ionutms/KiCAD_Symbol_Generator/3D_models/C_1210.step

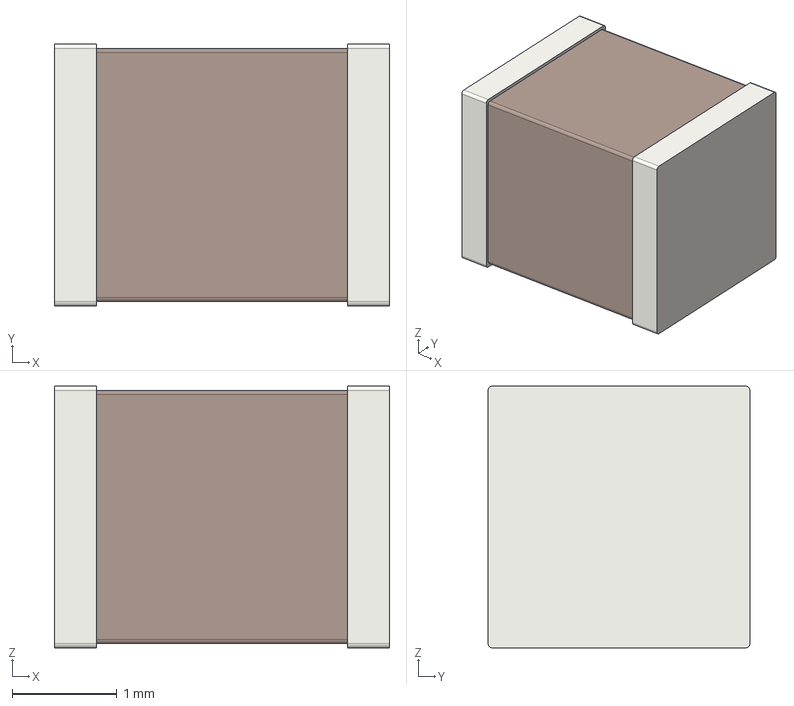
[picture p1: CAD file, 2024-12-10]
3D_models/C_1210.step
3.20 x 2.50 x 2.50 mm
