ionutms/KiCAD_Symbol_Generator/3D_models/SOD_123F.step

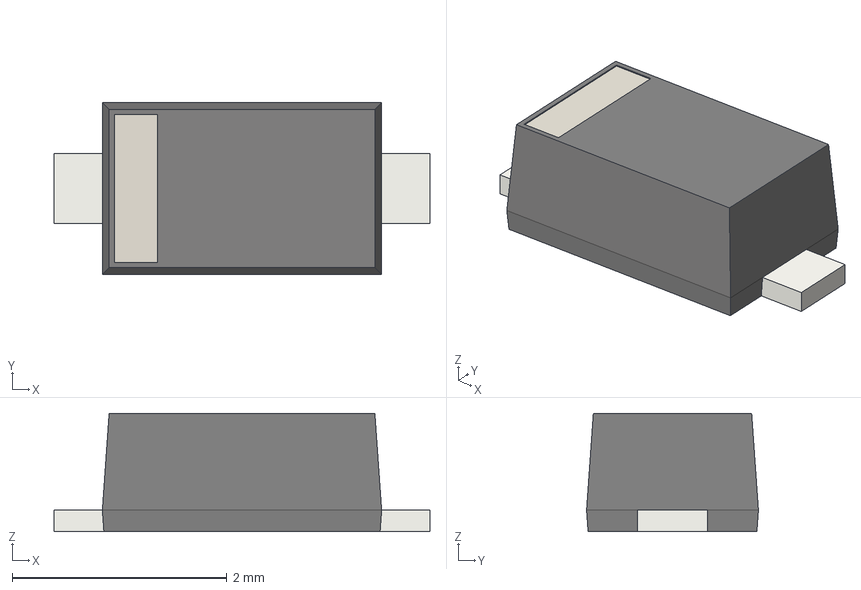
[picture p2: CAD file, 2024-12-09]
3D_models/SOD_123F.step
3.50 x 1.60 x 1.10 mm
