ionutms/KiCAD_Symbol_Generator/3D_models/PowerPAK SO-8.step

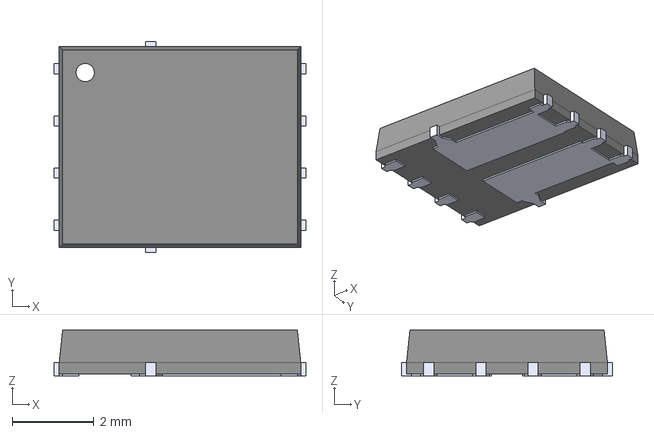
[picture p3: CAD file, 2024-12-05]
3D_models/PowerPAK SO-8.step
6.15 x 5.16 x 1.12 mm
