ionutms/KiCAD_Symbol_Generator/3D_models/LFPAK56D-8.step

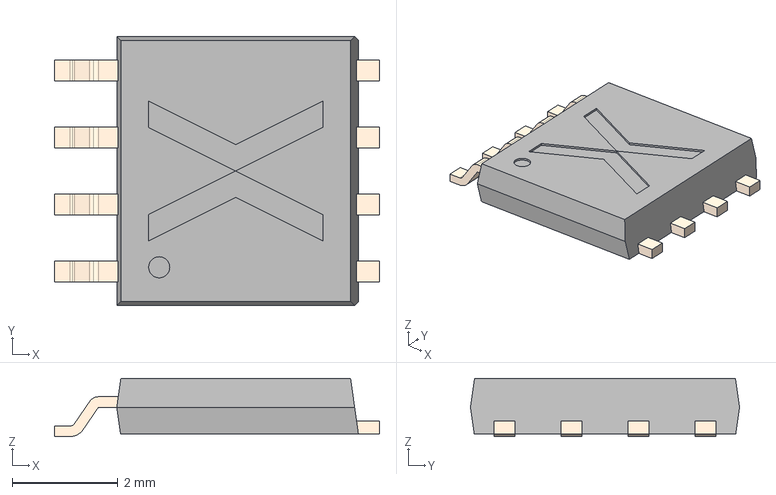
[picture p4: CAD file, 2024-12-03]
3D_models/LFPAK56D-8.step
6.16 x 5.10 x 1.10 mm
