ionutms/KiCAD_Symbol_Generator/3D_models/PowerPAK 1212-8.step

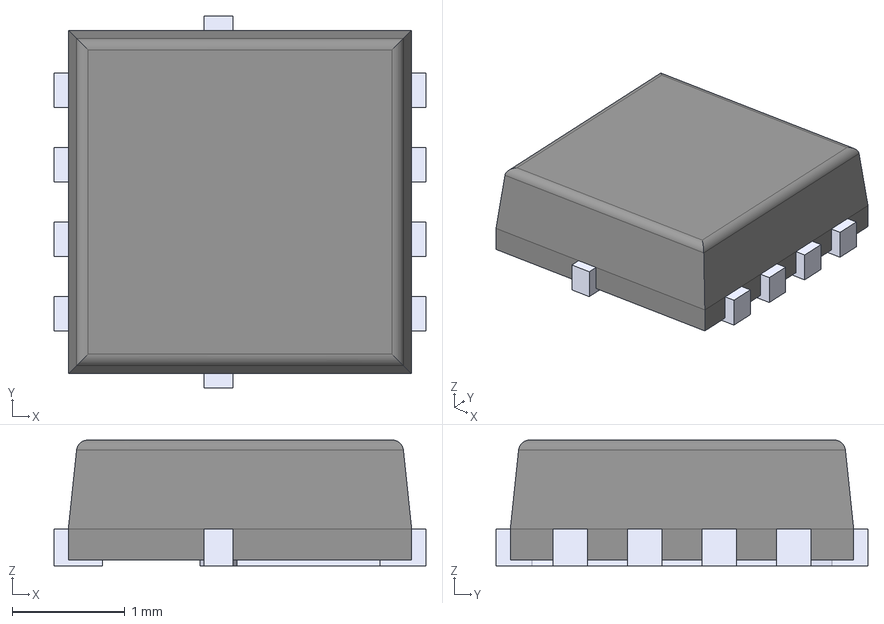
[picture p5: CAD file, 2024-12-03]
3D_models/PowerPAK 1212-8.step
3.30 x 3.30 x 1.12 mm
