ionutms/KiCAD_Symbol_Generator/3D_models/LFPAK33-8.step

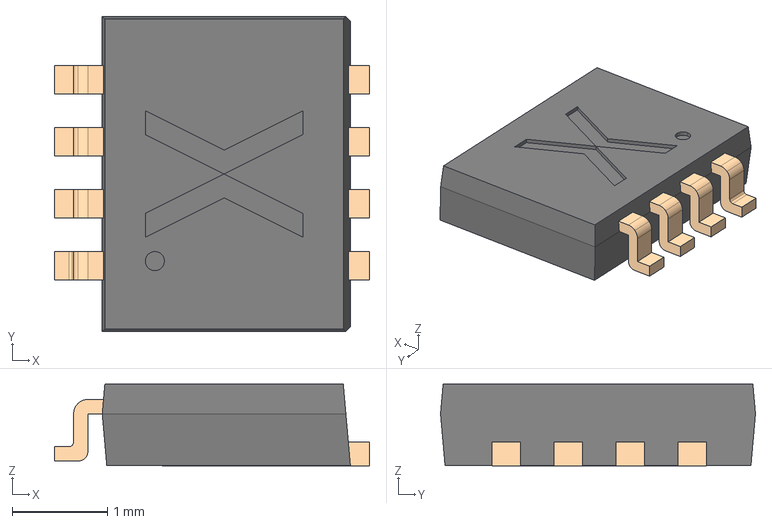
[picture p6: CAD file, 2024-12-03]
3D_models/LFPAK33-8.step
3.30 x 3.30 x 0.855 mm
