ionutms/KiCAD_Symbol_Generator/3D_models/SOD_123.step

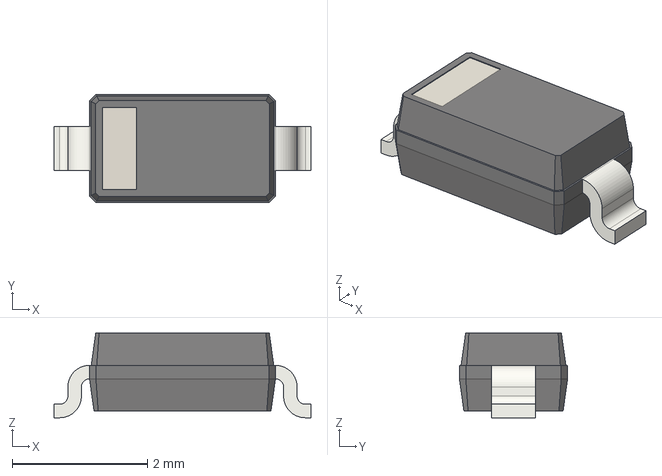
[picture p7: CAD file, 2024-11-30]
3D_models/SOD_123.step
3.80 x 1.60 x 1.25 mm
