ionutms/KiCAD_Symbol_Generator/3D_models/PowerDI_123.step

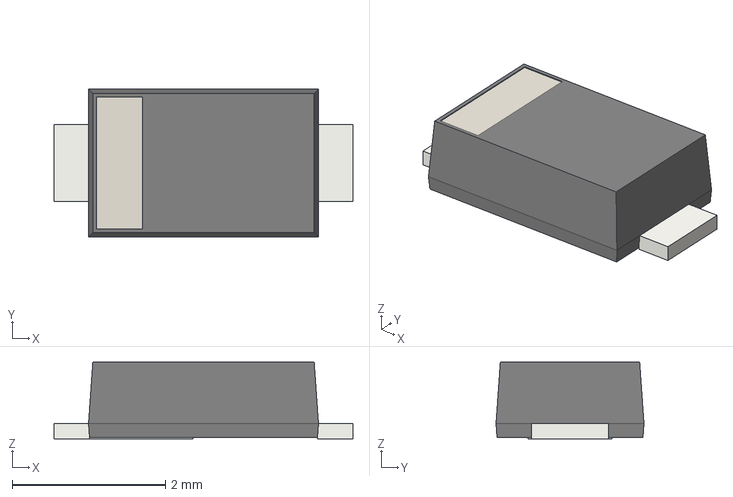
[picture p8: CAD file, 2024-11-26]
3D_models/PowerDI_123.step
3.90 x 1.93 x 1.00 mm
