ionutms/KiCAD_Symbol_Generator/3D_models/ZA9644.step

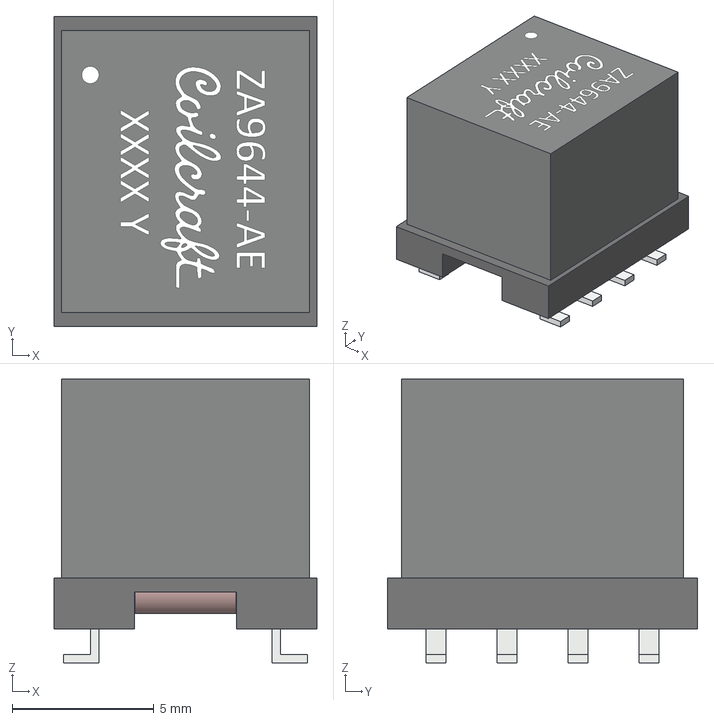
[picture p9: CAD file, 2024-11-20]
3D_models/ZA9644.step
9.25 x 10.9 x 10.0 mm
