ionutms/KiCAD_Symbol_Generator/3D_models/ZA9384.step

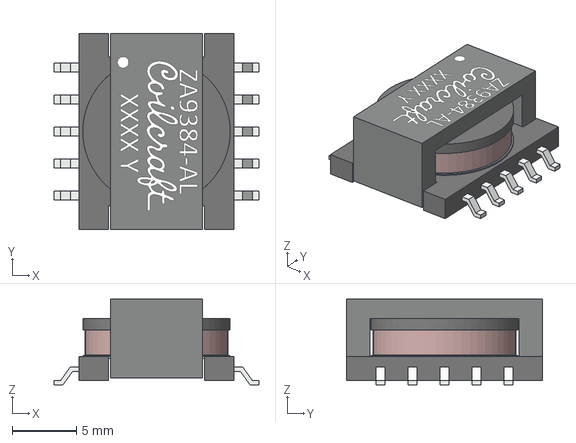
[picture p10: CAD file, 2024-11-20]
3D_models/ZA9384.step
16.0 x 15.3 x 6.70 mm
