ionutms/KiCAD_Symbol_Generator/3D_models/MSD1260.step

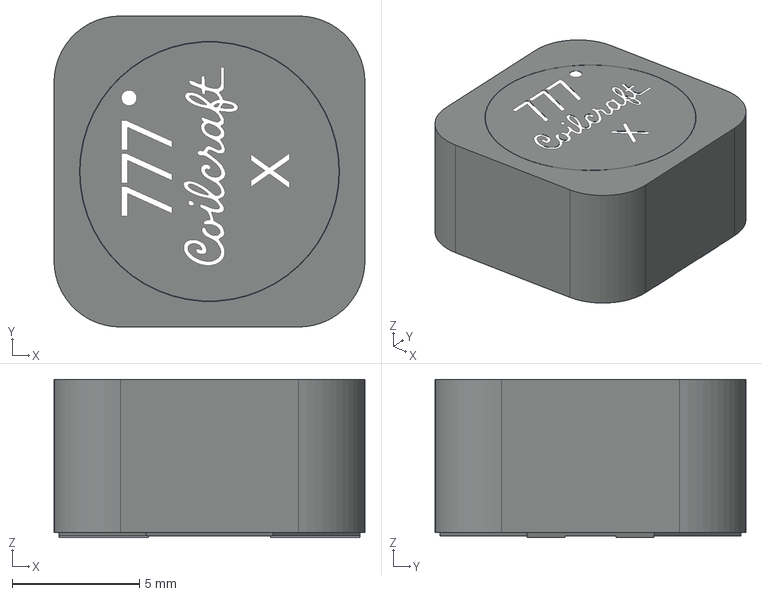
[picture p11: CAD file, 2024-11-20]
3D_models/MSD1260.step
12.2 x 12.2 x 6.20 mm
