ionutms/KiCAD_Symbol_Generator/3D_models/MSD1048.step

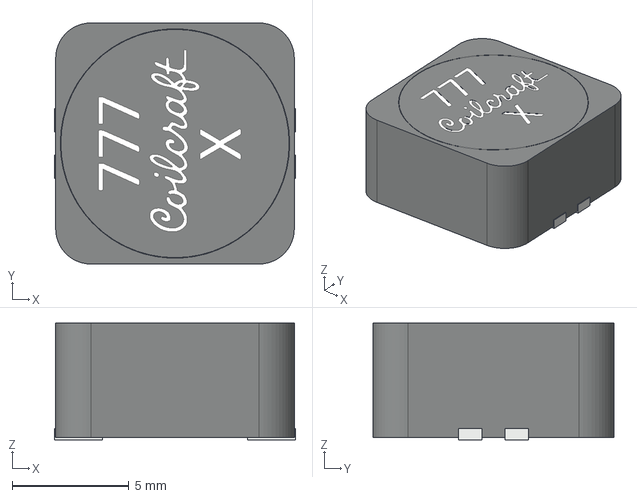
[picture p12: CAD file, 2024-11-20]
3D_models/MSD1048.step
10.3 x 10.3 x 5.00 mm
