ionutms/KiCAD_Symbol_Generator/3D_models/MSD7342.step

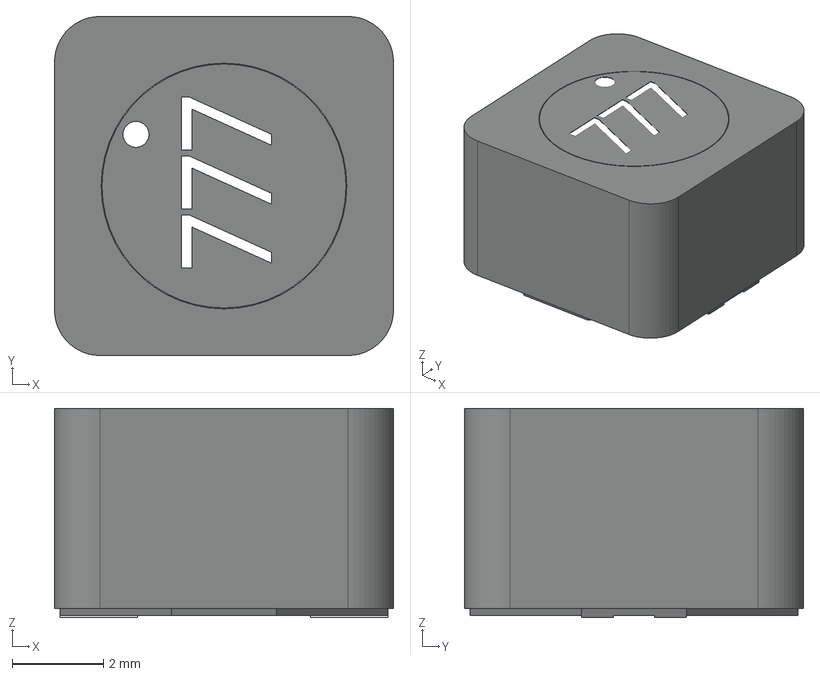
[picture p13: CAD file, 2024-11-20]
3D_models/MSD7342.step
7.45 x 7.45 x 4.60 mm
