ionutms/KiCAD_Symbol_Generator/3D_models/CUI_DEVICES_TBP04R12-500-04BE.step

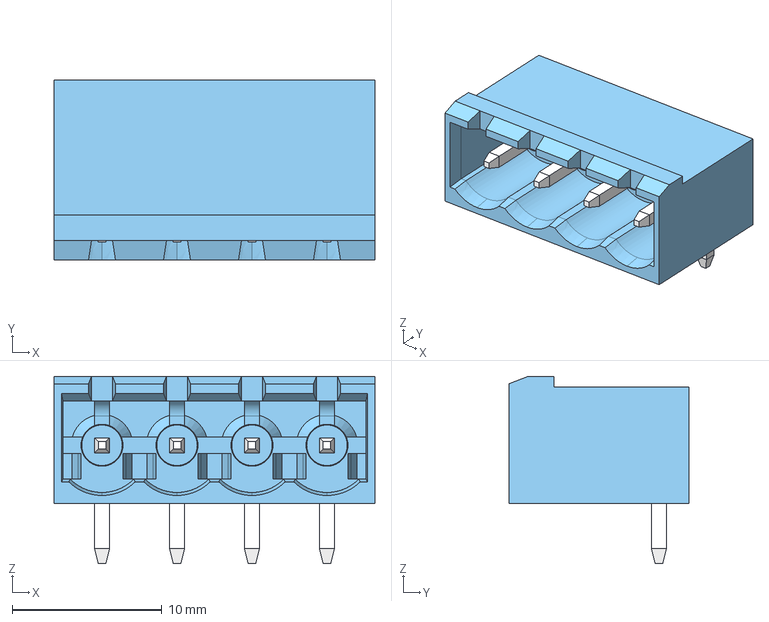
[picture p14: CAD file, 2024-11-18]
3D_models/CUI_DEVICES_TBP04R12-500-04BE.step
21.4 x 12.0 x 12.5 mm
