ionutms/KiCAD_Symbol_Generator/3D_models/CUI_DEVICES_TBP04R12-500-05BE.step

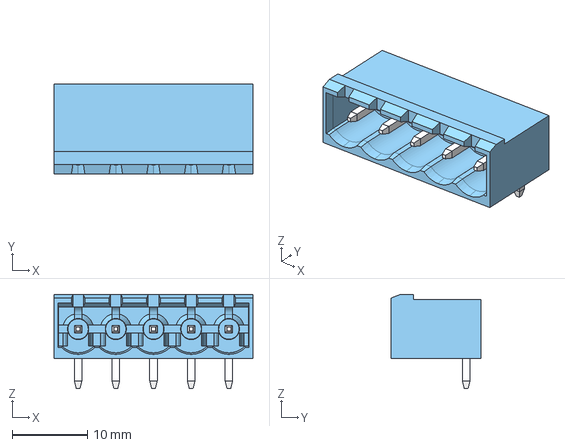
[picture p16: CAD file, 2024-11-18]
3D_models/CUI_DEVICES_TBP04R12-500-05BE.step
26.4 x 12.0 x 12.5 mm
