ionutms/KiCAD_Symbol_Generator/3D_models/CUI_DEVICES_TBP04R12-500-08BE.step

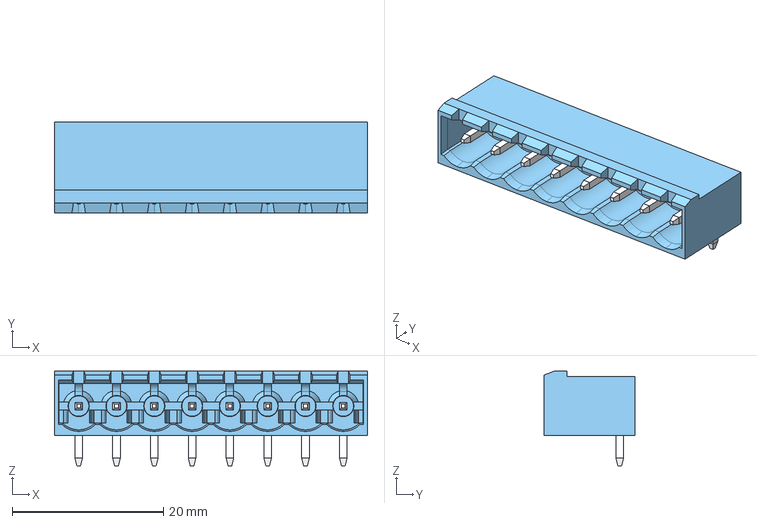
[picture p17: CAD file, 2024-11-18]
3D_models/CUI_DEVICES_TBP04R12-500-08BE.step
41.4 x 12.0 x 12.5 mm
