ionutms/KiCAD_Symbol_Generator/3D_models/CUI_DEVICES_TBP04R12-500-03BE.step

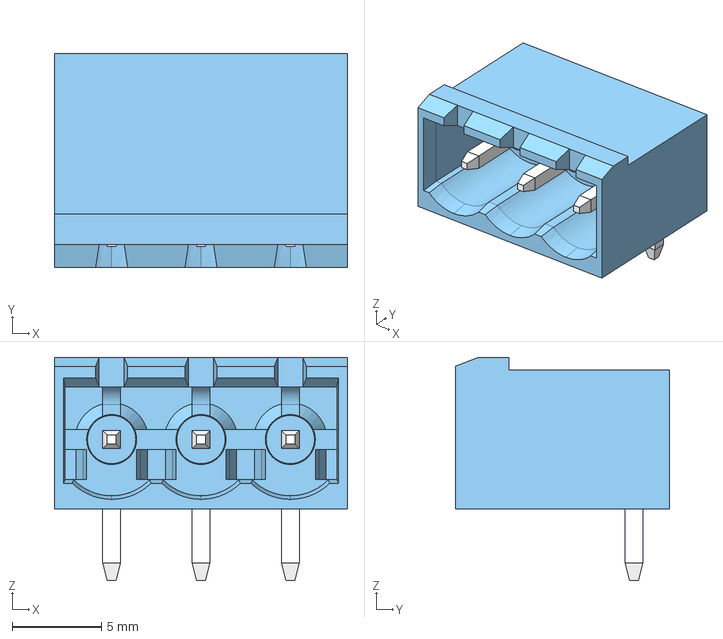
[picture p19: CAD file, 2024-11-18]
3D_models/CUI_DEVICES_TBP04R12-500-03BE.step
16.4 x 12.0 x 12.5 mm
