ionutms/KiCAD_Symbol_Generator/3D_models/CUI_DEVICES_TBP04R12-500-09BE.step

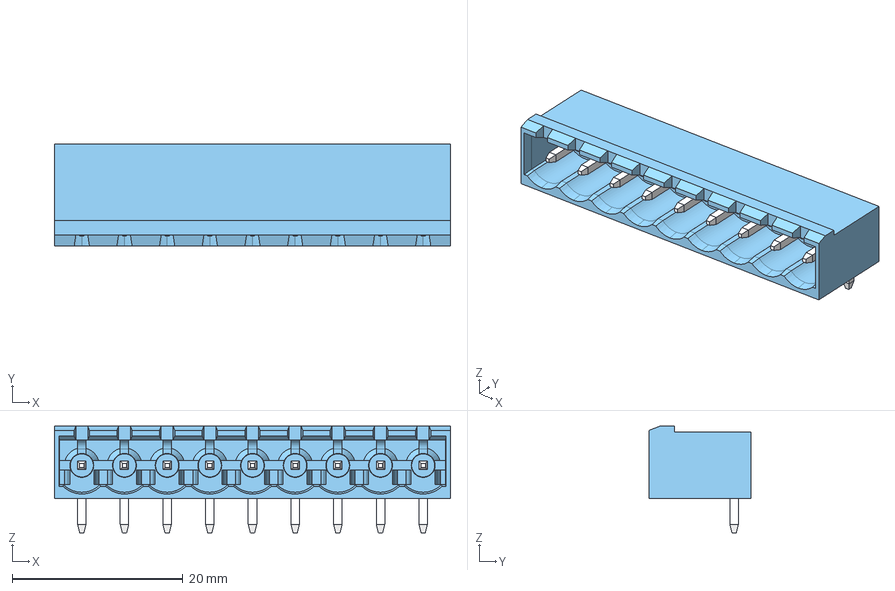
[picture p23: CAD file, 2024-11-18]
3D_models/CUI_DEVICES_TBP04R12-500-09BE.step
46.4 x 12.0 x 12.5 mm
