ionutms/KiCAD_Symbol_Generator/3D_models/CUI_DEVICES_TBP04R3-500-03BE.step

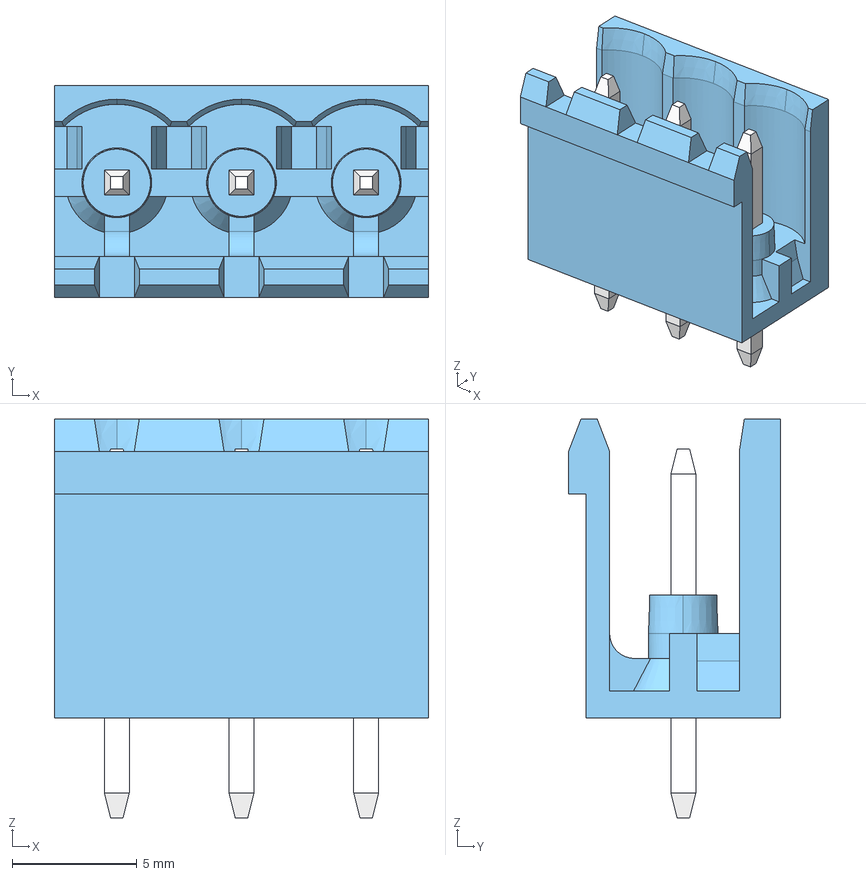
[picture p25: CAD file, 2024-11-18]
3D_models/CUI_DEVICES_TBP04R3-500-03BE.step
15.0 x 8.50 x 16.0 mm
