ionutms/KiCAD_Symbol_Generator/3D_models/CUI_DEVICES_TBP04R2-500-08BE.step

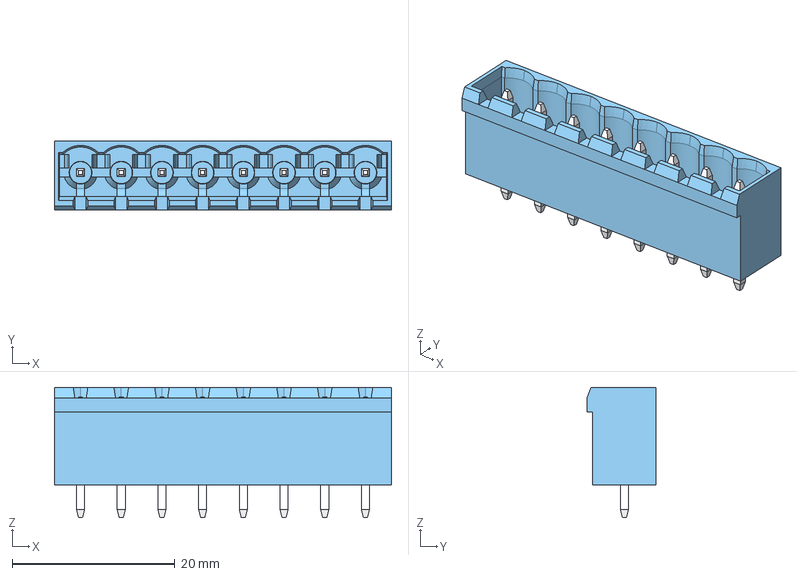
[picture p28: CAD file, 2024-11-18]
3D_models/CUI_DEVICES_TBP04R2-500-08BE.step
41.4 x 8.50 x 16.0 mm
