ionutms/KiCAD_Symbol_Generator/3D_models/CUI_DEVICES_TBP04R2-500-06BE.step

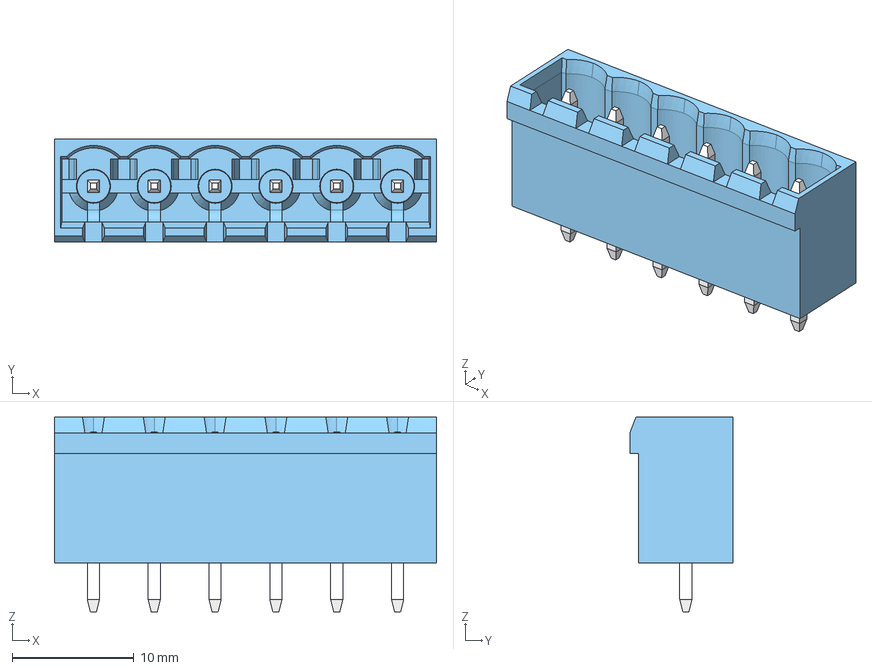
[picture p31: CAD file, 2024-11-18]
3D_models/CUI_DEVICES_TBP04R2-500-06BE.step
31.4 x 8.50 x 16.0 mm
