ionutms/KiCAD_Symbol_Generator/3D_models/CUI_DEVICES_TBP04R1-500-08BE.step

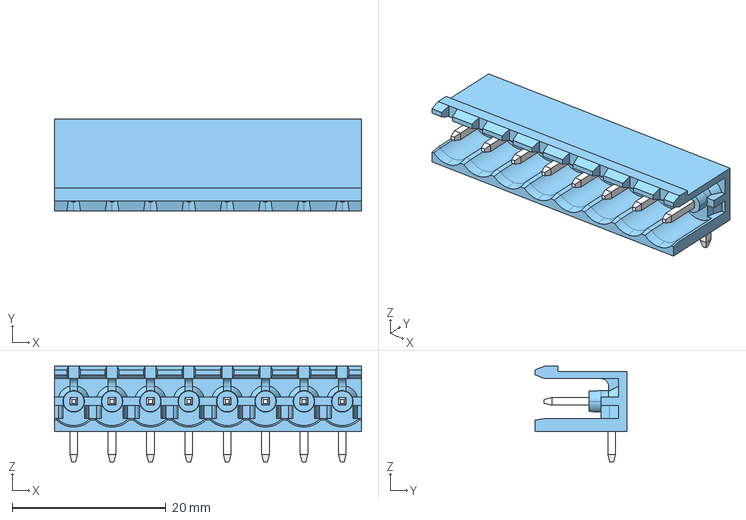
[picture p40: CAD file, 2024-11-18]
3D_models/CUI_DEVICES_TBP04R1-500-08BE.step
40.0 x 12.0 x 12.5 mm
