ionutms/KiCAD_Symbol_Generator/3D_models/CUI_DEVICES_TBP04R1-500-11BE.step

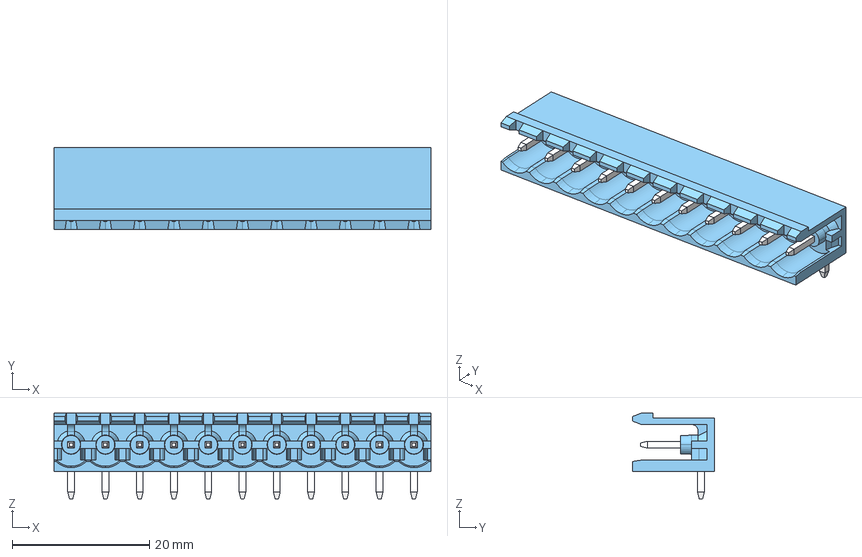
[picture p47: CAD file, 2024-11-18]
3D_models/CUI_DEVICES_TBP04R1-500-11BE.step
55.0 x 12.0 x 12.5 mm
