ionutms/KiCAD_Symbol_Generator/3D_models/CUI_DEVICES_TBP02R2-381-06BE.step

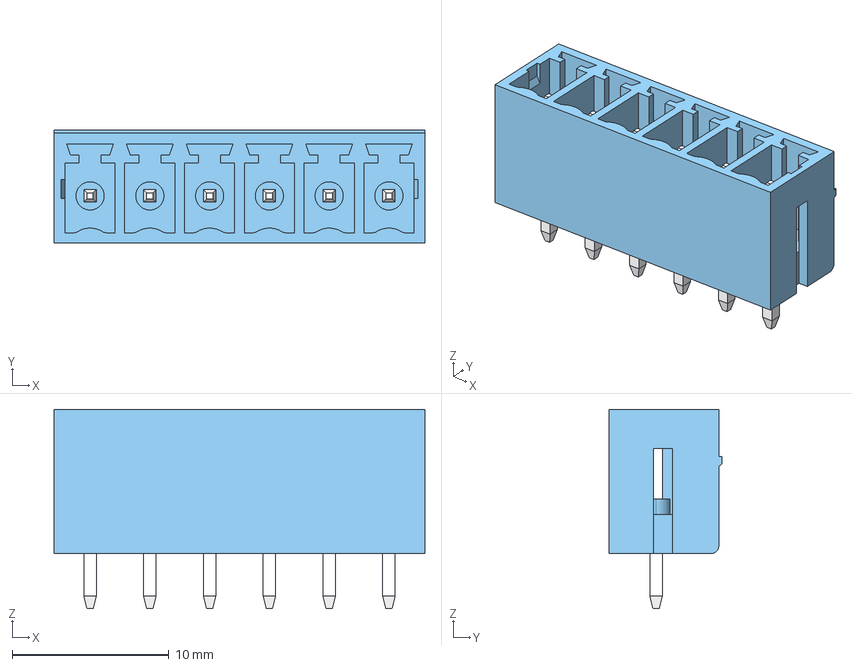
[picture p50: CAD file, 2024-11-18]
3D_models/CUI_DEVICES_TBP02R2-381-06BE.step
23.6 x 7.20 x 12.7 mm
