ionutms/KiCAD_Symbol_Generator/3D_models/CUI_DEVICES_TBP02R2-381-03BE.step

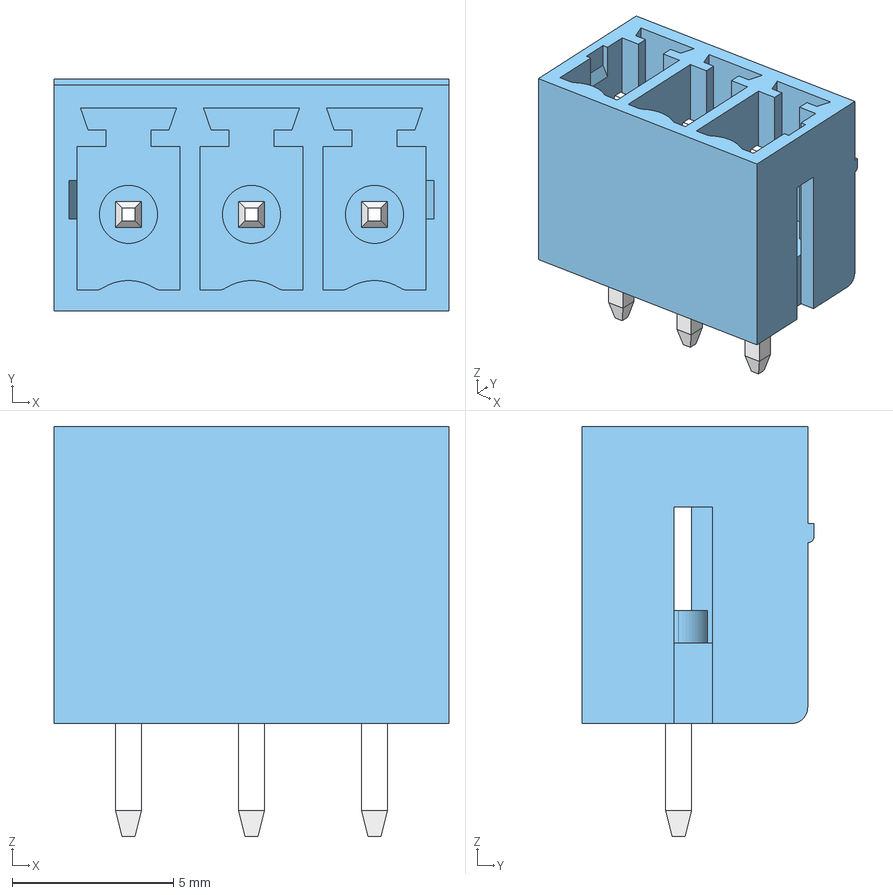
[picture p52: CAD file, 2024-11-18]
3D_models/CUI_DEVICES_TBP02R2-381-03BE.step
12.2 x 7.20 x 12.7 mm
