ionutms/KiCAD_Symbol_Generator/3D_models/CUI_DEVICES_TBP02R2-381-12BE.step

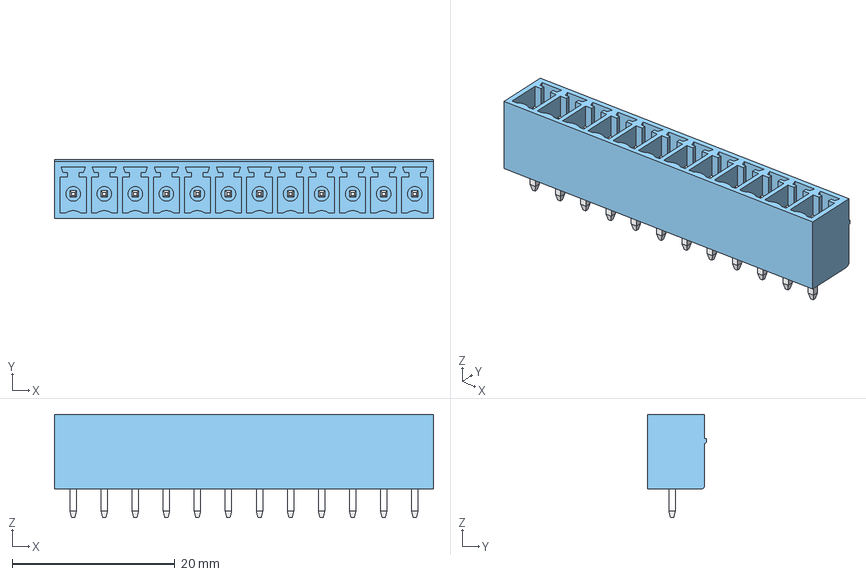
[picture p53: CAD file, 2024-11-18]
3D_models/CUI_DEVICES_TBP02R2-381-12BE.step
46.5 x 7.20 x 12.7 mm
