ionutms/KiCAD_Symbol_Generator/3D_models/CUI_DEVICES_TBP02R2-381-05BE.step

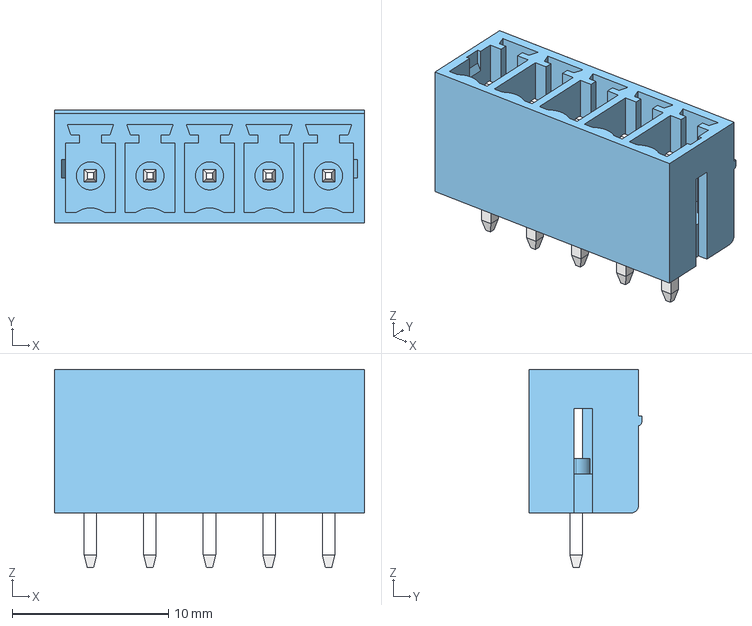
[picture p57: CAD file, 2024-11-18]
3D_models/CUI_DEVICES_TBP02R2-381-05BE.step
19.8 x 7.20 x 12.7 mm
