ionutms/KiCAD_Symbol_Generator/3D_models/CUI_DEVICES_TBP02R1-381-03BE.step

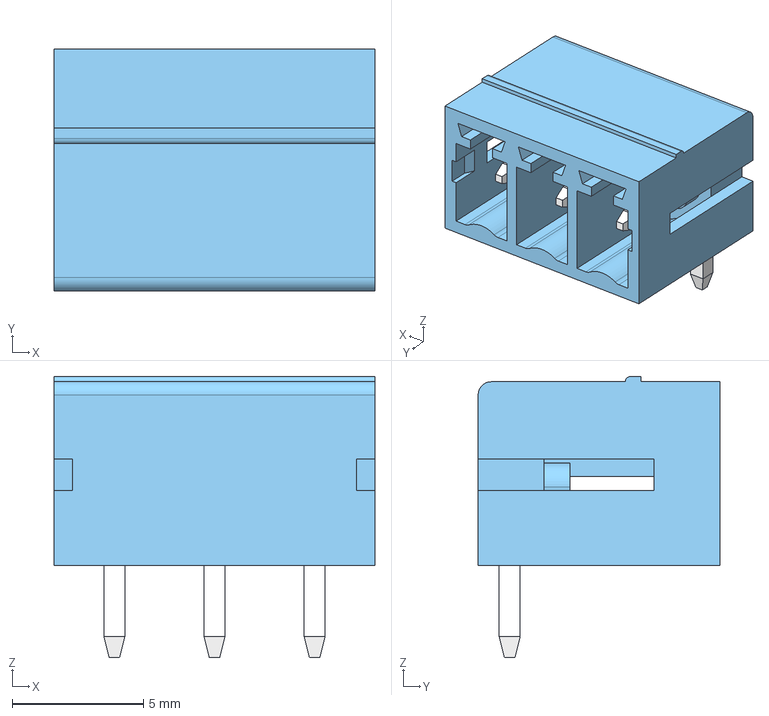
[picture p62: CAD file, 2024-11-18]
3D_models/CUI_DEVICES_TBP02R1-381-03BE.step
12.2 x 9.20 x 10.7 mm
