ionutms/KiCAD_Symbol_Generator/3D_models/XFL7015.step

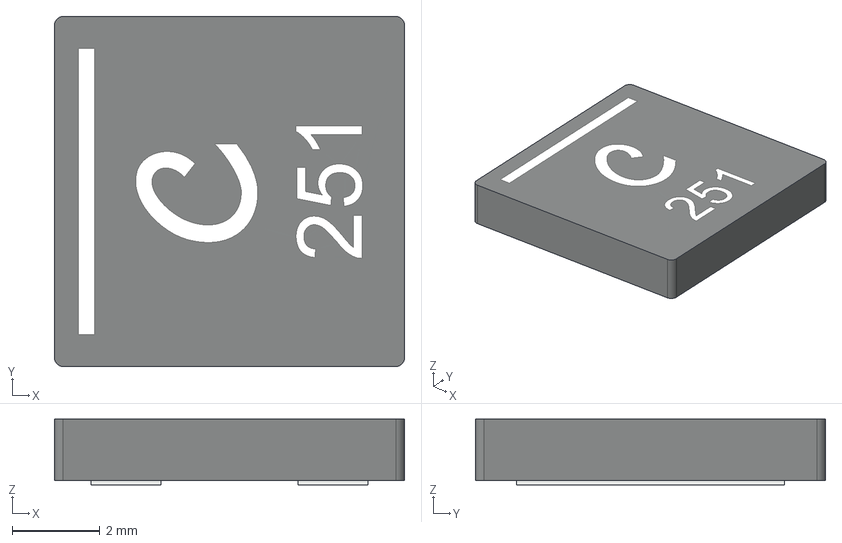
[picture p70: CAD file, 2024-11-16]
3D_models/XFL7015.step
8.00 x 8.00 x 1.50 mm
