ionutms/KiCAD_Symbol_Generator/3D_models/XFL6012.step

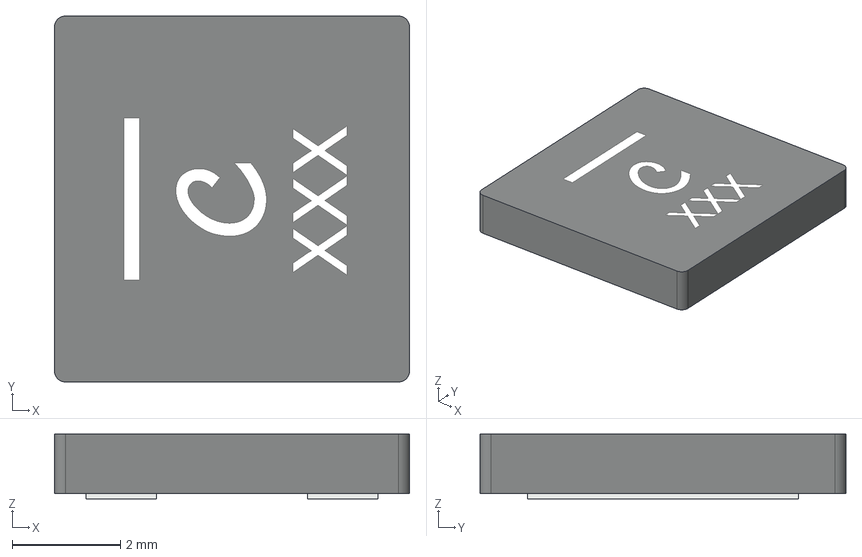
[picture p71: CAD file, 2024-11-16]
3D_models/XFL6012.step
6.56 x 6.76 x 1.20 mm
