ionutms/KiCAD_Symbol_Generator/3D_models/XFL6060.step

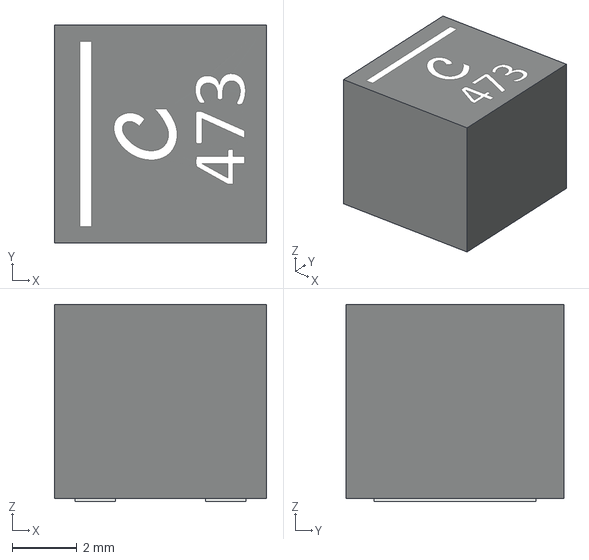
[picture p72: CAD file, 2024-11-16]
3D_models/XFL6060.step
6.56 x 6.76 x 6.10 mm
