ionutms/KiCAD_Symbol_Generator/3D_models/XFL5015.step

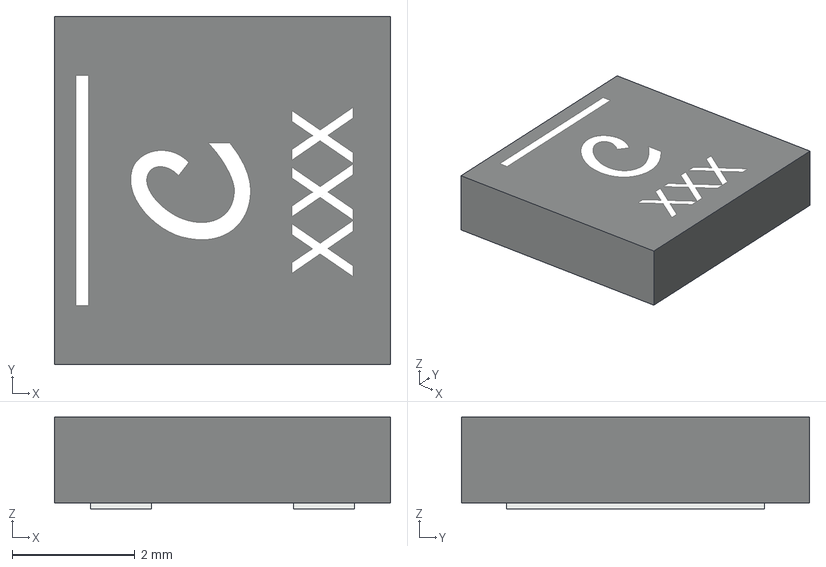
[picture p73: CAD file, 2024-11-16]
3D_models/XFL5015.step
5.48 x 5.68 x 1.50 mm
