ionutms/KiCAD_Symbol_Generator/3D_models/XFL5030.step

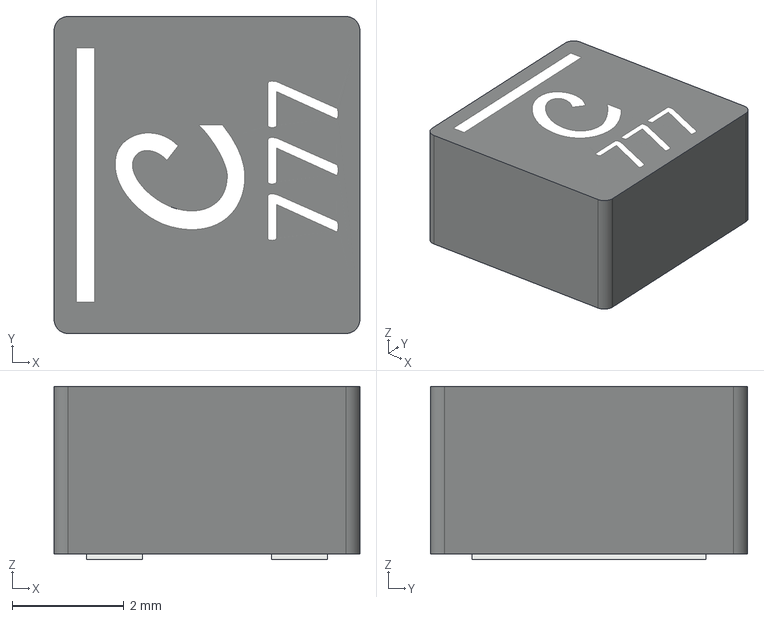
[picture p74: CAD file, 2024-11-16]
3D_models/XFL5030.step
5.48 x 5.68 x 3.10 mm
