ionutms/KiCAD_Symbol_Generator/3D_models/XFL4030.step

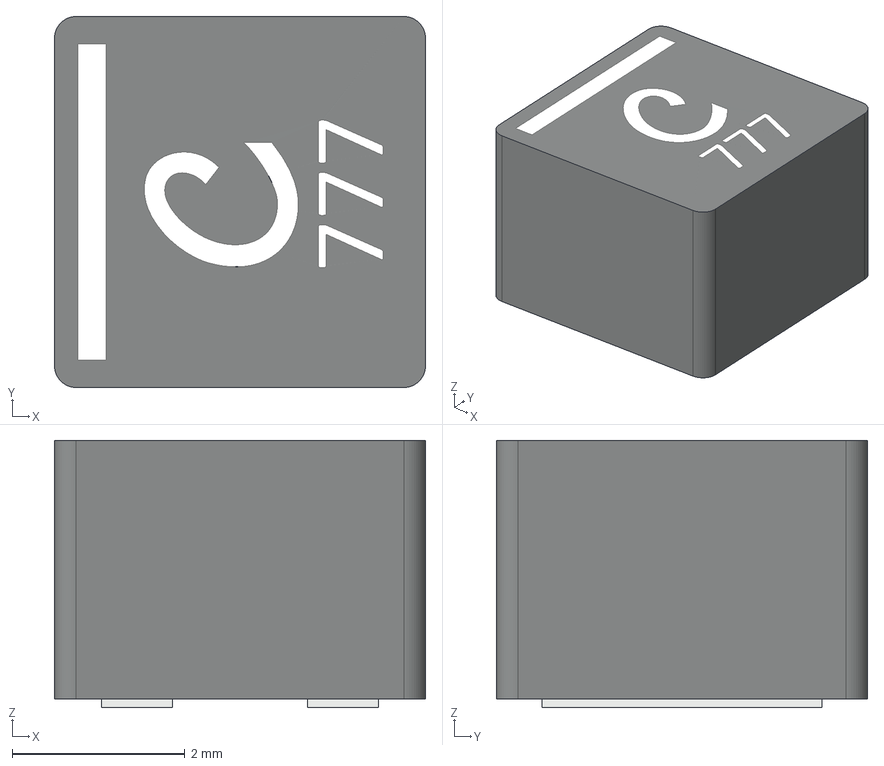
[picture p75: CAD file, 2024-11-16]
3D_models/XFL4030.step
4.30 x 4.30 x 3.10 mm
