ionutms/KiCAD_Symbol_Generator/3D_models/XFL4012.step

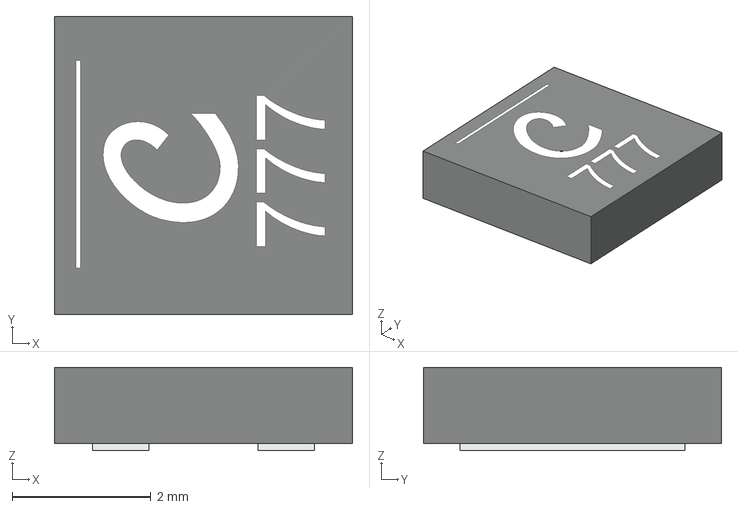
[picture p76: CAD file, 2024-11-16]
3D_models/XFL4012.step
4.30 x 4.30 x 1.20 mm
