ionutms/KiCAD_Symbol_Generator/3D_models/XFL4015.step

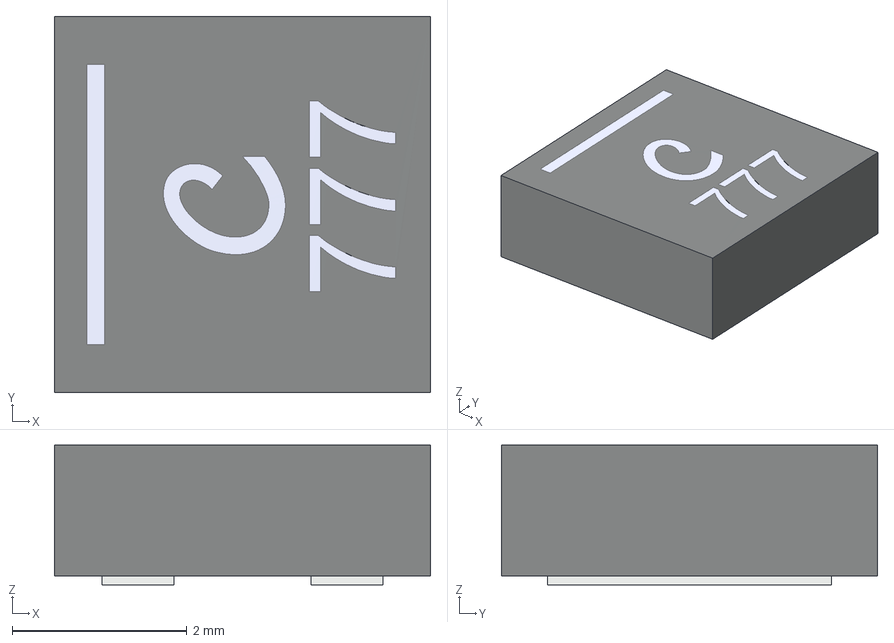
[picture p77: CAD file, 2024-11-16]
3D_models/XFL4015.step
4.30 x 4.30 x 1.60 mm
