ionutms/KiCAD_Symbol_Generator/3D_models/XFL4020.step

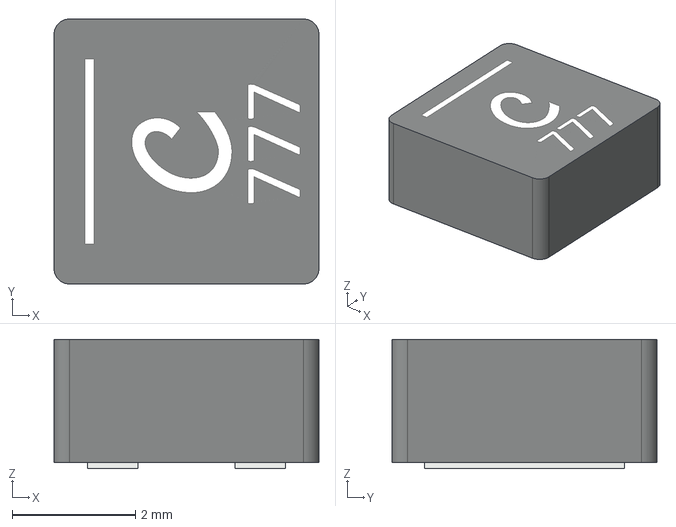
[picture p78: CAD file, 2024-11-16]
3D_models/XFL4020.step
4.30 x 4.30 x 2.10 mm
