ionutms/KiCAD_Symbol_Generator/3D_models/XFL3010.step

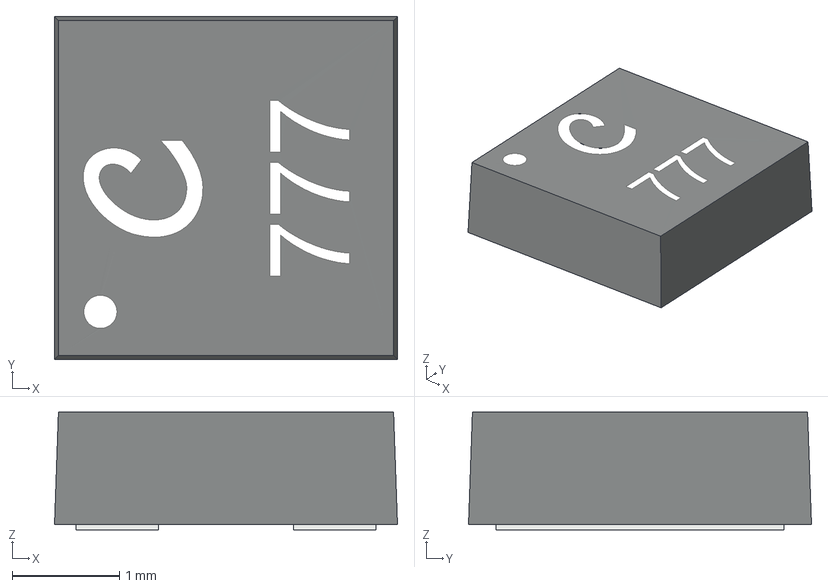
[picture p79: CAD file, 2024-11-16]
3D_models/XFL3010.step
3.20 x 3.20 x 1.10 mm
