ionutms/KiCAD_Symbol_Generator/3D_models/XFL3012.step

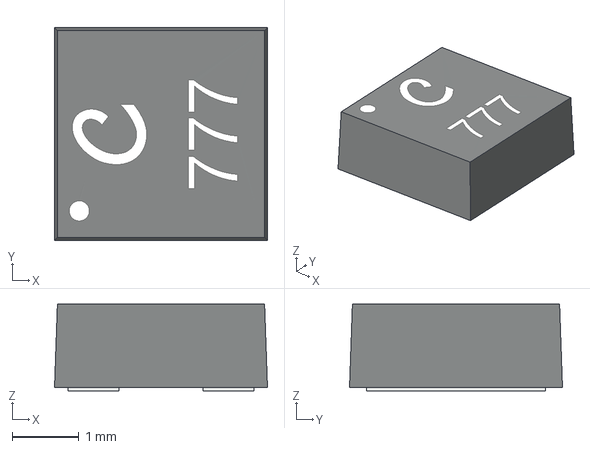
[picture p80: CAD file, 2024-11-16]
3D_models/XFL3012.step
3.20 x 3.20 x 1.30 mm
