ionutms/KiCAD_Symbol_Generator/3D_models/XFL2006.step

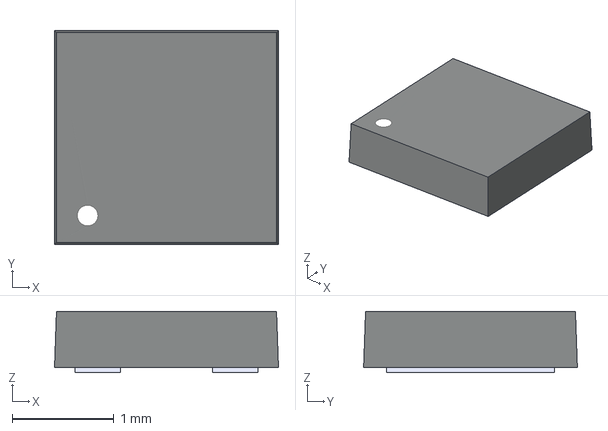
[picture p81: CAD file, 2024-11-16]
3D_models/XFL2006.step
2.20 x 2.10 x 0.6 mm
