ionutms/KiCAD_Symbol_Generator/3D_models/XFL2010.step

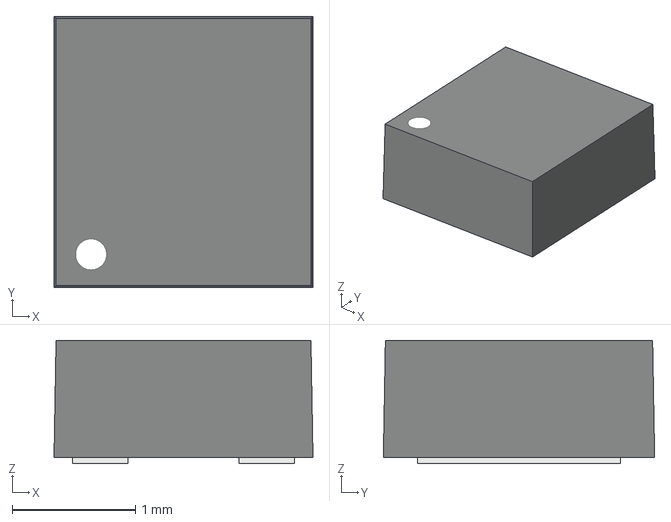
[picture p82: CAD file, 2024-11-16]
3D_models/XFL2010.step
2.10 x 2.20 x 1.00 mm
