ionutms/KiCAD_Symbol_Generator/3D_models/XFL2005.step

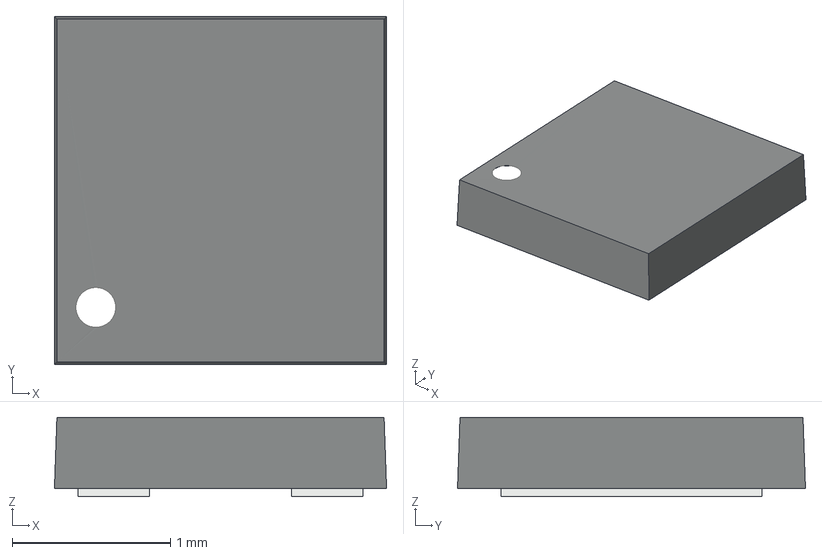
[picture p83: CAD file, 2024-11-16]
3D_models/XFL2005.step
2.10 x 2.20 x 0.5 mm
