ionutms/KiCAD_Symbol_Generator/3D_models/XAL8050.step

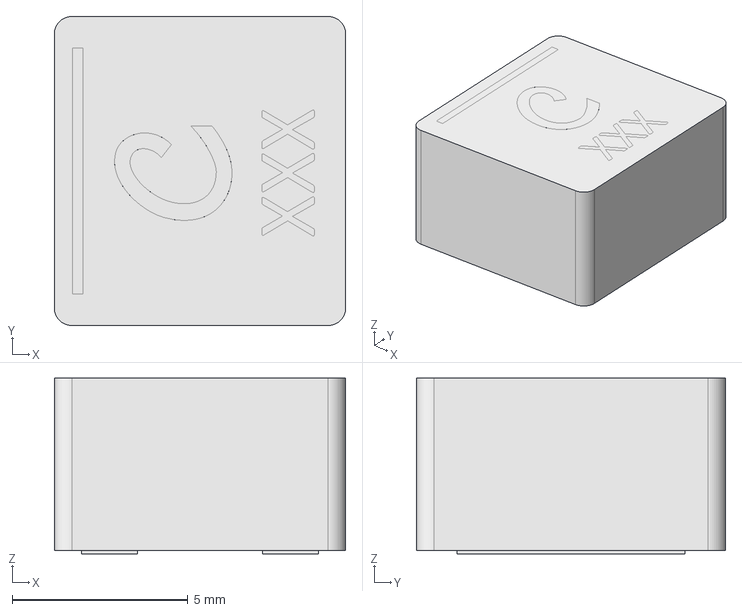
[picture p84: CAD file, 2024-11-16]
3D_models/XAL8050.step
8.30 x 8.80 x 5.00 mm
