ionutms/KiCAD_Symbol_Generator/3D_models/XAL8080.step

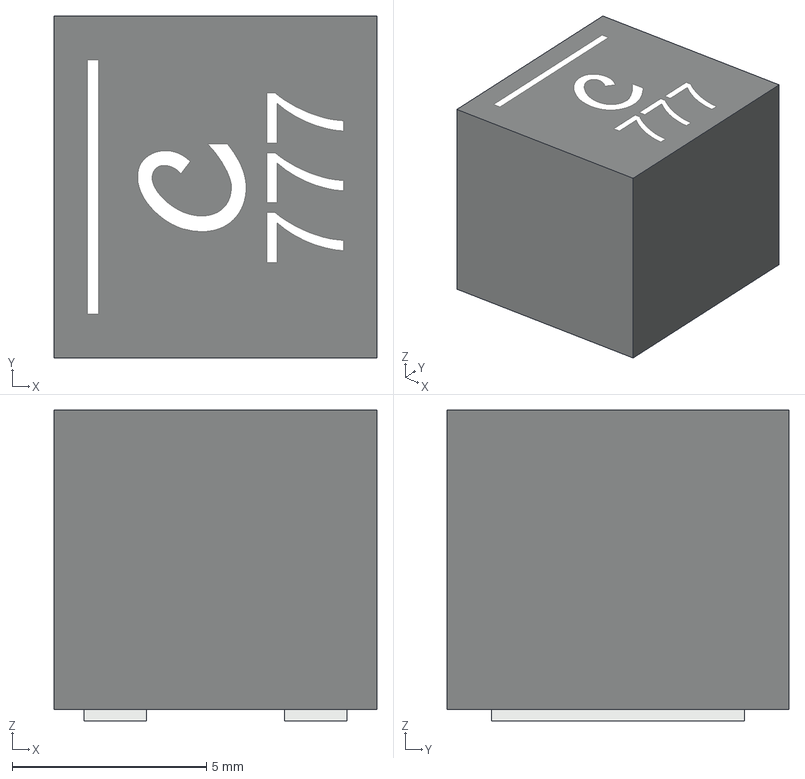
[picture p85: CAD file, 2024-11-16]
3D_models/XAL8080.step
8.30 x 8.80 x 8.00 mm
