ionutms/KiCAD_Symbol_Generator/3D_models/XAL7050.step

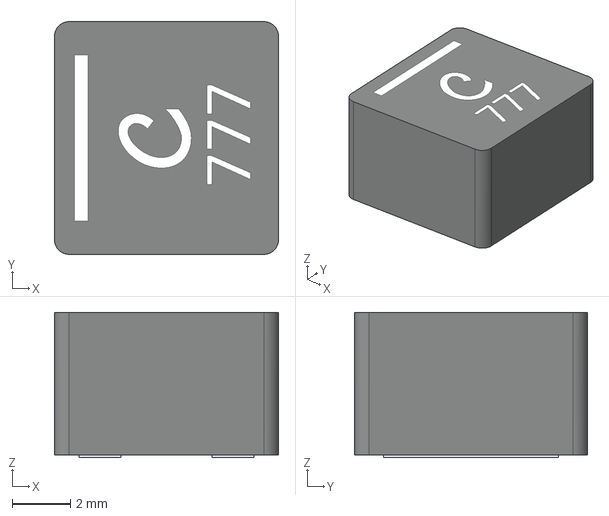
[picture p86: CAD file, 2024-11-16]
3D_models/XAL7050.step
7.70 x 8.00 x 5.00 mm
