ionutms/KiCAD_Symbol_Generator/3D_models/XAL7020.step

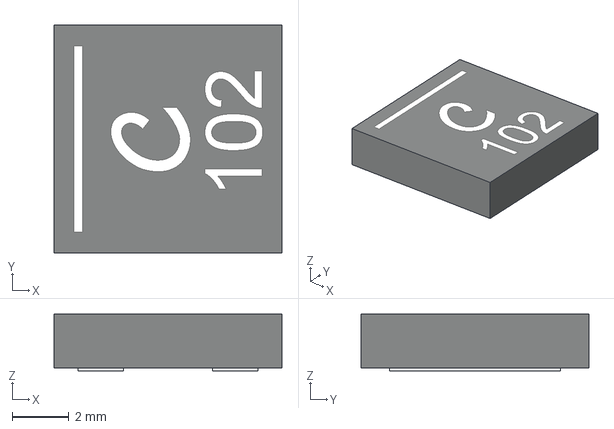
[picture p87: CAD file, 2024-11-16]
3D_models/XAL7020.step
8.00 x 8.00 x 2.00 mm
