ionutms/KiCAD_Symbol_Generator/3D_models/XAL7070.step

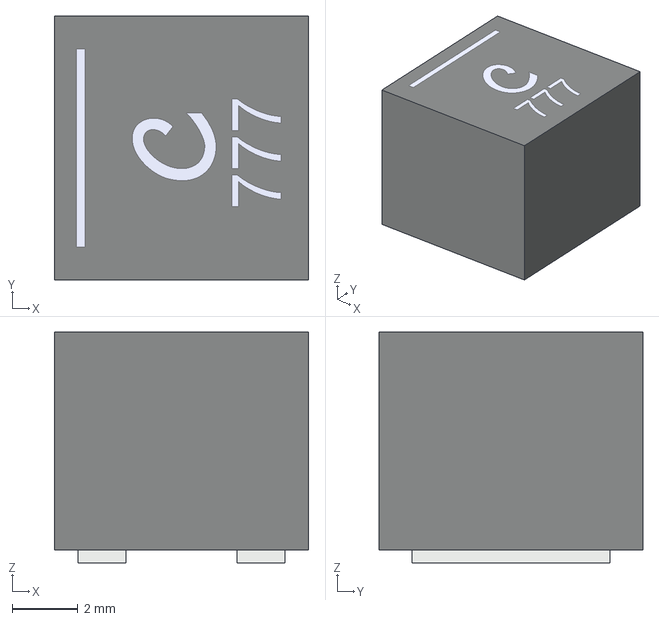
[picture p88: CAD file, 2024-11-16]
3D_models/XAL7070.step
7.70 x 8.00 x 7.00 mm
