ionutms/KiCAD_Symbol_Generator/3D_models/XAL7030.step

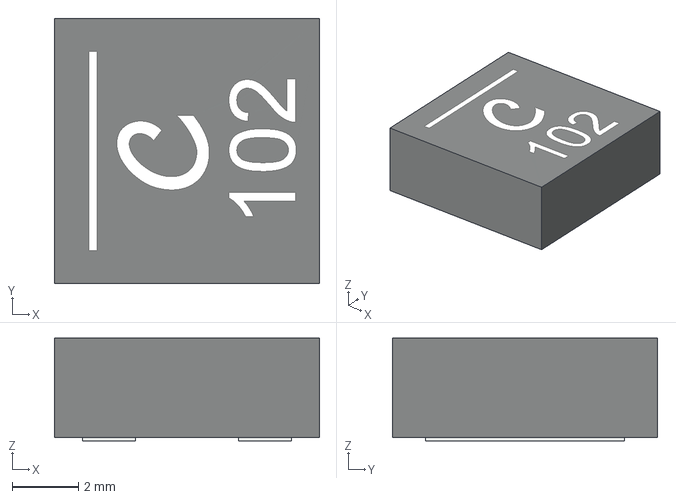
[picture p89: CAD file, 2024-11-16]
3D_models/XAL7030.step
8.00 x 8.00 x 3.10 mm
