ionutms/KiCAD_Symbol_Generator/3D_models/XAL6030.step

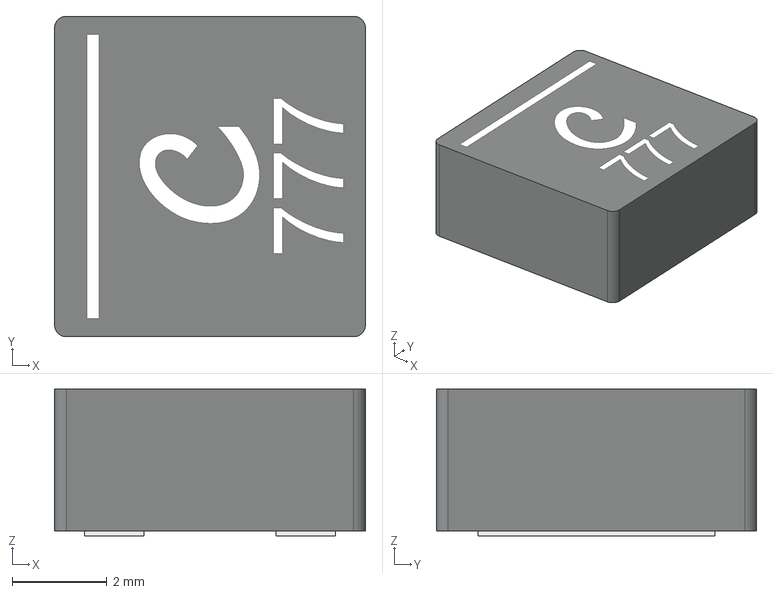
[picture p90: CAD file, 2024-11-16]
3D_models/XAL6030.step
6.56 x 6.76 x 3.10 mm
