ionutms/KiCAD_Symbol_Generator/3D_models/XAL6020.step

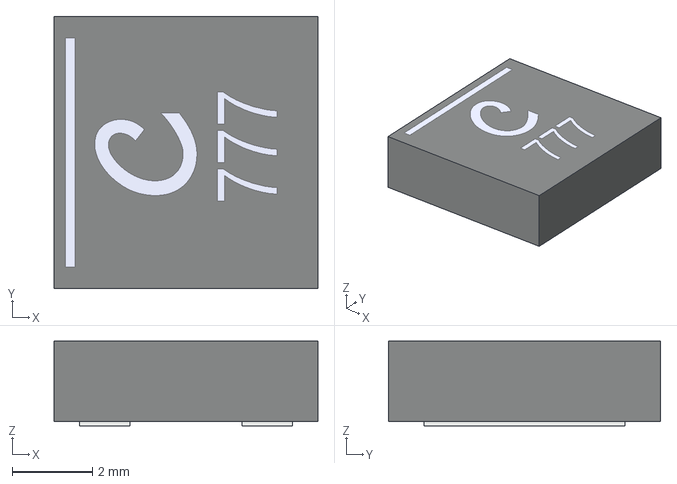
[picture p91: CAD file, 2024-11-16]
3D_models/XAL6020.step
6.56 x 6.76 x 2.10 mm
