ionutms/KiCAD_Symbol_Generator/3D_models/XAL5020.step

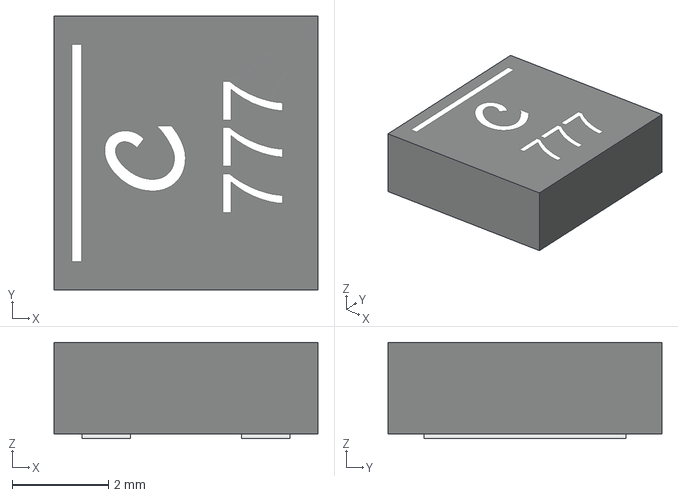
[picture p92: CAD file, 2024-11-16]
3D_models/XAL5020.step
5.48 x 5.68 x 2.00 mm
