ionutms/KiCAD_Symbol_Generator/3D_models/XAL5050.step

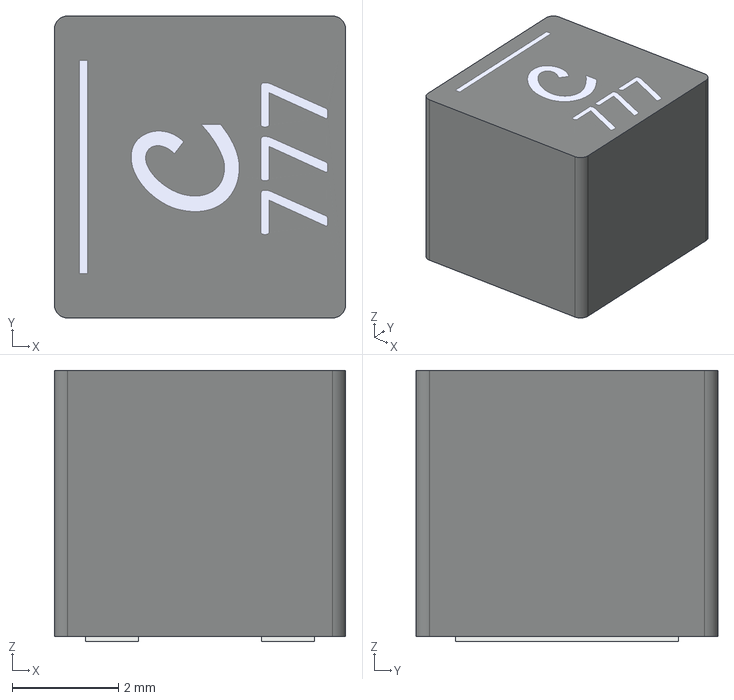
[picture p93: CAD file, 2024-11-16]
3D_models/XAL5050.step
5.48 x 5.68 x 5.10 mm
