ionutms/KiCAD_Symbol_Generator/3D_models/XAL4040.step

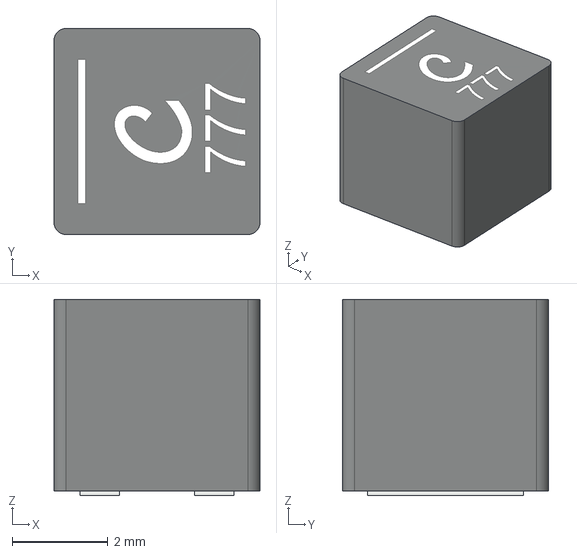
[picture p94: CAD file, 2024-11-16]
3D_models/XAL4040.step
4.30 x 4.30 x 4.10 mm
