ionutms/KiCAD_Symbol_Generator/3D_models/XAL1580.step

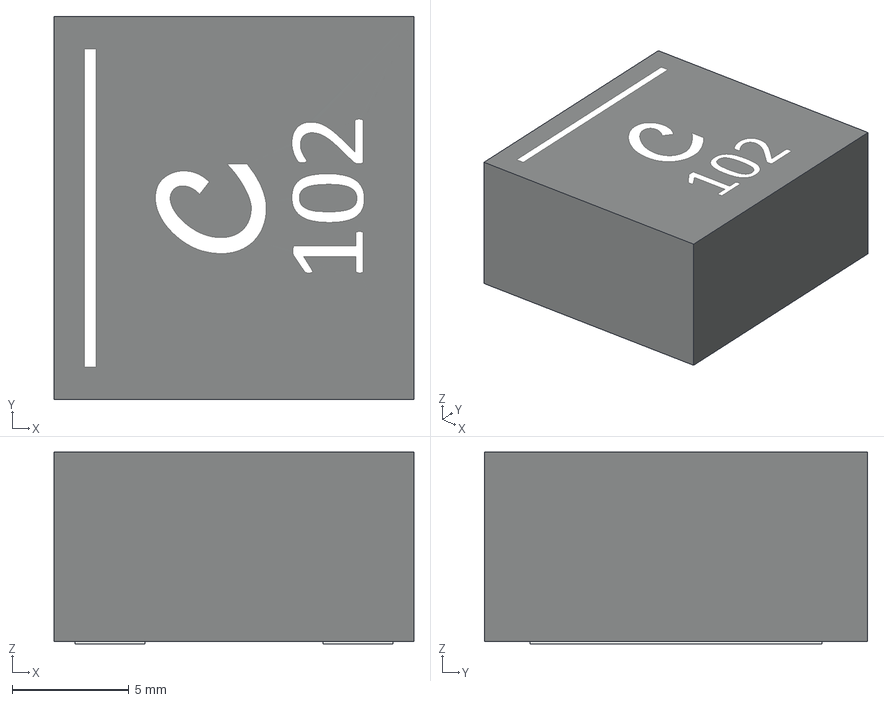
[picture p95: CAD file, 2024-11-16]
3D_models/XAL1580.step
15.4 x 16.4 x 8.20 mm
