ionutms/KiCAD_Symbol_Generator/3D_models/XAL1513.step

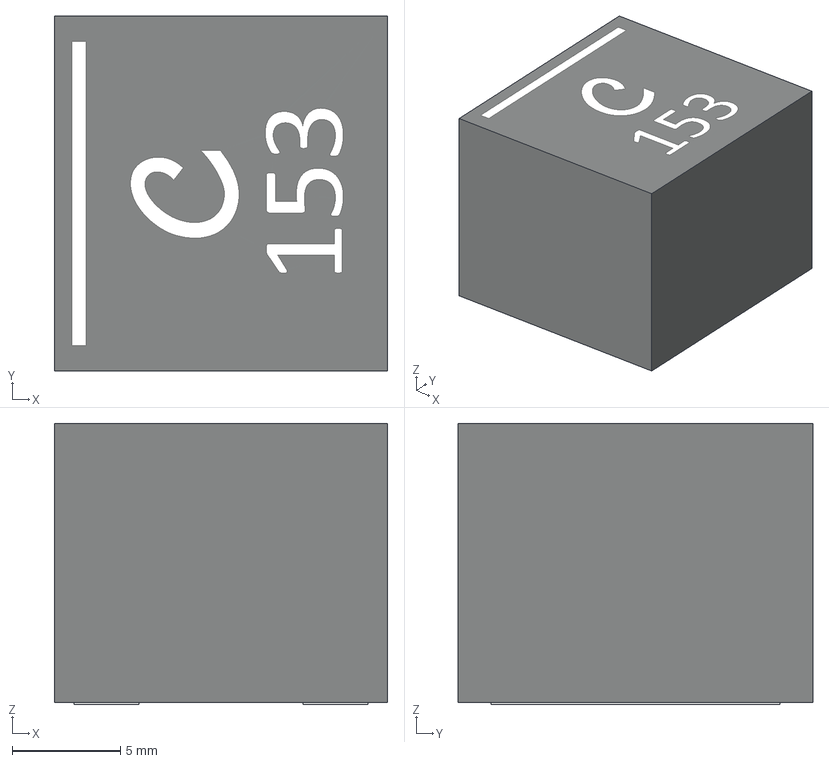
[picture p96: CAD file, 2024-11-16]
3D_models/XAL1513.step
15.4 x 16.4 x 13.0 mm
