ionutms/KiCAD_Symbol_Generator/3D_models/XAL1510.step

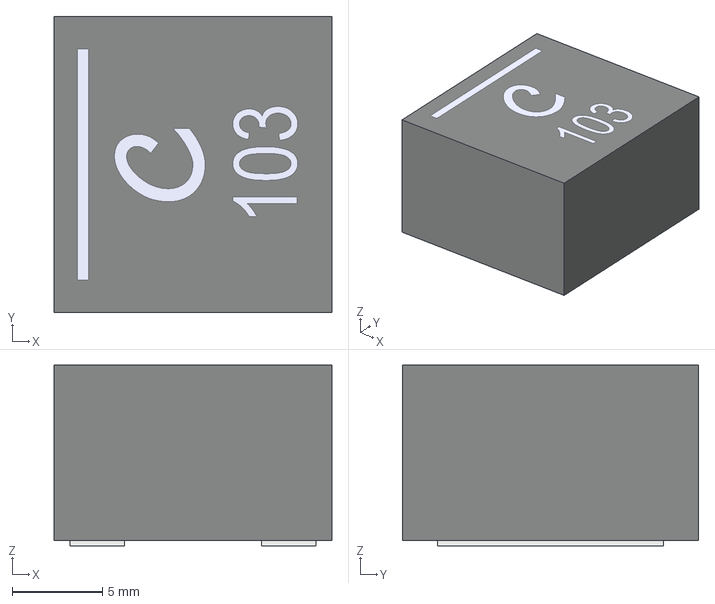
[picture p97: CAD file, 2024-11-16]
3D_models/XAL1510.step
15.4 x 16.4 x 10.0 mm
