ionutms/KiCAD_Symbol_Generator/3D_models/XAL1350.step

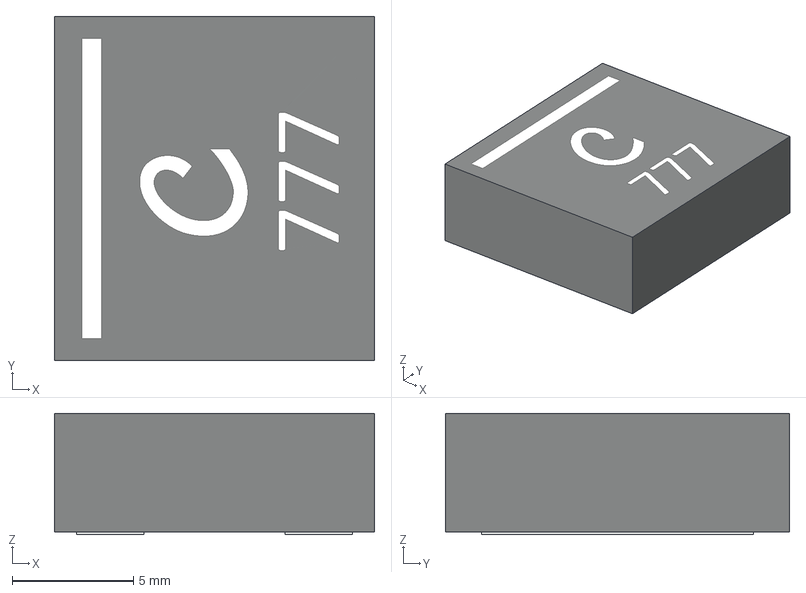
[picture p98: CAD file, 2024-11-16]
3D_models/XAL1350.step
13.2 x 14.2 x 5.00 mm
