ionutms/KiCAD_Symbol_Generator/3D_models/XAL1060.step

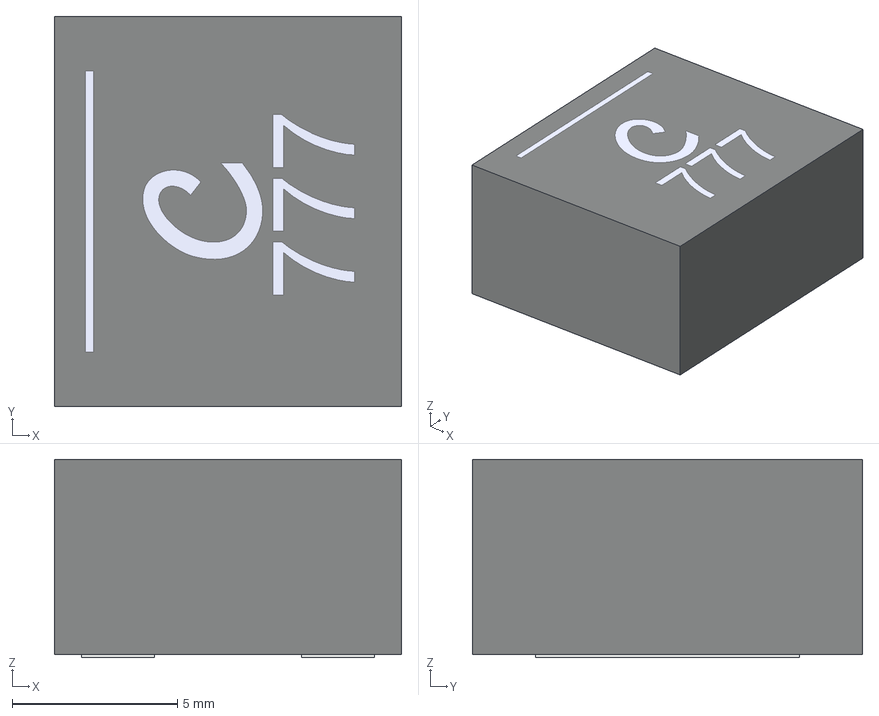
[picture p99: CAD file, 2024-11-16]
3D_models/XAL1060.step
10.5 x 11.8 x 6.00 mm
