ionutms/KiCAD_Symbol_Generator/3D_models/XAL1080.step

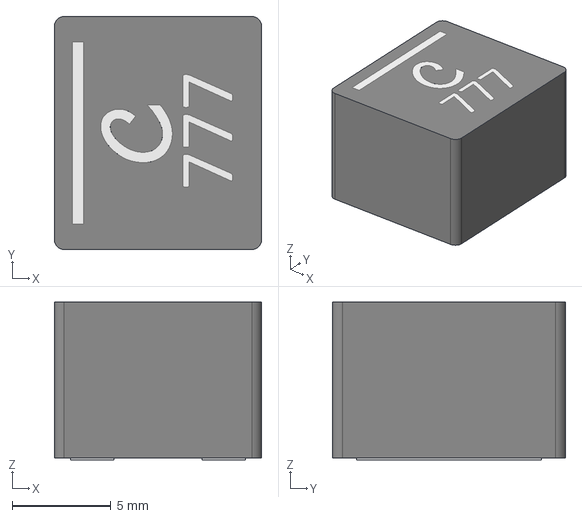
[picture p100: CAD file, 2024-11-16]
3D_models/XAL1080.step
10.5 x 11.8 x 8.00 mm
