ionutms/KiCAD_Symbol_Generator/3D_models/XAL1030.step

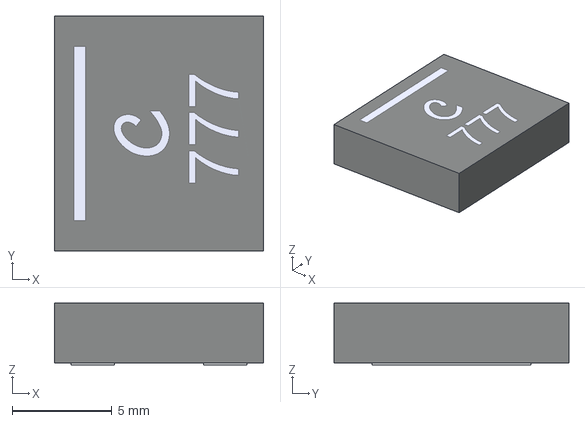
[picture p101: CAD file, 2024-11-16]
3D_models/XAL1030.step
10.5 x 11.8 x 3.10 mm
