ionutms/KiCAD_Symbol_Generator/3D_models/XAL1010.step

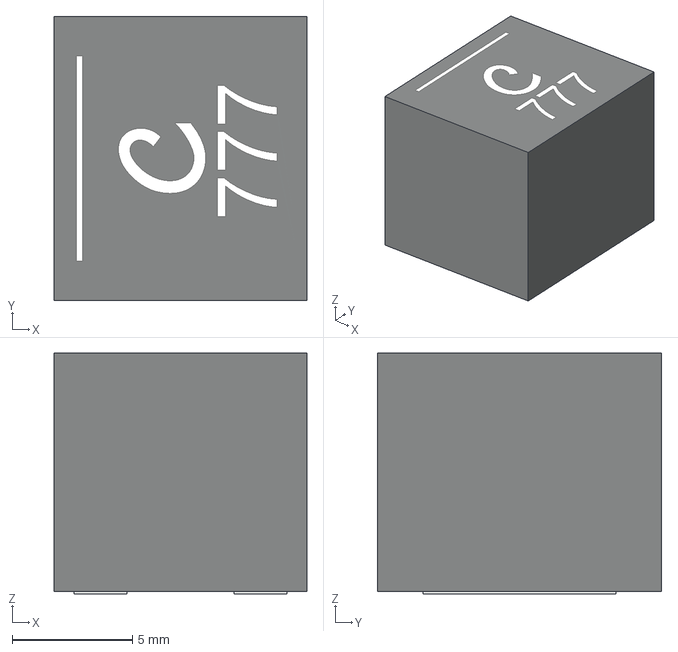
[picture p102: CAD file, 2024-11-16]
3D_models/XAL1010.step
10.5 x 11.8 x 10.0 mm
