ionutms/KiCAD_Symbol_Generator/3D_models/C_0805.step

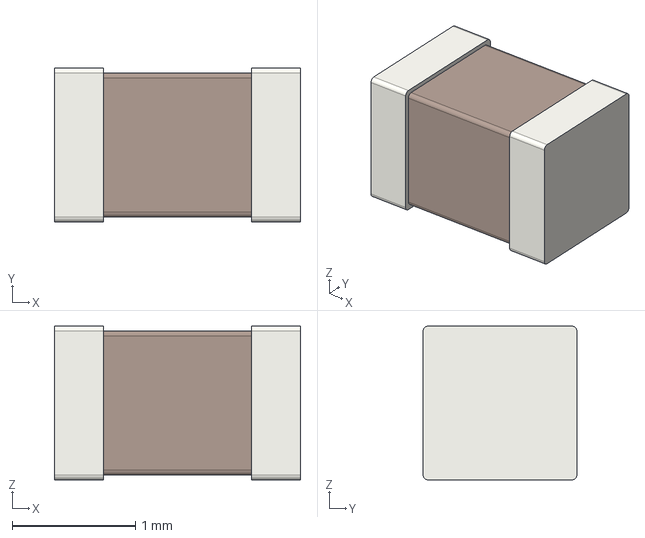
[picture p103: CAD file, 2024-11-14]
3D_models/C_0805.step
2.00 x 1.25 x 1.25 mm
