ionutms/KiCAD_Symbol_Generator/3D_models/C_0603.step

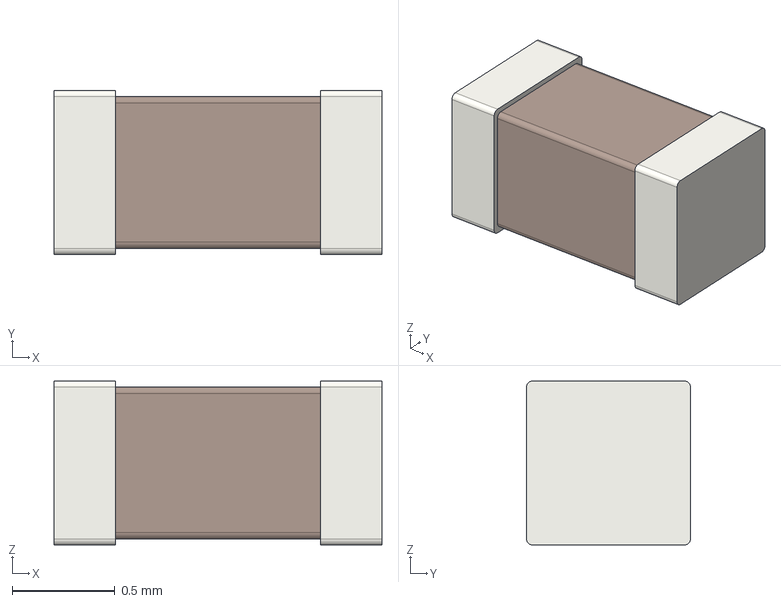
[picture p104: CAD file, 2024-11-14]
3D_models/C_0603.step
1.60 x 0.8 x 0.8 mm
