ionutms/KiCAD_Symbol_Generator/3D_models/C_0402.step

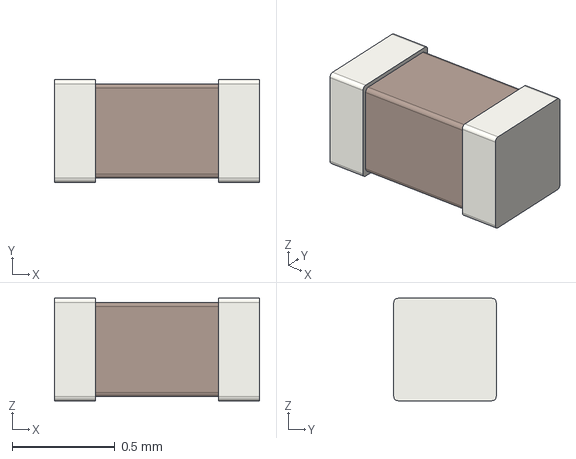
[picture p106: CAD file, 2024-11-14]
3D_models/C_0402.step
1.00 x 0.5 x 0.5 mm
