ionutms/KiCAD_Symbol_Generator/3D_models/R_0805.step

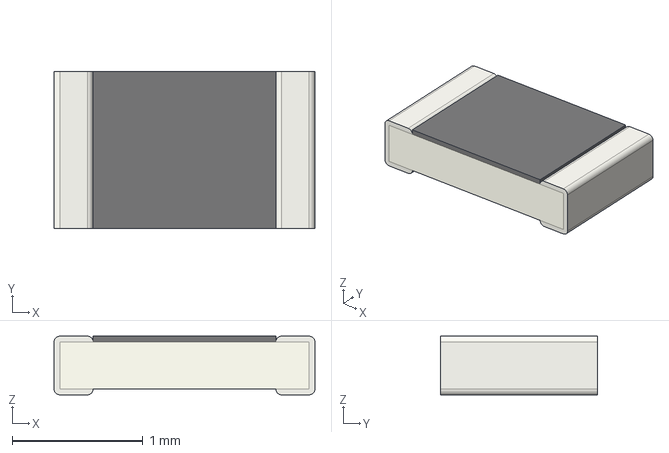
[picture p107: CAD file, 2024-11-14]
3D_models/R_0805.step
2.00 x 1.20 x 0.45 mm
