ionutms/KiCAD_Symbol_Generator/3D_models/R_1206.step

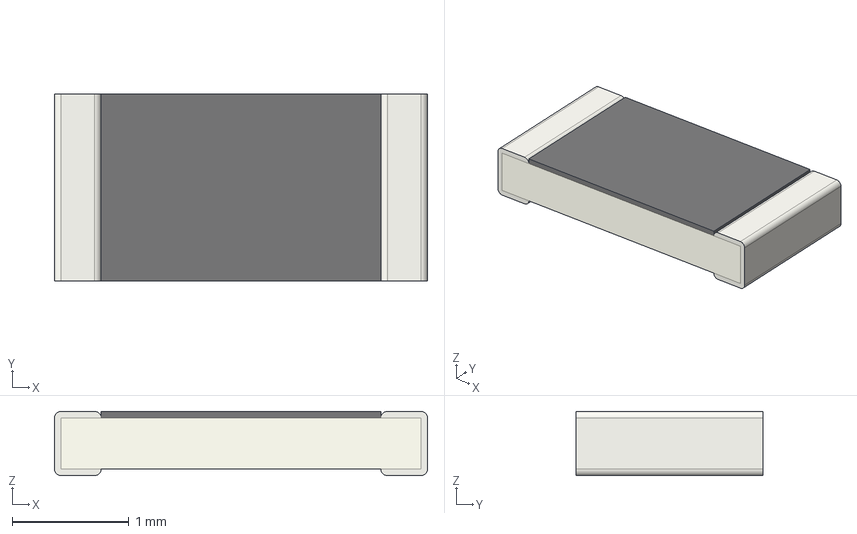
[picture p109: CAD file, 2024-11-14]
3D_models/R_1206.step
3.20 x 1.60 x 0.55 mm
