ionutms/KiCAD_Symbol_Generator/3D_models/CUI_DEVICES_TBP04R12-500-02BE.step

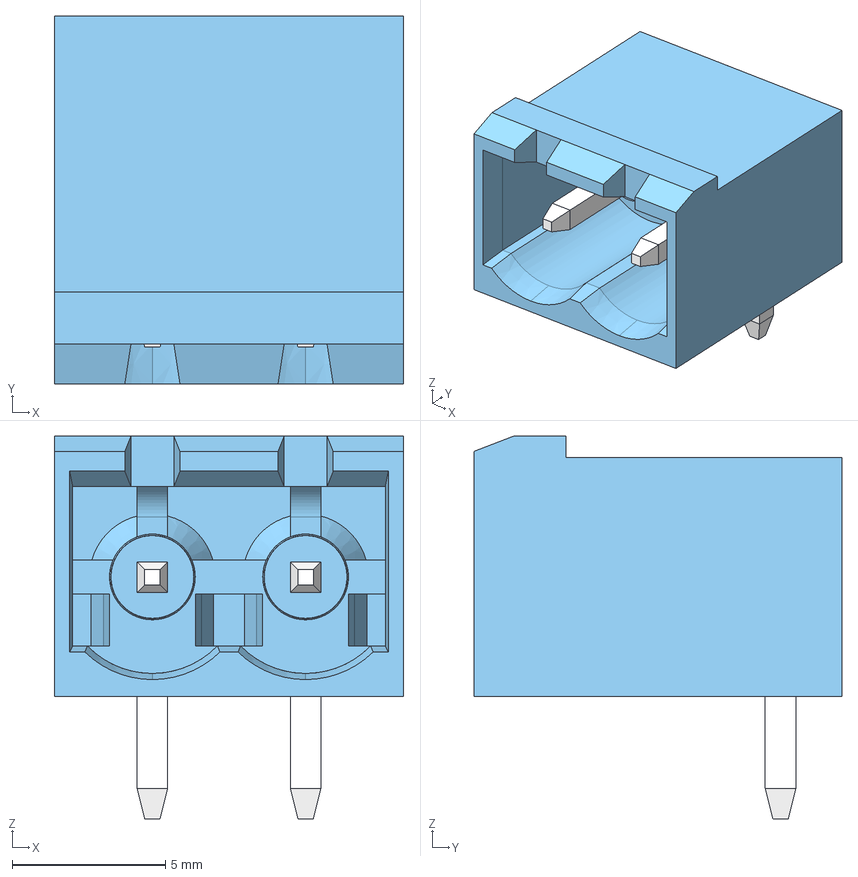
[picture p111: CAD file, 2024-11-11]
3D_models/CUI_DEVICES_TBP04R12-500-02BE.step
11.4 x 12.0 x 12.5 mm
