ionutms/KiCAD_Symbol_Generator/3D_models/CUI_DEVICES_TBP02R2-381-02BE.step

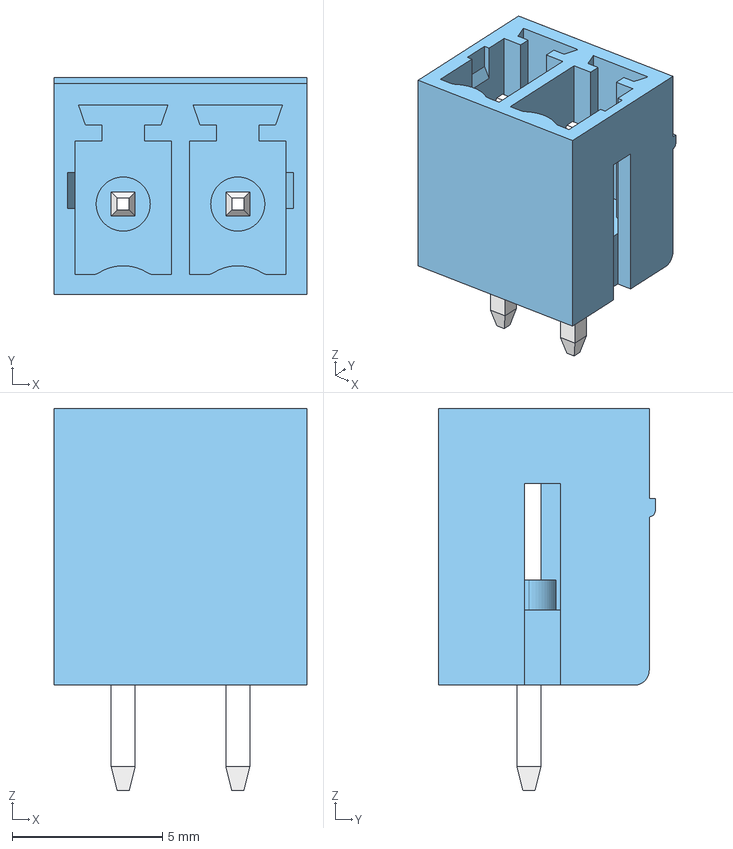
[picture p112: CAD file, 2024-11-11]
3D_models/CUI_DEVICES_TBP02R2-381-02BE.step
8.41 x 7.20 x 12.7 mm
