ionutms/KiCAD_Symbol_Generator/3D_models/CUI_DEVICES_TBP02R1-381-02BE.step

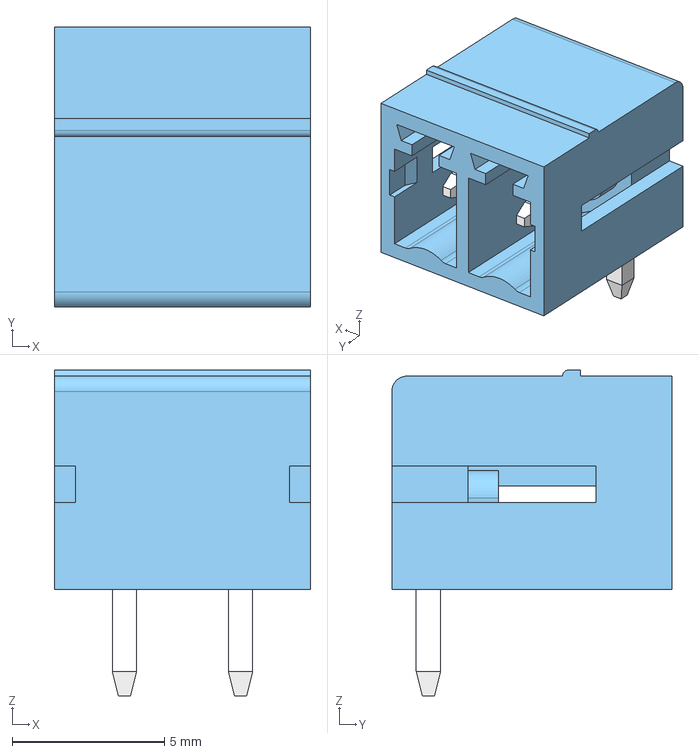
[picture p113: CAD file, 2024-11-10]
3D_models/CUI_DEVICES_TBP02R1-381-02BE.step
8.41 x 9.20 x 10.7 mm
