ionutms/KiCAD_Symbol_Generator/3D_models/CUI_DEVICES_TBP04R1-500-02BE.step

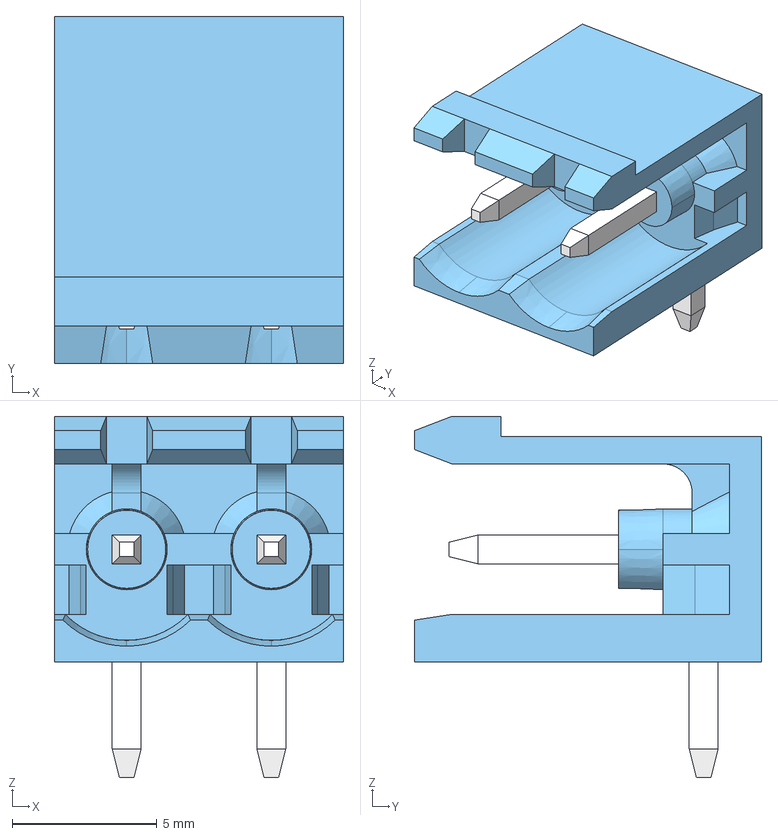
[picture p114: CAD file, 2024-11-10]
3D_models/CUI_DEVICES_TBP04R1-500-02BE.step
10.0 x 12.0 x 12.5 mm
