ionutms/KiCAD_Symbol_Generator/3D_models/CUI_DEVICES_TBP04R2-500-02BE.step

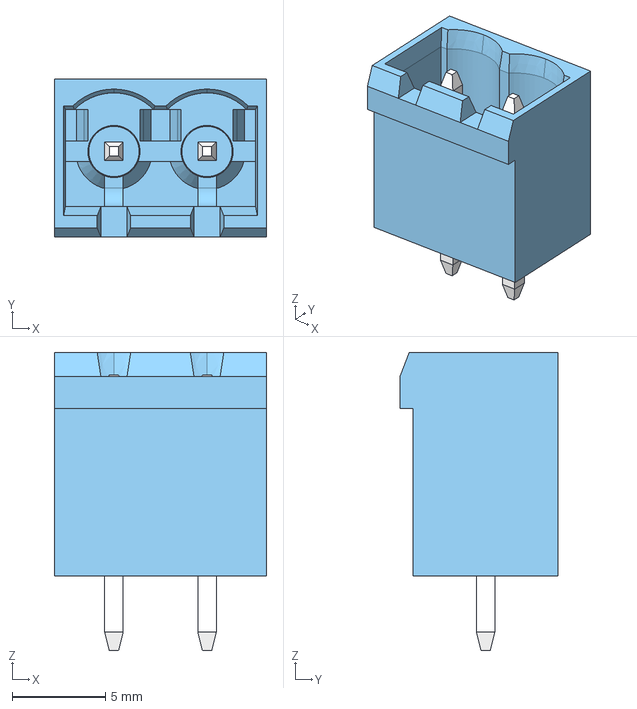
[picture p115: CAD file, 2024-11-10]
3D_models/CUI_DEVICES_TBP04R2-500-02BE.step
11.4 x 8.50 x 16.0 mm
