ionutms/KiCAD_Symbol_Generator/3D_models/CUI_DEVICES_TBP04R3-500-02BE.step

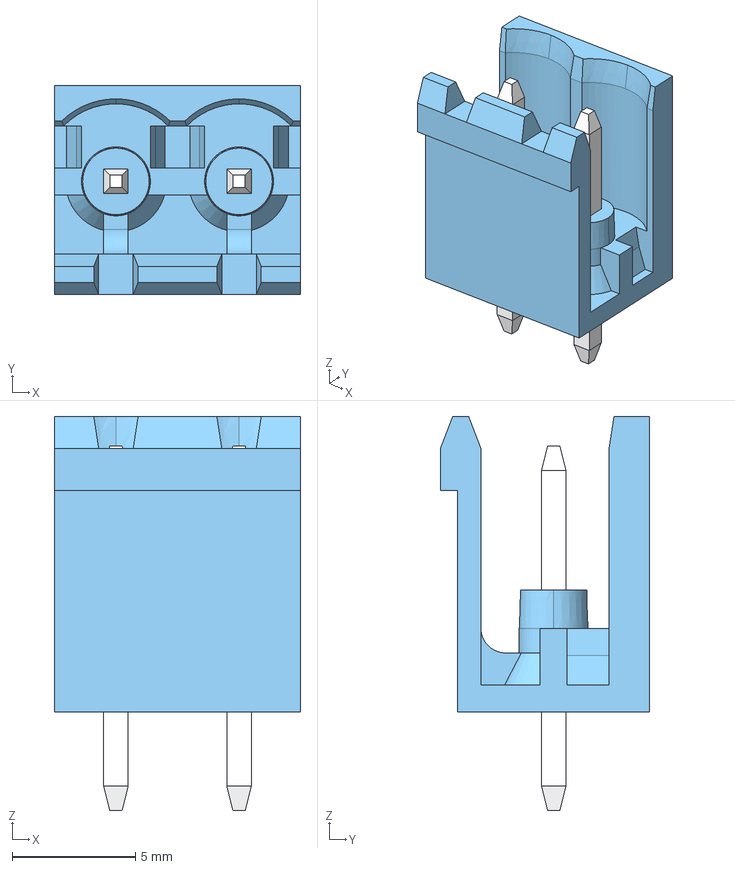
[picture p116: CAD file, 2024-11-10]
3D_models/CUI_DEVICES_TBP04R3-500-02BE.step
10.0 x 8.50 x 16.0 mm
