ionutms/KiCAD_Symbol_Generator/3D_models/CUI_DEVICES_TB006-508-21BE.step

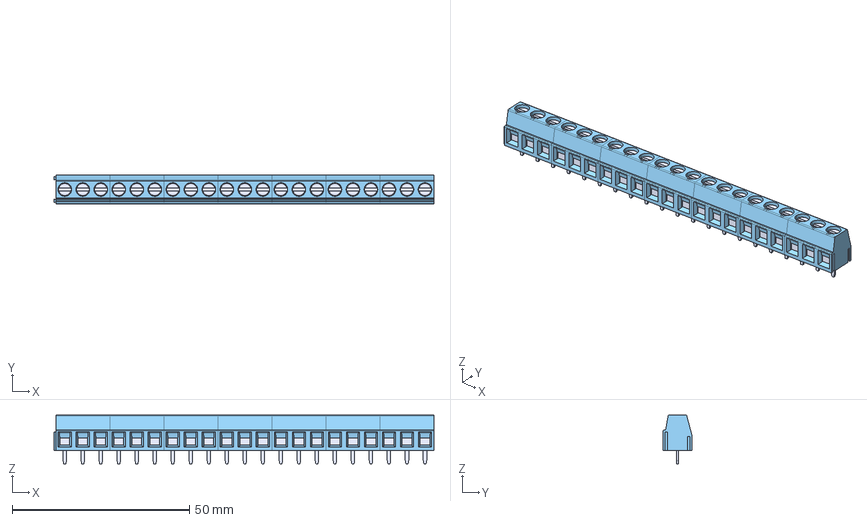
[picture p117: CAD file, 2024-11-08]
3D_models/CUI_DEVICES_TB006-508-21BE.step
107.2 x 8.20 x 13.8 mm
