ionutms/KiCAD_Symbol_Generator/3D_models/CUI_DEVICES_TB006-508-20BE.step

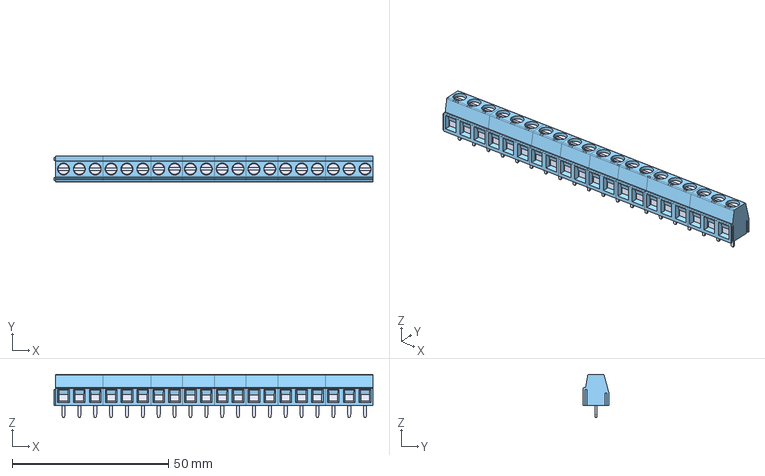
[picture p118: CAD file, 2024-11-08]
3D_models/CUI_DEVICES_TB006-508-20BE.step
102.1 x 8.20 x 13.8 mm
