ionutms/KiCAD_Symbol_Generator/3D_models/CUI_DEVICES_TB006-508-19BE.step

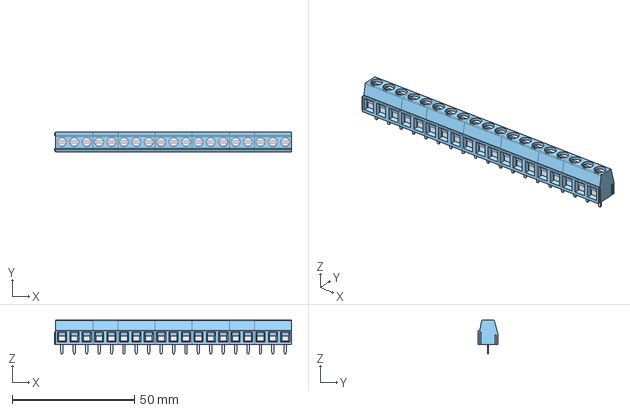
[picture p120: CAD file, 2024-11-08]
3D_models/CUI_DEVICES_TB006-508-19BE.step
97.0 x 8.20 x 13.8 mm
