ionutms/KiCAD_Symbol_Generator/3D_models/CUI_DEVICES_TB006-508-23BE.step

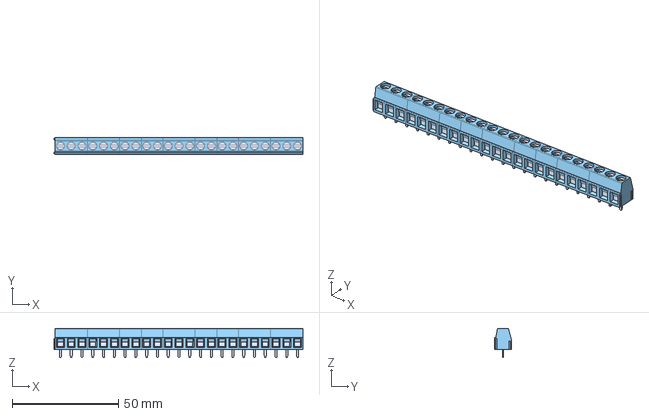
[picture p121: CAD file, 2024-11-08]
3D_models/CUI_DEVICES_TB006-508-23BE.step
117.3 x 8.20 x 13.8 mm
