ionutms/KiCAD_Symbol_Generator/3D_models/CUI_DEVICES_TB006-508-18BE.step

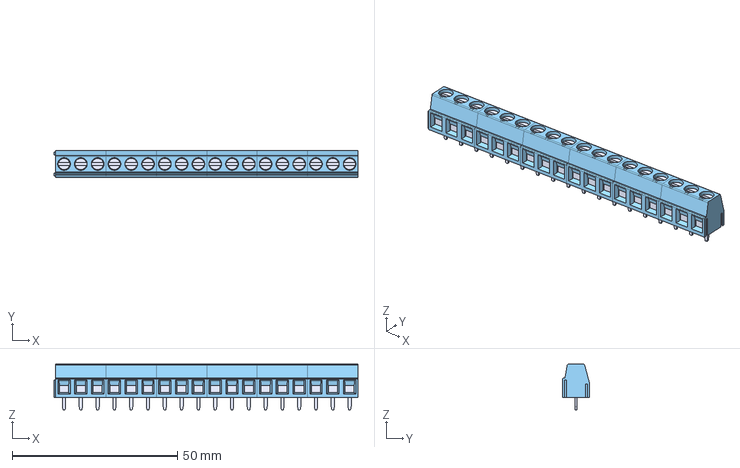
[picture p123: CAD file, 2024-11-08]
3D_models/CUI_DEVICES_TB006-508-18BE.step
91.9 x 8.20 x 13.8 mm
