ionutms/KiCAD_Symbol_Generator/3D_models/CUI_DEVICES_TB006-508-15BE.step

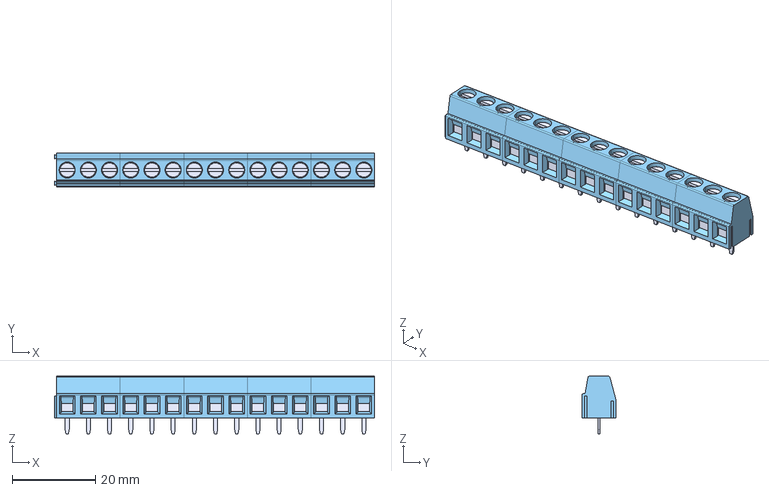
[picture p124: CAD file, 2024-11-08]
3D_models/CUI_DEVICES_TB006-508-15BE.step
76.7 x 8.20 x 13.8 mm
