ionutms/KiCAD_Symbol_Generator/3D_models/CUI_DEVICES_TB006-508-14BE.step

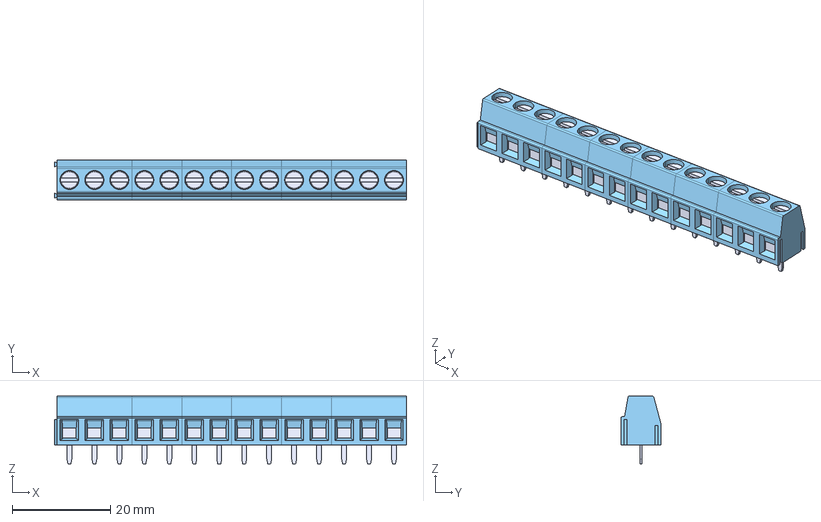
[picture p125: CAD file, 2024-11-08]
3D_models/CUI_DEVICES_TB006-508-14BE.step
71.6 x 8.20 x 13.8 mm
