ionutms/KiCAD_Symbol_Generator/3D_models/CUI_DEVICES_TB006-508-13BE.step

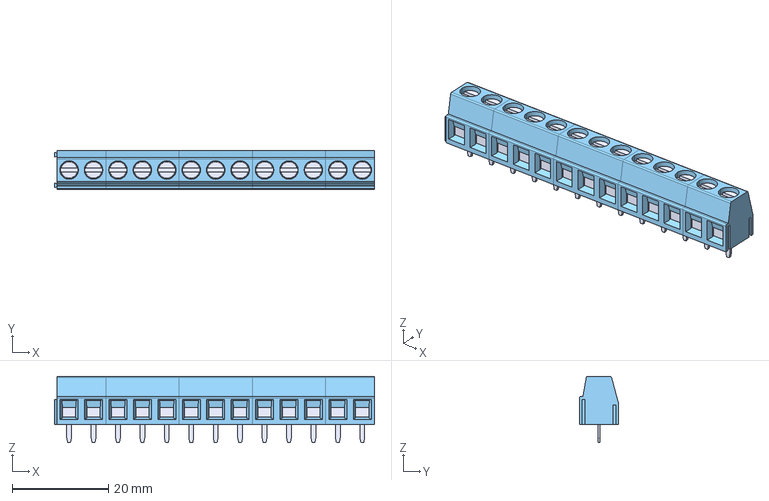
[picture p126: CAD file, 2024-11-08]
3D_models/CUI_DEVICES_TB006-508-13BE.step
66.5 x 8.20 x 13.8 mm
