ionutms/KiCAD_Symbol_Generator/3D_models/CUI_DEVICES_TB006-508-16BE.step

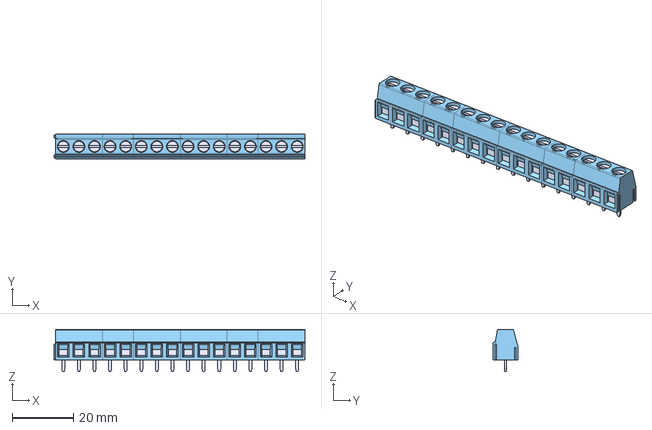
[picture p128: CAD file, 2024-11-08]
3D_models/CUI_DEVICES_TB006-508-16BE.step
81.8 x 8.20 x 13.8 mm
