ionutms/KiCAD_Symbol_Generator/3D_models/CUI_DEVICES_TB006-508-11BE.step

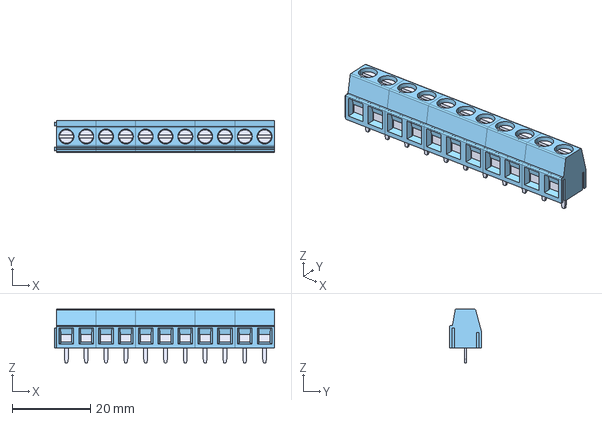
[picture p129: CAD file, 2024-11-08]
3D_models/CUI_DEVICES_TB006-508-11BE.step
56.4 x 8.20 x 13.8 mm
