ionutms/KiCAD_Symbol_Generator/3D_models/CUI_DEVICES_TB006-508-08BE.step

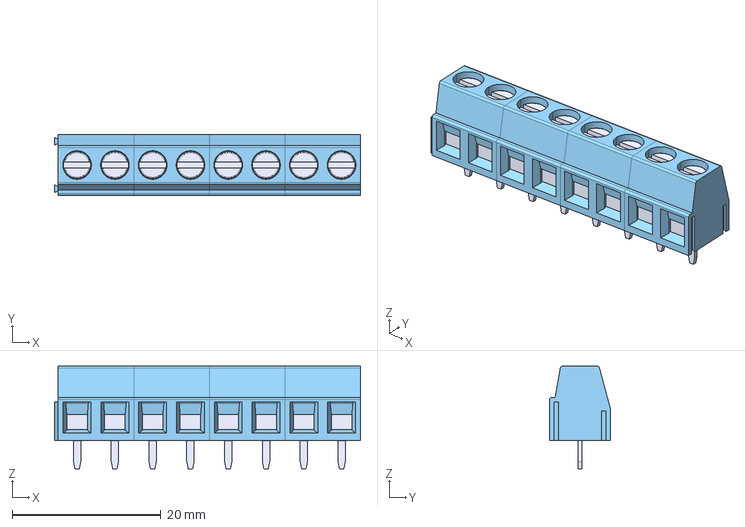
[picture p130: CAD file, 2024-11-08]
3D_models/CUI_DEVICES_TB006-508-08BE.step
41.1 x 8.20 x 13.8 mm
