ionutms/KiCAD_Symbol_Generator/3D_models/CUI_DEVICES_TB006-508-12BE.step

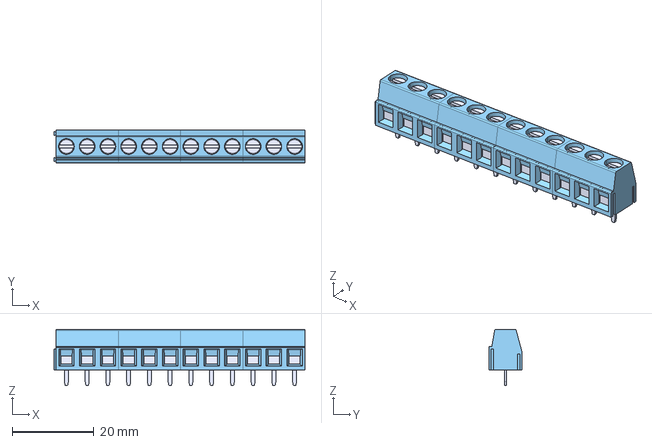
[picture p131: CAD file, 2024-11-08]
3D_models/CUI_DEVICES_TB006-508-12BE.step
61.5 x 8.20 x 13.8 mm
