ionutms/KiCAD_Symbol_Generator/3D_models/CUI_DEVICES_TB006-508-09BE.step

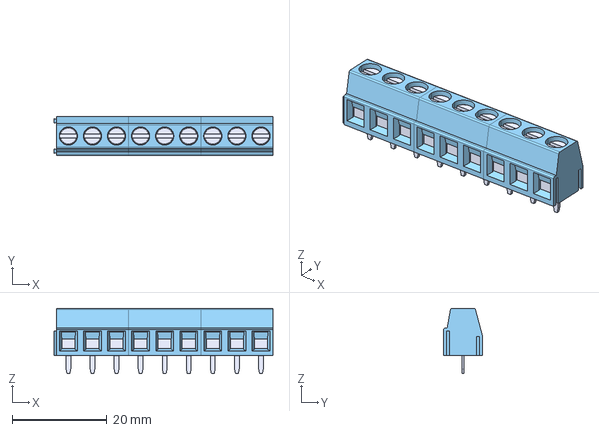
[picture p132: CAD file, 2024-11-08]
3D_models/CUI_DEVICES_TB006-508-09BE.step
46.2 x 8.20 x 13.8 mm
