ionutms/KiCAD_Symbol_Generator/3D_models/CUI_DEVICES_TB006-508-06BE.step

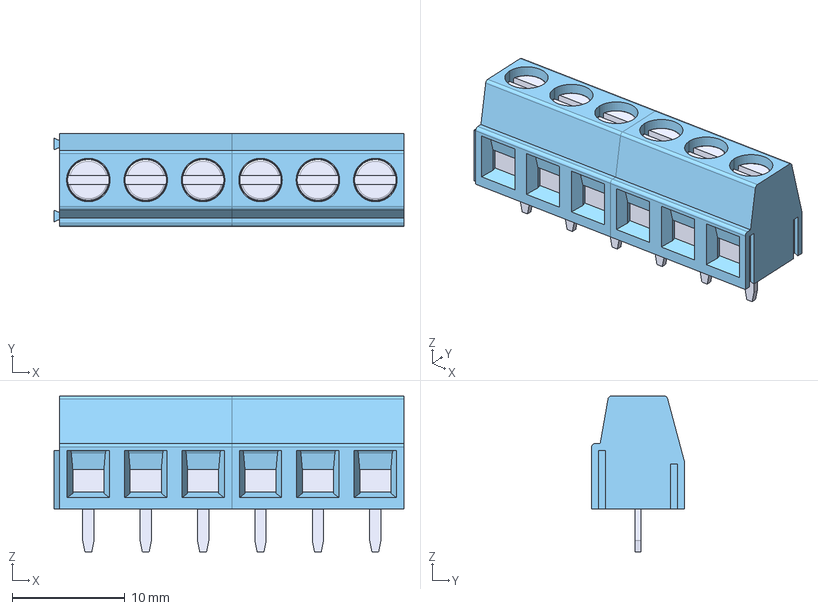
[picture p134: CAD file, 2024-11-07]
3D_models/CUI_DEVICES_TB006-508-06BE.step
31.0 x 8.20 x 13.8 mm
