ionutms/KiCAD_Symbol_Generator/3D_models/CUI_DEVICES_TB006-508-07BE.step

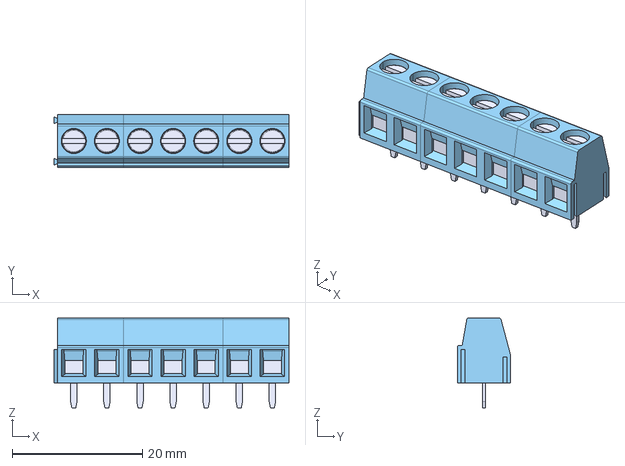
[picture p135: CAD file, 2024-11-07]
3D_models/CUI_DEVICES_TB006-508-07BE.step
36.1 x 8.20 x 13.8 mm
