ionutms/KiCAD_Symbol_Generator/3D_models/CUI_DEVICES_TB006-508-05BE.step

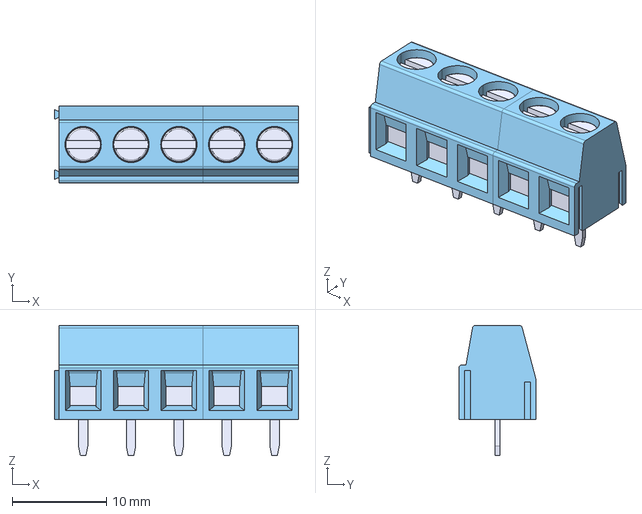
[picture p136: CAD file, 2024-11-07]
3D_models/CUI_DEVICES_TB006-508-05BE.step
25.9 x 8.20 x 13.8 mm
