ionutms/KiCAD_Symbol_Generator/3D_models/CUI_DEVICES_TB006-508-04BE.step

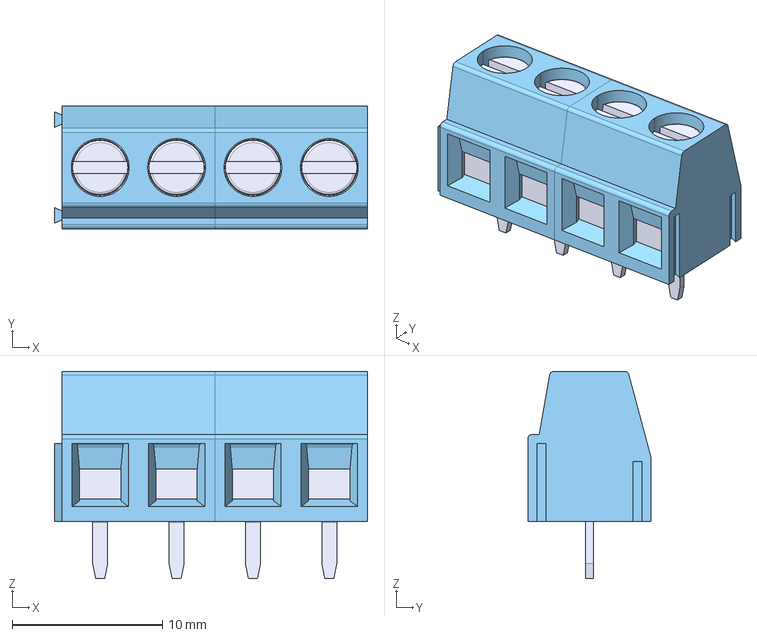
[picture p137: CAD file, 2024-11-07]
3D_models/CUI_DEVICES_TB006-508-04BE.step
20.8 x 8.20 x 13.8 mm
