ionutms/KiCAD_Symbol_Generator/3D_models/CUI_DEVICES_TB006-508-02BE.step

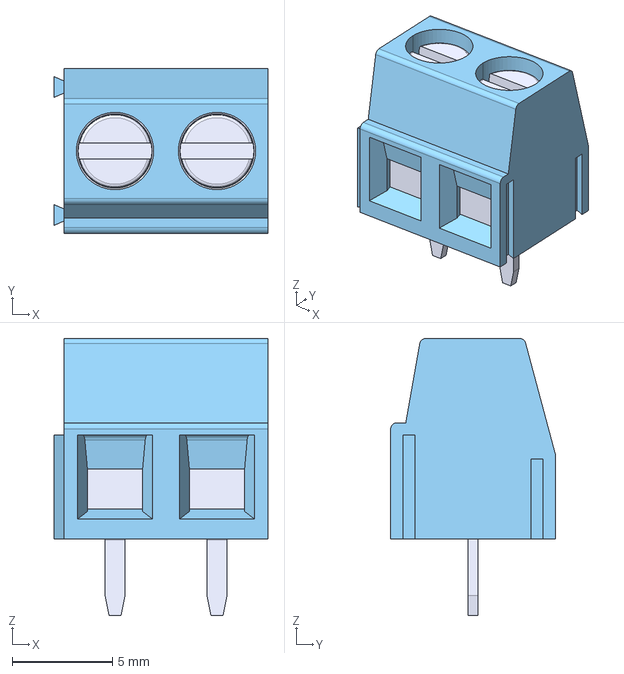
[picture p138: CAD file, 2024-11-07]
3D_models/CUI_DEVICES_TB006-508-02BE.step
10.7 x 8.20 x 13.8 mm
