ionutms/KiCAD_Symbol_Generator/3D_models/CUI_DEVICES_TB004-508-11BE.step

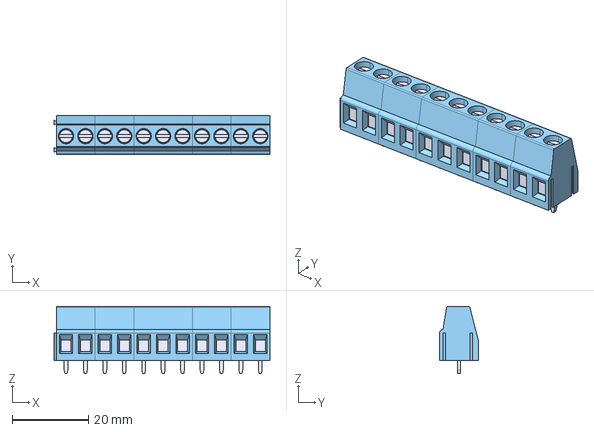
[picture p140: CAD file, 2024-11-06]
3D_models/CUI_DEVICES_TB004-508-11BE.step
56.5 x 10.2 x 17.6 mm
