ionutms/KiCAD_Symbol_Generator/3D_models/CUI_DEVICES_TB004-508-17BE.step

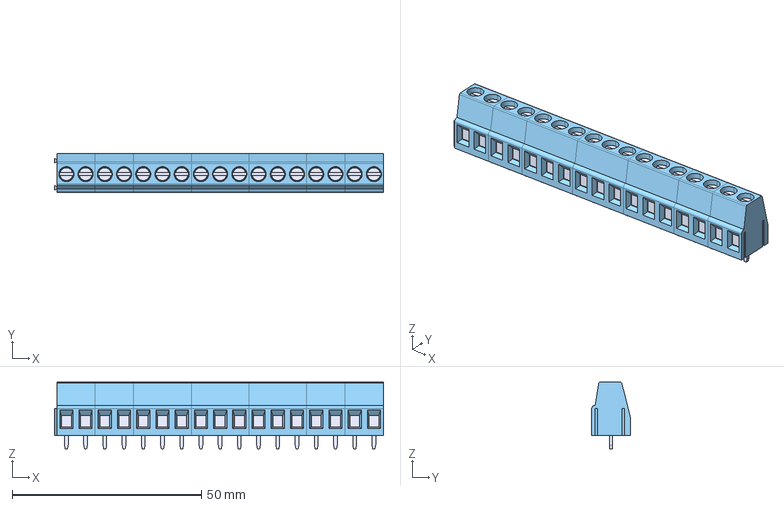
[picture p141: CAD file, 2024-11-06]
3D_models/CUI_DEVICES_TB004-508-17BE.step
87.0 x 10.2 x 17.6 mm
