ionutms/KiCAD_Symbol_Generator/3D_models/CUI_DEVICES_TB004-508-23BE.step

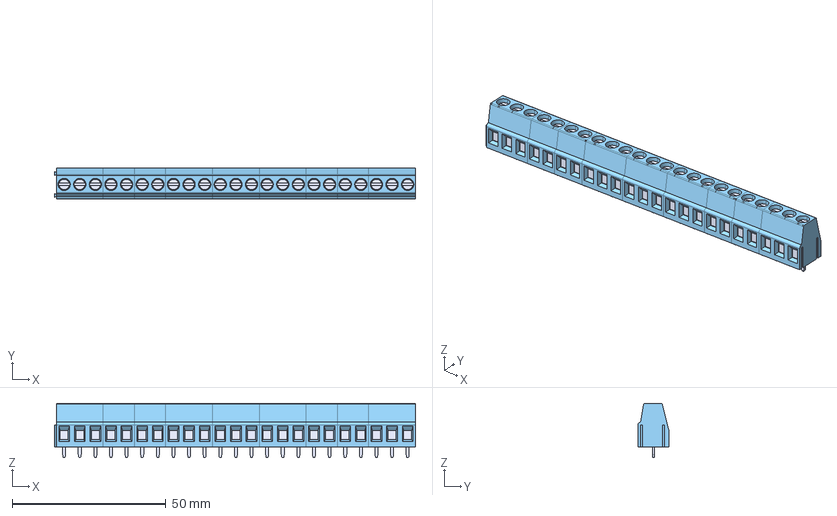
[picture p142: CAD file, 2024-11-06]
3D_models/CUI_DEVICES_TB004-508-23BE.step
117.4 x 10.2 x 17.6 mm
