ionutms/KiCAD_Symbol_Generator/3D_models/CUI_DEVICES_TB004-508-21BE.step

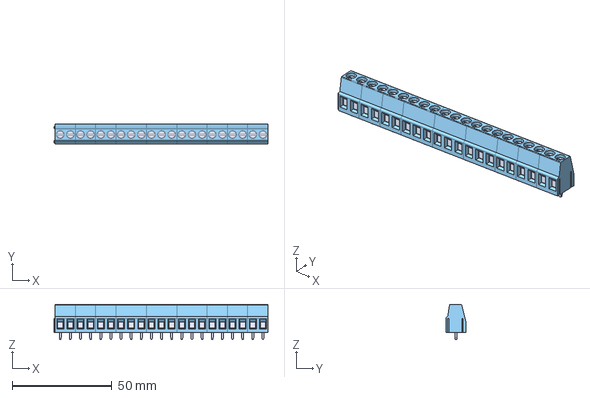
[picture p143: CAD file, 2024-11-06]
3D_models/CUI_DEVICES_TB004-508-21BE.step
107.3 x 10.2 x 17.6 mm
