ionutms/KiCAD_Symbol_Generator/3D_models/CUI_DEVICES_TB004-508-13BE.step

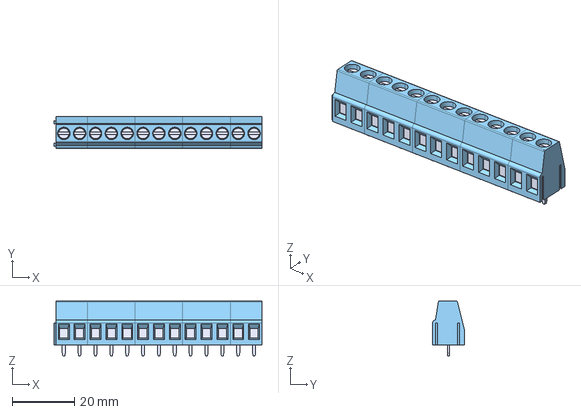
[picture p144: CAD file, 2024-11-06]
3D_models/CUI_DEVICES_TB004-508-13BE.step
66.6 x 10.2 x 17.6 mm
