ionutms/KiCAD_Symbol_Generator/3D_models/CUI_DEVICES_TB004-508-19BE.step

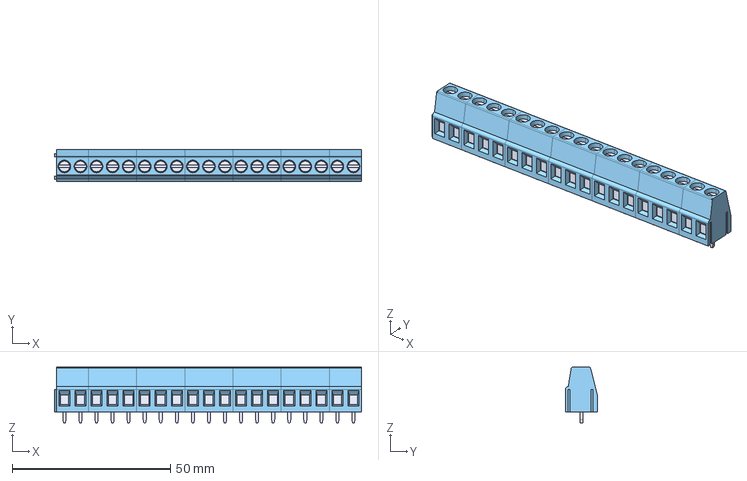
[picture p145: CAD file, 2024-11-06]
3D_models/CUI_DEVICES_TB004-508-19BE.step
97.1 x 10.2 x 17.6 mm
