ionutms/KiCAD_Symbol_Generator/(list of files, cad)

Other CAD files:
3D_models/XFL5018.step
3D_models/XAL6060.step
3D_models/XAL5030.step
3D_models/XAL4020.step
3D_models/XAL4030.step
3D_models/750315836.step
3D_models/CUI_DEVICES_TB004-508-02BE.step
3D_models/CUI_DEVICES_TB004-508-03BE.step
3D_models/CUI_DEVICES_TB004-508-04BE.step
3D_models/CUI_DEVICES_TB004-508-05BE.step
3D_models/CUI_DEVICES_TB004-508-06BE.step
3D_models/CUI_DEVICES_TB004-508-07BE.step
3D_models/CUI_DEVICES_TB004-508-08BE.step
3D_models/CUI_DEVICES_TB004-508-09BE.step
3D_models/CUI_DEVICES_TB004-508-10BE.step
3D_models/CUI_DEVICES_TB004-508-12BE.step
3D_models/CUI_DEVICES_TB004-508-14BE.step
3D_models/CUI_DEVICES_TB004-508-15BE.step
3D_models/CUI_DEVICES_TB004-508-16BE.step
3D_models/CUI_DEVICES_TB004-508-18BE.step
3D_models/CUI_DEVICES_TB004-508-20BE.step
3D_models/CUI_DEVICES_TB004-508-22BE.step
3D_models/CUI_DEVICES_TB004-508-24BE.step
