ionutms/KiCAD_Symbol_Generator/repo_traffic_data/clones_history.csv

clone_timestamp | total_clones | unique_clones
2024-11-20 | 13 | 8
2024-11-21 | 6 | 4
2024-11-22 | 2 | 2
2024-11-23 | 3 | 2
2024-11-24 | 3 | 3
2024-11-25 | 7 | 5
2024-11-26 | 2 | 1
2024-11-27 | 3 | 2
2024-11-28 | 3 | 2
2024-11-29 | 1 | 1
2024-11-30 | 4 | 2
2024-12-01 | 2 | 2
2024-12-02 | 2 | 2
2024-12-03 | 2 | 2
2024-12-04 | 8 | 5
2024-12-05 | 1 | 1
2024-12-06 | 19 | 7
2024-12-07 | 51 | 12
2024-12-08 | 43 | 8
2024-12-09 | 59 | 11
2024-12-10 | 99 | 11
2024-12-11 | 75 | 10
2024-12-12 | 77 | 10
2024-12-13 | 71 | 10
2024-12-14 | 69 | 10
2024-12-15 | 69 | 10
2024-12-16 | 68 | 10
2024-12-17 | 61 | 8
2024-12-18 | 68 | 11
2024-12-19 | 68 | 17
