ionutms/KiCAD_Symbol_Generator/(commit log)

2024-10-08 add the initial csv file
    [resistor.csv]
2024-10-08 add the initial kicad symbol library
2024-10-08 filter out the reference symbol
2024-10-08 add Symbol Name column
    [resistor.csv]
2024-10-08 update footprint path
    [resistor.csv]
2024-10-08 add R_000002
    [resistor.csv]
2024-10-08 add R_000003
    [resistor.csv]
2024-10-08 update R_000003
    [resistor.csv]
2024-10-08 add R_000004 and R_000005
    [resistor.csv]
2024-10-08 add R_000006 and R_000007
    [resistor.csv]
2024-10-08 add R_000008, R_000009 and R_000010
    [resistor.csv]
2024-10-08 add R_000011, R_000012 and R_000013
    [resistor.csv]
2024-10-08 add R_000014, R_000015 and R_000016
    [resistor.csv]
2024-10-08 add R_000017, R_000018, R_000019 and R_000020
    [resistor.csv]
2024-10-08 add R_000021, R_000022, R_000023 and R_000024
    [resistor.csv]
2024-10-08 add R_000025, R_000026, R_000027 and R_000028
    [resistor.csv]
2024-10-10 add the initial symbol reference and csv file
    [capacitor.csv]
2024-10-10 update reference symbol
    [capacitor.csv]
2024-10-10 add the initial python script for capacitor symbol generator
2024-10-10 add C_000002
    [capacitor.csv]
2024-10-10 add C_000003 and C_000004
    [capacitor.csv]
2024-10-10 add C_000005 and C_000006
    [capacitor.csv]
2024-10-10 update table
    [capacitor.csv]
2024-10-11 add C_000007 and C_000008
    [capacitor.csv]
2024-10-11 add C_000009 and C_000010
    [capacitor.csv]
2024-10-11 add C_000011, C_000012, C_000013, C_000014, C_000015 and C_000016
    [capacitor.csv]
2024-10-11 add C_000017, C_000018, C_000019, C_000020, C_000021 and C_000022
    [capacitor.csv]
2024-10-11 update resistor database
    [resistor.csv]
2024-10-12 add capacitor database app page
2024-10-15 update capacitor sym lib
2024-10-16 add R_000029 and R_000030
    [resistor.csv]
2024-10-18 add ERJ2RK part numbers generator script
    [ERJ2RK_part_numbers.csv]
2024-10-18 fix part numbers generator script
    [ERJ2RK_part_numbers.csv]
2024-10-18 remove new feature
    [ERJ2RK_part_numbers.csv]
2024-10-18 add erj_2rk_mpn_generator
    [ERJ2RK_part_numbers.csv]
2024-10-18 add a new symbol library for resistors
2024-10-20 add ERJ3EK series
    [ERJ3EK_part_numbers.csv]
2024-10-20 update ERJ3EK_part_numbers file
    [ERJ3EK_part_numbers.csv]
2024-10-21 add ERJ6EN series
    [ERJ6EN_part_numbers.csv]
2024-10-21 minor fix
    [ERJ6EN_part_numbers.csv]
2024-10-21 update parts and symbols files for ERJ-2RK series
    [ERJ2RK_part_numbers.csv]
2024-10-21 update parts and symbols files for ERJ-3EK series
    [ERJ3EK_part_numbers.csv]
2024-10-21 update parts and symbols files for ERJ-6EN series
    [ERJ6EN_part_numbers.csv]
2024-10-22 change symbol name for erj2rk series symbols
    [ERJ2RK_part_numbers.csv]
2024-10-22 change symbol name for erj3ek series symbols
    [ERJ3EK_part_numbers.csv]
2024-10-22 change symbol name for erj6en series symbols
    [ERJ6EN_part_numbers.csv]
2024-10-22 add Series column
    [ERJ2RK_part_numbers.csv]
2024-10-22 add ERJ-P08 series
    [ERJP08_part_numbers.csv]
2024-10-23 integrate p08 series
    [ERJP08_part_numbers.csv]
2024-10-23 fix the voltage rating for erj-p08 series
2024-10-23 update p08 series and add p06, p03 ones
    [ERJP03_part_numbers.csv, ERJP06_part_numbers.csv, ERJP08_part_numbers.csv]
2024-10-23 add Trustedparts Search
    [ERJ2RK_part_numbers.csv, ERJ3EK_part_numbers.csv, ERJ6EN_part_numbers.csv, ERJP03_part_numbers.csv, ERJP06_part_numbers.csv, ERJP08_part_numbers.csv]
2024-10-24 add initial gcm155 series support
    [GCM155_part_numbers.csv]
2024-10-24 update voltage rating column value
2024-10-24 script refactory
    [GCM155_part_numbers.csv]
2024-10-25 update files
    [GCM155_part_numbers.csv]
2024-10-25 add initial support for 188 series
    [GCM188_part_numbers.csv]
2024-10-25 update gcm188 generation
    [GCM188_part_numbers.csv]
2024-10-25 fix mpn generation
    [GCM188_part_numbers.csv]
2024-10-26 add gcm216 series
    [GCM216_part_numbers.csv]
2024-10-26 fix mpn generation for gcm216
    [GCM216_part_numbers.csv]
2024-10-26 add gcm31m series
    [GCM31M_part_numbers.csv]
2024-10-26 fix partially mpn generation for gcm31m series
    [GCM31M_part_numbers.csv]
2024-10-26 fix mpn generation for gcm31m
    [GCM31M_part_numbers.csv]
2024-10-26 fix mpn generation for gcm31m series
    [GCM31M_part_numbers.csv]
2024-10-26 add gcm31c series
    [GCM31C_part_numbers.csv]
2024-10-26 restructure app
    [ERJ2RK_part_numbers.csv, ERJ3EK_part_numbers.csv, ERJ6EN_part_numbers.csv, ERJP03_part_numbers.csv, ERJP06_part_numbers.csv, ERJP08_part_numbers.csv, GCM155_part_numbers.csv, GCM188_part_numbers.csv]
2024-10-26 generate united files
    [UNITED_CAPACITORS_DATA_BASE.csv, UNITED_RESISTORS_DATA_BASE.csv]
2024-10-27 add resulted files and optimize script
    [XFL3012_part_numbers.csv]
2024-10-27 add XFL3010
    [XFL3010_part_numbers.csv]
2024-10-27 add united funcionality for xfl script
    [UNITED_INDUCTORS_DATA_BASE.csv]
2024-10-28 add XFL4012 series
    [UNITED_INDUCTORS_DATA_BASE.csv, XFL4012_part_numbers.csv]
2024-10-28 add xfl4015 series
    [UNITED_INDUCTORS_DATA_BASE.csv, XFL4015_part_numbers.csv]
2024-10-28 add xfl4020 series
    [UNITED_INDUCTORS_DATA_BASE.csv, XFL4020_part_numbers.csv]
2024-10-28 add xfl4030 series
    [UNITED_INDUCTORS_DATA_BASE.csv, XFL4030_part_numbers.csv]
2024-10-28 add xfl5015 and xfl5018 series
    [UNITED_INDUCTORS_DATA_BASE.csv, XFL5015_part_numbers.csv, XFL5018_part_numbers.csv]
2024-10-28 add xfl5030
    [UNITED_INDUCTORS_DATA_BASE.csv, XFL5030_part_numbers.csv]
2024-10-28 add xfl6012 series
    [UNITED_INDUCTORS_DATA_BASE.csv, XFL6012_part_numbers.csv]
2024-10-28 add xfl6060 series
    [UNITED_INDUCTORS_DATA_BASE.csv, XFL6060_part_numbers.csv]
2024-10-28 add xfl7015 series
    [UNITED_INDUCTORS_DATA_BASE.csv, XFL7015_part_numbers.csv]
2024-10-29 add xfl2010 series
    [UNITED_INDUCTORS_DATA_BASE.csv, XFL2010_part_numbers.csv]
2024-10-29 add xfl2006 series
    [UNITED_INDUCTORS_DATA_BASE.csv, XFL2006_part_numbers.csv]
2024-10-29 add xfl2005 series
    [UNITED_INDUCTORS_DATA_BASE.csv, XFL2005_part_numbers.csv]
2024-10-29 add xal4020 series
    [UNITED_INDUCTORS_DATA_BASE.csv, XAL4020_part_numbers.csv]
2024-10-29 fix xal4020 series values range
    [UNITED_INDUCTORS_DATA_BASE.csv, XAL4020_part_numbers.csv]
2024-10-29 add xal4030 and xal4040 series
    [UNITED_INDUCTORS_DATA_BASE.csv, XAL4030_part_numbers.csv, XAL4040_part_numbers.csv]
2024-10-29 add xal5020 series
    [UNITED_INDUCTORS_DATA_BASE.csv, XAL5020_part_numbers.csv]
2024-10-29 add xal5030 series
    [UNITED_INDUCTORS_DATA_BASE.csv, XAL5030_part_numbers.csv]
2024-10-29 add xal5050 series
    [UNITED_INDUCTORS_DATA_BASE.csv, XAL5050_part_numbers.csv]
2024-10-29 add xal6020 series
    [UNITED_INDUCTORS_DATA_BASE.csv, XAL6020_part_numbers.csv]
2024-10-29 add xal6030 and xal6060 series
    [UNITED_INDUCTORS_DATA_BASE.csv, XAL6030_part_numbers.csv, XAL6060_part_numbers.csv]
2024-10-30 add xal7020 series
    [UNITED_INDUCTORS_DATA_BASE.csv, XAL7020_part_numbers.csv]
2024-10-30 add xal7030 series
    [UNITED_INDUCTORS_DATA_BASE.csv, XAL7030_part_numbers.csv]
2024-10-30 add xal7050 series
    [UNITED_INDUCTORS_DATA_BASE.csv, XAL7050_part_numbers.csv]
2024-10-30 add xal7070 series
    [UNITED_INDUCTORS_DATA_BASE.csv, XAL7070_part_numbers.csv]
2024-10-30 add xal8050 series
    [UNITED_INDUCTORS_DATA_BASE.csv, XAL8050_part_numbers.csv]
2024-10-30 add xal8080 series
    [UNITED_INDUCTORS_DATA_BASE.csv, XAL8080_part_numbers.csv]
2024-10-30 add xal1030 series
    [UNITED_INDUCTORS_DATA_BASE.csv, XAL1030_part_numbers.csv]
2024-10-30 add xal1060 series
    [UNITED_INDUCTORS_DATA_BASE.csv, XAL1060_part_numbers.csv]
2024-10-30 add xal1080 series
    [UNITED_INDUCTORS_DATA_BASE.csv, XAL1080_part_numbers.csv]
2024-10-30 add xal1010 series
    [UNITED_INDUCTORS_DATA_BASE.csv, XAL1010_part_numbers.csv]
2024-10-31 add xal1350 series
    [UNITED_INDUCTORS_DATA_BASE.csv, XAL1350_part_numbers.csv]
2024-10-31 add xal1580 series
    [UNITED_INDUCTORS_DATA_BASE.csv, XAL1580_part_numbers.csv]
2024-10-31 add xal1510 series
    [UNITED_INDUCTORS_DATA_BASE.csv, XAL1510_part_numbers.csv]
2024-10-31 add xal1513 series
    [UNITED_INDUCTORS_DATA_BASE.csv, XAL1513_part_numbers.csv]
2024-10-31 add max_dc_current field
    [UNITED_INDUCTORS_DATA_BASE.csv, XAL1010_part_numbers.csv, XAL1030_part_numbers.csv, XAL1060_part_numbers.csv, XAL1080_part_numbers.csv, XAL1350_part_numbers.csv, XAL1510_part_numbers.csv, XAL1513_part_numbers.csv]
2024-11-01 update xal1580, xal1513, xal1510, xal1350 and xal1010 series files
    [UNITED_INDUCTORS_DATA_BASE.csv, XAL1010_part_numbers.csv, XAL1350_part_numbers.csv, XAL1510_part_numbers.csv, XAL1513_part_numbers.csv, XAL1580_part_numbers.csv]
2024-11-01 update xal1060 and xal1080 series
    [UNITED_INDUCTORS_DATA_BASE.csv, XAL1060_part_numbers.csv, XAL1080_part_numbers.csv]
2024-11-01 update xal1030, xal8050 and xal8080 series files
    [UNITED_INDUCTORS_DATA_BASE.csv, XAL1030_part_numbers.csv, XAL8050_part_numbers.csv, XAL8080_part_numbers.csv]
2024-11-01 update xal7020, xal7030 and xal7050 series files
    [UNITED_INDUCTORS_DATA_BASE.csv, XAL7020_part_numbers.csv, XAL7030_part_numbers.csv, XAL7050_part_numbers.csv]
2024-11-01 update xal6020, xal6030 and xal6060 series files
    [UNITED_INDUCTORS_DATA_BASE.csv, XAL6020_part_numbers.csv, XAL6030_part_numbers.csv, XAL6060_part_numbers.csv]
2024-11-02 update xal4020, xal4030, xal4040, xal5020, xal5030, xal5050 and xal7070 series files
    [UNITED_INDUCTORS_DATA_BASE.csv, XAL4020_part_numbers.csv, XAL4030_part_numbers.csv, XAL4040_part_numbers.csv, XAL5020_part_numbers.csv, XAL5030_part_numbers.csv, XAL5050_part_numbers.csv, XAL7070_part_numbers.csv]
2024-11-02 update xfl2005, xfl2006 and xfl2010 series files
    [UNITED_INDUCTORS_DATA_BASE.csv, XFL2005_part_numbers.csv, XFL2006_part_numbers.csv, XFL2010_part_numbers.csv]
2024-11-02 update xfl3010, xfl3012, xfl4012, xfl4015, xfl4020 and xfl4030 series files
    [UNITED_INDUCTORS_DATA_BASE.csv, XFL3010_part_numbers.csv, XFL3012_part_numbers.csv, XFL4012_part_numbers.csv, XFL4015_part_numbers.csv, XFL4020_part_numbers.csv, XFL4030_part_numbers.csv]
2024-11-02 update xfl5015, xfl5018, xfl5030, xfl6012, xfl6060 and xfl7015 series files
    [UNITED_INDUCTORS_DATA_BASE.csv, XFL5015_part_numbers.csv, XFL5018_part_numbers.csv, XFL5030_part_numbers.csv, XFL6012_part_numbers.csv, XFL6060_part_numbers.csv, XFL7015_part_numbers.csv]
2024-11-02 add colored prints
2024-11-02 add max_dc_resistance property
    [UNITED_INDUCTORS_DATA_BASE.csv, XAL1010_part_numbers.csv, XAL1030_part_numbers.csv, XAL1060_part_numbers.csv, XAL1080_part_numbers.csv, XAL1350_part_numbers.csv, XAL1510_part_numbers.csv, XAL1513_part_numbers.csv]
2024-11-03 add CONNECTORS_DATA_BASE
2024-11-03 backup err
    [TBP02R2-381_part_numbers.csv, UNITED_CONNECTORS_DATA_BASE.csv]
2024-11-03 change what mpn are generated
    [TBP02R2-381_part_numbers.csv, UNITED_CONNECTORS_DATA_BASE.csv]
2024-11-03 add color property
    [TBP02R2-381_part_numbers.csv, UNITED_CONNECTORS_DATA_BASE.csv]
2024-11-03 add Pitch field
    [TBP02R2-381_part_numbers.csv, UNITED_CONNECTORS_DATA_BASE.csv]
2024-11-03 update description
    [TBP02R2-381_part_numbers.csv, UNITED_CONNECTORS_DATA_BASE.csv]
2024-11-04 update connector description
2024-11-04 update description field
    [TBP02R2-381_part_numbers.csv, UNITED_CONNECTORS_DATA_BASE.csv]
2024-11-04 add mounting_angle field
    [TBP02R2-381_part_numbers.csv, UNITED_CONNECTORS_DATA_BASE.csv]
2024-11-04 add current_rating and voltage_rating fields
    [TBP02R2-381_part_numbers.csv, UNITED_CONNECTORS_DATA_BASE.csv]
2024-11-04 add mounting_style and contact_plating fields
    [TBP02R2-381_part_numbers.csv, UNITED_CONNECTORS_DATA_BASE.csv]
2024-11-04 update series fields
    [TBP04R2-500_part_numbers.csv, UNITED_CONNECTORS_DATA_BASE.csv]
2024-11-04 add missing mpn
    [TBP04R2-500_part_numbers.csv, UNITED_CONNECTORS_DATA_BASE.csv]
2024-11-04 add new parts
    [CUI_DEVICES_TBP04R3-500-02BE.step, CUI_DEVICES_TBP04R3-500-03BE.step, TBP04R3-500_part_numbers.csv, UNITED_CONNECTORS_DATA_BASE.csv]
2024-11-05 add first
    [CUI_DEVICES_TBP02R1-381-02BE.step, TBP02R1-381_part_numbers.csv, UNITED_CONNECTORS_DATA_BASE.csv]
2024-11-05 add the rest of series components
    [CUI_DEVICES_TBP02R1-381-03BE.step, CUI_DEVICES_TBP02R1-381-04BE.step, CUI_DEVICES_TBP02R1-381-05BE.step, CUI_DEVICES_TBP02R1-381-06BE.step, CUI_DEVICES_TBP02R1-381-07BE.step, CUI_DEVICES_TBP02R1-381-08BE.step, CUI_DEVICES_TBP02R1-381-09BE.step, CUI_DEVICES_TBP02R1-381-10BE.step]
2024-11-06 add 3D models
    [CUI_DEVICES_TBP04R1-500-02BE.step, CUI_DEVICES_TBP04R1-500-03BE.step, CUI_DEVICES_TBP04R1-500-04BE.step, CUI_DEVICES_TBP04R1-500-05BE.step, CUI_DEVICES_TBP04R1-500-06BE.step, CUI_DEVICES_TBP04R1-500-07BE.step, CUI_DEVICES_TBP04R1-500-08BE.step, CUI_DEVICES_TBP04R1-500-09BE.step]
2024-11-06 add TBP04R1-500 and TBP04R12-500 series parts
    [TBP04R1-500_part_numbers.csv, TBP04R12-500_part_numbers.csv, UNITED_CONNECTORS_DATA_BASE.csv]
2024-11-06 optimize the footprint generator script and update files
2024-11-06 add first series part
    [CUI_DEVICES_TB004-508-02BE.step, TB004-508_part_numbers.csv, UNITED_CONNECTORS_DATA_BASE.csv]
2024-11-06 rename file
    [CUI_DEVICES_TB004-508-04BE.step]
2024-11-06 update CUI_DEVICES_TB004-508-04BE
    [CUI_DEVICES_TB004-508-04BE.step]
2024-11-06 update CUI_DEVICES_TB004-508-03BE
    [CUI_DEVICES_TB004-508-03BE.step]
2024-11-06 update CUI_DEVICES_TB004-508-05BE
    [CUI_DEVICES_TB004-508-05BE.step]
2024-11-06 add CUI_DEVICES_TB004-508-06BE
    [CUI_DEVICES_TB004-508-06BE.step, TB004-508_part_numbers.csv, UNITED_CONNECTORS_DATA_BASE.csv]
2024-11-06 add CUI_DEVICES_TB004-508-07BE and CUI_DEVICES_TB004-508-08BE
    [CUI_DEVICES_TB004-508-07BE.step, CUI_DEVICES_TB004-508-08BE.step, TB004-508_part_numbers.csv, UNITED_CONNECTORS_DATA_BASE.csv]
2024-11-06 add CUI_DEVICES_TB004-508-09BE and CUI_DEVICES_TB004-508-10BE
    [CUI_DEVICES_TB004-508-09BE.step, CUI_DEVICES_TB004-508-10BE.step, TB004-508_part_numbers.csv, UNITED_CONNECTORS_DATA_BASE.csv]
2024-11-06 add CUI_DEVICES_TB004-508-12BE and CUI_DEVICES_TB004-508-18BE
    [CUI_DEVICES_TB004-508-12BE.step, CUI_DEVICES_TB004-508-18BE.step, TB004-508_part_numbers.csv, UNITED_CONNECTORS_DATA_BASE.csv]
2024-11-06 add the rest of the parts
    [CUI_DEVICES_TB004-508-11BE.step, CUI_DEVICES_TB004-508-13BE.step, CUI_DEVICES_TB004-508-14BE.step, CUI_DEVICES_TB004-508-15BE.step, CUI_DEVICES_TB004-508-16BE.step, CUI_DEVICES_TB004-508-17BE.step, CUI_DEVICES_TB004-508-19BE.step, CUI_DEVICES_TB004-508-20BE.step]
2024-11-07 add first 2 parts from TB006-508 series
    [CUI_DEVICES_TB006-508-02BE.step, CUI_DEVICES_TB006-508-03BE.step, TB006-508_part_numbers.csv, UNITED_CONNECTORS_DATA_BASE.csv]
2024-11-07 add TB006-508-04BE
    [CUI_DEVICES_TB006-508-04BE.step, TB006-508_part_numbers.csv, UNITED_CONNECTORS_DATA_BASE.csv]
2024-11-08 add the next 5 parts
    [CUI_DEVICES_TB006-508-08BE.step, CUI_DEVICES_TB006-508-09BE.step, CUI_DEVICES_TB006-508-10BE.step, CUI_DEVICES_TB006-508-11BE.step, CUI_DEVICES_TB006-508-12BE.step, TB006-508_part_numbers.csv, UNITED_CONNECTORS_DATA_BASE.csv]
2024-11-08 add the next 6 parts
    [CUI_DEVICES_TB006-508-13BE.step, CUI_DEVICES_TB006-508-14BE.step, CUI_DEVICES_TB006-508-15BE.step, CUI_DEVICES_TB006-508-16BE.step, CUI_DEVICES_TB006-508-17BE.step, CUI_DEVICES_TB006-508-18BE.step, TB006-508_part_numbers.csv, UNITED_CONNECTORS_DATA_BASE.csv]
2024-11-08 add the last 6 parts
    [CUI_DEVICES_TB006-508-19BE.step, CUI_DEVICES_TB006-508-20BE.step, CUI_DEVICES_TB006-508-21BE.step, CUI_DEVICES_TB006-508-22BE.step, CUI_DEVICES_TB006-508-23BE.step, CUI_DEVICES_TB006-508-24BE.step, TB006-508_part_numbers.csv, UNITED_CONNECTORS_DATA_BASE.csv]
2024-11-08 customize footprint generator script
2024-11-08 update footprint generator script
2024-11-08 refactor the footprint generator script
2024-11-10 change 3d models coordonates
    [CUI_DEVICES_TBP04R3-500-02BE.step, CUI_DEVICES_TBP04R3-500-03BE.step, CUI_DEVICES_TBP04R3-500-04BE.step, CUI_DEVICES_TBP04R3-500-05BE.step, CUI_DEVICES_TBP04R3-500-06BE.step]
2024-11-10 change 3d models coordonates for TBP04R2-500 series
    [CUI_DEVICES_TBP04R2-500-02BE.step, CUI_DEVICES_TBP04R2-500-03BE.step, CUI_DEVICES_TBP04R2-500-04BE.step, CUI_DEVICES_TBP04R2-500-05BE.step, CUI_DEVICES_TBP04R2-500-06BE.step, CUI_DEVICES_TBP04R2-500-07BE.step, CUI_DEVICES_TBP04R2-500-08BE.step, CUI_DEVICES_TBP04R2-500-09BE.step]
2024-11-10 change 3d models coordonates for TBP04R1-500 series
    [CUI_DEVICES_TBP04R1-500-02BE.step, CUI_DEVICES_TBP04R1-500-03BE.step, CUI_DEVICES_TBP04R1-500-04BE.step, CUI_DEVICES_TBP04R1-500-05BE.step, CUI_DEVICES_TBP04R1-500-06BE.step, CUI_DEVICES_TBP04R1-500-07BE.step, CUI_DEVICES_TBP04R1-500-08BE.step, CUI_DEVICES_TBP04R1-500-09BE.step]
2024-11-10 update 3
    [CUI_DEVICES_TBP02R1-381-02BE.step, CUI_DEVICES_TBP02R1-381-03BE.step, CUI_DEVICES_TBP02R1-381-04BE.step, CUI_DEVICES_TBP02R1-381-05BE.step, CUI_DEVICES_TBP02R1-381-06BE.step, CUI_DEVICES_TBP02R1-381-07BE.step, CUI_DEVICES_TBP02R1-381-08BE.step, CUI_DEVICES_TBP02R1-381-09BE.step]
2024-11-11 change 3d models coordonates for TBP02R2-381 series and regenerate files
    [CUI_DEVICES_TBP02R2-381-02BE.step, CUI_DEVICES_TBP02R2-381-03BE.step, CUI_DEVICES_TBP02R2-381-04BE.step, CUI_DEVICES_TBP02R2-381-05BE.step, CUI_DEVICES_TBP02R2-381-06BE.step, CUI_DEVICES_TBP02R2-381-07BE.step, CUI_DEVICES_TBP02R2-381-08BE.step, CUI_DEVICES_TBP02R2-381-09BE.step]
2024-11-11 change 3d models coordonates for TBP04R12-500 series and regenerate files
    [CUI_DEVICES_TBP04R12-500-02BE.step, CUI_DEVICES_TBP04R12-500-03BE.step, CUI_DEVICES_TBP04R12-500-04BE.step, CUI_DEVICES_TBP04R12-500-05BE.step, CUI_DEVICES_TBP04R12-500-06BE.step, CUI_DEVICES_TBP04R12-500-07BE.step, CUI_DEVICES_TBP04R12-500-08BE.step, CUI_DEVICES_TBP04R12-500-09BE.step]
2024-11-11 change 3d models coordonates for TBP04R12-500 series
    [CUI_DEVICES_TBP04R12-500-02BE.step, CUI_DEVICES_TBP04R12-500-03BE.step, CUI_DEVICES_TBP04R12-500-04BE.step, CUI_DEVICES_TBP04R12-500-05BE.step, CUI_DEVICES_TBP04R12-500-06BE.step, CUI_DEVICES_TBP04R12-500-07BE.step, CUI_DEVICES_TBP04R12-500-08BE.step, CUI_DEVICES_TBP04R12-500-09BE.step]
2024-11-14 add 3D files
    [R_0402.step, R_0603.step, R_0805.step, R_1206.step]
2024-11-14 regenerate files
    [ERJ2RK_part_numbers.csv, ERJ3EK_part_numbers.csv, ERJ6EN_part_numbers.csv, ERJP03_part_numbers.csv, ERJP06_part_numbers.csv, ERJP08_part_numbers.csv, UNITED_RESISTORS_DATA_BASE.csv]
2024-11-14 regenerate footprints
2024-11-14 change footprint name and value
2024-11-15 regenerate some footprints
2024-11-16 minor updates
    [XAL1010.step]
2024-11-16 add XAL1030
    [XAL1030.step]
2024-11-16 add XAL1060 and XAL1080
    [UNITED_INDUCTORS_DATA_BASE.csv, XAL1060.step, XAL1060_part_numbers.csv, XAL1080.step, XAL1080_part_numbers.csv]
2024-11-16 add XAL1350
    [UNITED_INDUCTORS_DATA_BASE.csv, XAL1350.step, XAL1350_part_numbers.csv]
2024-11-16 add XAL1510
    [UNITED_INDUCTORS_DATA_BASE.csv, XAL1510.step, XAL1510_part_numbers.csv]
2024-11-16 add XAL1513
    [UNITED_INDUCTORS_DATA_BASE.csv, XAL1513.step, XAL1513_part_numbers.csv]
2024-11-16 add XAL1580
    [UNITED_INDUCTORS_DATA_BASE.csv, XAL1580.step, XAL1580_part_numbers.csv]
2024-11-16 add XAL4020, XAL4030 and XAL4040
    [UNITED_INDUCTORS_DATA_BASE.csv, XAL4020.step, XAL4020_part_numbers.csv, XAL4030.step, XAL4030_part_numbers.csv, XAL4040.step, XAL4040_part_numbers.csv]
2024-11-16 add XAL5020, XAL5030 and XAL5050
    [UNITED_INDUCTORS_DATA_BASE.csv, XAL5020.step, XAL5020_part_numbers.csv, XAL5030.step, XAL5030_part_numbers.csv, XAL5050.step, XAL5050_part_numbers.csv]
2024-11-16 add XAL6020, XAL6030 and XAL6060
    [UNITED_INDUCTORS_DATA_BASE.csv, XAL6020.step, XAL6020_part_numbers.csv, XAL6030.step, XAL6030_part_numbers.csv, XAL6060.step, XAL6060_part_numbers.csv]
2024-11-16 add XAL7020, XAL7030, XAL7050 and XAL7070
    [UNITED_INDUCTORS_DATA_BASE.csv, XAL7020.step, XAL7020_part_numbers.csv, XAL7030.step, XAL7030_part_numbers.csv, XAL7050.step, XAL7050_part_numbers.csv, XAL7070.step]
2024-11-16 add XAL8050 and XAL8080
    [UNITED_INDUCTORS_DATA_BASE.csv, XAL8050.step, XAL8050_part_numbers.csv, XAL8080.step, XAL8080_part_numbers.csv]
2024-11-16 add XFL2005, XFL2006 and XFL2010
    [UNITED_INDUCTORS_DATA_BASE.csv, XFL2005.step, XFL2005_part_numbers.csv, XFL2006.step, XFL2006_part_numbers.csv, XFL2010.step, XFL2010_part_numbers.csv]
2024-11-16 add XFL3010 and XFL3012
    [UNITED_INDUCTORS_DATA_BASE.csv, XFL3010.step, XFL3010_part_numbers.csv, XFL3012.step, XFL3012_part_numbers.csv]
2024-11-16 add XFL4012, XFL4015, XFL4020 and XFL4030
    [UNITED_INDUCTORS_DATA_BASE.csv, XFL4012.step, XFL4012_part_numbers.csv, XFL4015.step, XFL4015_part_numbers.csv, XFL4020.step, XFL4020_part_numbers.csv, XFL4030.step]
2024-11-16 add XFL5015, XFL5018 and XFL5030
    [UNITED_INDUCTORS_DATA_BASE.csv, XFL5015.step, XFL5015_part_numbers.csv, XFL5018.step, XFL5018_part_numbers.csv, XFL5030.step, XFL5030_part_numbers.csv]
2024-11-16 add XFL6012, XFL6060 and XFL7015
    [UNITED_INDUCTORS_DATA_BASE.csv, XFL6012.step, XFL6012_part_numbers.csv, XFL6060.step, XFL6060_part_numbers.csv, XFL7015.step, XFL7015_part_numbers.csv]
2024-11-17 refactor footprint generation script
2024-11-17 regenerate capacitor footprints
2024-11-17 regenerate resistor footprints
2024-11-18 move custom print messages in another module
2024-11-18 center 3D models for TBP02R1-381 series
    [CUI_DEVICES_TBP02R1-381-03BE.step, CUI_DEVICES_TBP02R1-381-04BE.step, CUI_DEVICES_TBP02R1-381-05BE.step, CUI_DEVICES_TBP02R1-381-06BE.step, CUI_DEVICES_TBP02R1-381-07BE.step, CUI_DEVICES_TBP02R1-381-08BE.step, CUI_DEVICES_TBP02R1-381-09BE.step, CUI_DEVICES_TBP02R1-381-10BE.step]
2024-11-18 center 3D models for TBP02R2-381 series
    [CUI_DEVICES_TBP02R2-381-03BE.step, CUI_DEVICES_TBP02R2-381-04BE.step, CUI_DEVICES_TBP02R2-381-05BE.step, CUI_DEVICES_TBP02R2-381-06BE.step, CUI_DEVICES_TBP02R2-381-07BE.step, CUI_DEVICES_TBP02R2-381-08BE.step, CUI_DEVICES_TBP02R2-381-09BE.step, CUI_DEVICES_TBP02R2-381-10BE.step]
2024-11-18 center 3D models for TBP04R1-500
    [CUI_DEVICES_TBP04R1-500-03BE.step, CUI_DEVICES_TBP04R1-500-04BE.step, CUI_DEVICES_TBP04R1-500-05BE.step, CUI_DEVICES_TBP04R1-500-06BE.step, CUI_DEVICES_TBP04R1-500-07BE.step, CUI_DEVICES_TBP04R1-500-08BE.step, CUI_DEVICES_TBP04R1-500-09BE.step, CUI_DEVICES_TBP04R1-500-10BE.step]
2024-11-18 center 3D models for TBP04R2-500
    [CUI_DEVICES_TBP04R2-500-03BE.step, CUI_DEVICES_TBP04R2-500-04BE.step, CUI_DEVICES_TBP04R2-500-05BE.step, CUI_DEVICES_TBP04R2-500-06BE.step, CUI_DEVICES_TBP04R2-500-07BE.step, CUI_DEVICES_TBP04R2-500-08BE.step, CUI_DEVICES_TBP04R2-500-09BE.step, CUI_DEVICES_TBP04R2-500-10BE.step]
2024-11-18 center 3D models for TBP04R3-500
    [CUI_DEVICES_TBP04R3-500-03BE.step, CUI_DEVICES_TBP04R3-500-04BE.step, CUI_DEVICES_TBP04R3-500-05BE.step, CUI_DEVICES_TBP04R3-500-06BE.step]
2024-11-18 center 3D models for TBP04R12-500
    [CUI_DEVICES_TBP04R12-500-03BE.step, CUI_DEVICES_TBP04R12-500-04BE.step, CUI_DEVICES_TBP04R12-500-05BE.step, CUI_DEVICES_TBP04R12-500-06BE.step, CUI_DEVICES_TBP04R12-500-07BE.step, CUI_DEVICES_TBP04R12-500-08BE.step, CUI_DEVICES_TBP04R12-500-09BE.step, CUI_DEVICES_TBP04R12-500-10BE.step]
2024-11-18 add CL31 series
    [CL31_part_numbers.csv, UNITED_CAPACITORS_DATA_BASE.csv]
2024-11-18 regenerate CL31 series files
    [CL31_part_numbers.csv, UNITED_CAPACITORS_DATA_BASE.csv]
2024-11-19 add 3D model
    [MSD7342.step]
2024-11-19 generate files
    [MSD7342_part_numbers.csv, UNITED_COUPLED_INDUCTORS_DATA_BASE.csv]
2024-11-20 add coupled inductors app page
2024-11-20 add support for MSD1048 series
    [MSD1048.step]
2024-11-20 add support for MSD1260 series
    [MSD1260.step]
2024-11-20 update pin 1 indicator
2024-11-20 update on pin config
2024-11-23 restructure capacitor scripts
2024-11-23 restructure resistor scripts
2024-11-23 restructure coupled inductors scripts
2024-11-23 restructure connector scripts
2024-11-23 format footprint_capacitor_generator
2024-11-23 format footprint_capacitor_specs
2024-11-23 regenerate capacitor files
2024-11-23 format connector scripts
2024-11-23 regenerate connector files
2024-11-23 format coupled inductor scripts
2024-11-23 regenerate coupled inductor files
2024-11-24 format resistor scripts
2024-11-24 regenerate all kicad files
2024-11-24 regenerate resistor files
2024-11-24 regenerate resistor and capacitor footprints
2024-11-26 generate dioded files
    [DFLS1200-7_part_numbers.csv, UNITED_DIODES_DATA_BASE.csv]
2024-11-26 add diode app page
2024-11-26 regenerate diode files
    [DFLS1200-7_part_numbers.csv, UNITED_DIODES_DATA_BASE.csv]
2024-11-26 update diode symbol
2024-11-26 add diode_type property
2024-11-26 fix footprint path
2024-11-26 add PowerDI_123 3d model
    [D_PowerDI_123.step]
2024-11-26 renama 3d model
    [PowerDI_123.step]
2024-11-26 move all footprints directories in footprints directori
2024-11-28 major rework for diode scripts
2024-11-29 regenerate connector footprints
2024-11-30 work on new diode series generation
2024-11-30 add SOD_123
    [SOD_123.step]
2024-11-30 regenerate diode footprints
2024-12-02 add PowerPAK 1212-8 3d model
    [PowerPAK 1212-8.step]
2024-12-02 generate transistor files
    [SI7309DN-T1-GE3_part_numbers.csv, UNITED_TRANSISTORS_DATA_BASE.csv]
2024-12-02 regenerate footprint
2024-12-03 add PSMN075-100MSEX
    [LFPAK33-8.step]
2024-12-03 minor changes
    [PowerPAK 1212-8.step]
2024-12-03 regenerate transistor files
    [BUK9M120-100EX_part_numbers.csv, BUK9M156-100EX_part_numbers.csv, BUK9M34-100EX_part_numbers.csv, BUK9M43-100EX_part_numbers.csv, PSMN040-100MSEX_part_numbers.csv, UNITED_TRANSISTORS_DATA_BASE.csv]
2024-12-04 Update clone and visitor statistics for 2024-12-04 08:53:39
    [clones_history.csv, visitors_history.csv]
2024-12-04 Update clone and visitor statistics for 2024-12-04 09:05:58
    [clones_history.csv, visitors_history.csv]
2024-12-04 Update clone and visitor statistics for 2024-12-04 09:42:41
    [clones_history.csv, visitors_history.csv]
2024-12-04 Update clone and visitor statistics for 2024-12-04 12:30:55
    [clones_history.csv, visitors_history.csv]
2024-12-04 change trace colors
2024-12-04 Update clone and visitor statistics for 2024-12-04 12:56:54
    [clones_history.csv, visitors_history.csv]
2024-12-04 Update clone and visitor statistics for 2024-12-04 18:21:36
    [visitors_history.csv]
2024-12-04 Update clone and visitor statistics for 2024-12-04 20:19:58
    [clones_history.csv, visitors_history.csv]
2024-12-05 Update clone and visitor statistics for 2024-12-05 01:13:09
    [clones_history.csv, visitors_history.csv]
2024-12-05 Update clone and visitor statistics for 2024-12-05 06:21:50
    [clones_history.csv, visitors_history.csv]
2024-12-05 Update clone and visitor statistics for 2024-12-05 07:01:17
    [clones_history.csv, visitors_history.csv]
2024-12-05 Update clone and visitor statistics for 2024-12-05 08:54:09
    [clones_history.csv, visitors_history.csv]
2024-12-05 Update clone and visitor statistics for 2024-12-05 09:18:32
    [clones_history.csv, visitors_history.csv]
2024-12-05 Update clone and visitor statistics for 2024-12-05 10:32:22
    [visitors_history.csv]
2024-12-05 Update clone and visitor statistics for 2024-12-05 10:35:05
    [clones_history.csv, visitors_history.csv]
2024-12-05 Update clone and visitor statistics for 2024-12-05 14:09:56
    [clones_history.csv, visitors_history.csv]
2024-12-05 update footprint dimensions
2024-12-05 Update clone and visitor statistics for 2024-12-05 17:39:40
    [clones_history.csv, visitors_history.csv]
2024-12-05 Update clone and visitor statistics for 2024-12-05 17:42:52
    [clones_history.csv, visitors_history.csv]
2024-12-06 Update clone and visitor statistics for 2024-12-06 01:12:00
    [clones_history.csv, visitors_history.csv]
2024-12-06 Update clone and visitor statistics for 2024-12-06 06:21:37
    [clones_history.csv, visitors_history.csv]
2024-12-06 Update clone and visitor statistics for 2024-12-06 12:30:07
    [clones_history.csv, visitors_history.csv]
2024-12-06 Update clone and visitor statistics for 2024-12-06 13:50:03
    [clones_history.csv]
2024-12-06 Update clone and visitor statistics for 2024-12-06 13:52:49
    [clones_history.csv, visitors_history.csv]
2024-12-06 Update clone and visitor statistics for 2024-12-06 16:12:02
    [clones_history.csv, visitors_history.csv]
2024-12-06 Update clone and visitor statistics for 2024-12-06 18:06:00
    [clones_history.csv, visitors_history.csv]
2024-12-07 Update clone and visitor statistics for 2024-12-07 08:54:02
    [clones_history.csv, visitors_history.csv]
2024-12-07 Update clone and visitor statistics for 2024-12-07 11:19:32 EET
    [visitors_history.csv]
2024-12-07 Update clone and visitor statistics for 2024-12-07 13:57:27 EET
    [clones_history.csv, visitors_history.csv]
2024-12-07 Update clone and visitor statistics for 2024-12-07 13:31:05 UTC
    [clones_history.csv, visitors_history.csv]
2024-12-07 Update clone and visitor statistics for 2024-12-07 13:34:31 UTC
    [clones_history.csv, visitors_history.csv]
2024-12-07 Update clone and visitor statistics for 2024-12-07 19:35:26 EET
    [clones_history.csv, visitors_history.csv]
2024-12-07 Update clone and visitor statistics for 2024-12-07 22:01:07 EET
    [clones_history.csv, visitors_history.csv]
2024-12-08 Update clone and visitor statistics for 2024-12-08 02:41:16 EET
    [clones_history.csv, visitors_history.csv]
2024-12-08 Update clone and visitor statistics for 2024-12-08 06:09:34 EET
    [clones_history.csv]
2024-12-08 Update clone and visitor statistics for 2024-12-08 10:01:20 EET
    [clones_history.csv]
2024-12-08 Update clone and visitor statistics for 2024-12-08 13:32:41 EET
    [clones_history.csv, visitors_history.csv]
2024-12-08 Update clone and visitor statistics for 2024-12-08 13:34:53 EET
    [clones_history.csv, visitors_history.csv]
2024-12-08 Update clone and visitor statistics for 2024-12-08 18:01:06 EET
    [clones_history.csv, visitors_history.csv]
2024-12-08 Update clone and visitor statistics for 2024-12-08 21:29:00 EET
    [clones_history.csv, visitors_history.csv]
2024-12-08 Update clone and visitor statistics for 2024-12-08 21:32:38 EET
    [clones_history.csv, visitors_history.csv]
2024-12-09 Update clone and visitor statistics for 2024-12-09 06:01:11 EET
    [clones_history.csv, visitors_history.csv]
2024-12-09 Update clone and visitor statistics for 2024-12-09 10:12:26 EET
    [clones_history.csv]
2024-12-09 Update clone and visitor statistics for 2024-12-09 10:20:52 EET
    [clones_history.csv, visitors_history.csv]
2024-12-09 Update clone and visitor statistics for 2024-12-09 12:15:26 EET
    [clones_history.csv, visitors_history.csv]
2024-12-09 Update clone and visitor statistics for 2024-12-09 13:12:17 EET
    [clones_history.csv, visitors_history.csv]
2024-12-09 add 750315836
    [750315836.step]
2024-12-09 regenerate transformer files
    [750315836_part_numbers.csv, UNITED_TRANSFORMERS_DATA_BASE.csv]
2024-12-09 Update clone and visitor statistics for 2024-12-09 14:25:13 EET
    [clones_history.csv, visitors_history.csv]
2024-12-09 Update clone and visitor statistics for 2024-12-09 14:28:37 EET
    [clones_history.csv]
2024-12-09 add SON_123F 3D model
    [SOD_123F.step]
2024-12-09 Update clone and visitor statistics for 2024-12-09 15:25:12 EET
    [clones_history.csv, visitors_history.csv]
2024-12-09 Update clone and visitor statistics for 2024-12-09 16:13:25 EET
    [clones_history.csv, visitors_history.csv]
2024-12-09 Update clone and visitor statistics for 2024-12-09 17:14:53 EET
    [clones_history.csv]
2024-12-09 Update clone and visitor statistics for 2024-12-09 18:18:07 EET
    [clones_history.csv, visitors_history.csv]
2024-12-09 Update clone and visitor statistics for 2024-12-09 19:11:22 EET
    [clones_history.csv, visitors_history.csv]
2024-12-09 Update clone and visitor statistics for 2024-12-09 19:12:37 EET
    [clones_history.csv, visitors_history.csv]
2024-12-09 small resistor footprint adjustments
2024-12-09 small capacitor footprint adjustments
2024-12-09 regenerte footprints
2024-12-09 Update clone and visitor statistics for 2024-12-09 20:17:37 EET
    [clones_history.csv, visitors_history.csv]
2024-12-09 Update clone and visitor statistics for 2024-12-09 20:19:41 EET
    [clones_history.csv]
2024-12-09 Update clone and visitor statistics for 2024-12-09 21:11:16 EET
    [clones_history.csv, visitors_history.csv]
2024-12-09 Update clone and visitor statistics for 2024-12-09 22:15:55 EET
    [clones_history.csv, visitors_history.csv]
2024-12-09 Update clone and visitor statistics for 2024-12-10 00:13:15 EET
    [clones_history.csv, visitors_history.csv]
2024-12-09 Update clone and visitor statistics for 2024-12-10 01:13:27 EET
    [visitors_history.csv]
2024-12-10 Update clone and visitor statistics for 2024-12-10 03:07:58 EET
    [clones_history.csv]
2024-12-10 Update clone and visitor statistics for 2024-12-10 05:00:57 EET
    [clones_history.csv]
2024-12-10 Update clone and visitor statistics for 2024-12-10 07:15:58 EET
    [clones_history.csv]
2024-12-10 Update clone and visitor statistics for 2024-12-10 09:13:49 EET
    [clones_history.csv, visitors_history.csv]
2024-12-10 Update clone and visitor statistics for 2024-12-10 10:17:08 EET
    [clones_history.csv]
2024-12-10 Update clone and visitor statistics for 2024-12-10 11:05:34 EET
    [visitors_history.csv]
2024-12-10 Update clone and visitor statistics for 2024-12-10 11:13:56 EET
    [clones_history.csv, visitors_history.csv]
2024-12-10 Update clone and visitor statistics for 2024-12-10 12:15:24 EET
    [clones_history.csv, visitors_history.csv]
2024-12-10 add C_1210 3d model
    [C_1210.step]
2024-12-10 Update clone and visitor statistics for 2024-12-10 13:10:55 EET
    [clones_history.csv, visitors_history.csv]
2024-12-10 Update clone and visitor statistics for 2024-12-10 13:12:11 EET
    [clones_history.csv, visitors_history.csv]
2024-12-10 Update clone and visitor statistics for 2024-12-10 14:28:04 EET
    [clones_history.csv, visitors_history.csv]
2024-12-10 Update clone and visitor statistics for 2024-12-10 15:25:01 EET
    [clones_history.csv, visitors_history.csv]
2024-12-10 Update clone and visitor statistics for 2024-12-10 16:13:44 EET
    [clones_history.csv, visitors_history.csv]
2024-12-10 Update clone and visitor statistics for 2024-12-10 17:13:32 EET
    [clones_history.csv]
2024-12-10 Update clone and visitor statistics for 2024-12-10 17:15:05 EET
    [clones_history.csv, visitors_history.csv]
2024-12-10 Update clone and visitor statistics for 2024-12-10 18:17:55 EET
    [clones_history.csv, visitors_history.csv]
2024-12-10 Update clone and visitor statistics for 2024-12-10 19:12:39 EET
    [clones_history.csv, visitors_history.csv]
2024-12-10 Update clone and visitor statistics for 2024-12-10 20:19:45 EET
    [clones_history.csv, visitors_history.csv]
2024-12-10 Update clone and visitor statistics for 2024-12-10 21:11:18 EET
    [clones_history.csv, visitors_history.csv]
2024-12-10 Update clone and visitor statistics for 2024-12-10 22:13:54 EET
    [visitors_history.csv]
2024-12-10 Update clone and visitor statistics for 2024-12-10 22:15:32 EET
    [clones_history.csv]
2024-12-10 Update clone and visitor statistics for 2024-12-11 00:13:01 EET
    [clones_history.csv, visitors_history.csv]
2024-12-10 Update clone and visitor statistics for 2024-12-11 01:11:54 EET
    [clones_history.csv]
2024-12-11 Update clone and visitor statistics for 2024-12-11 03:07:00 EET
    [clones_history.csv]
2024-12-11 Update clone and visitor statistics for 2024-12-11 07:13:56 EET
    [clones_history.csv]
2024-12-11 Update clone and visitor statistics for 2024-12-11 08:19:59 EET
    [clones_history.csv]
2024-12-11 Update clone and visitor statistics for 2024-12-11 09:13:52 EET
    [clones_history.csv, visitors_history.csv]
2024-12-11 Update clone and visitor statistics for 2024-12-11 10:19:03 EET
    [clones_history.csv]
2024-12-11 Update clone and visitor statistics for 2024-12-11 11:14:52 EET
    [clones_history.csv]
2024-12-11 Update clone and visitor statistics for 2024-12-11 12:15:02 EET
    [clones_history.csv, visitors_history.csv]
2024-12-11 Update clone and visitor statistics for 2024-12-11 13:11:44 EET
    [clones_history.csv]
2024-12-11 Update clone and visitor statistics for 2024-12-11 15:23:22 EET
    [visitors_history.csv]
2024-12-11 Update clone and visitor statistics for 2024-12-11 15:24:36 EET
    [clones_history.csv]
2024-12-11 Update clone and visitor statistics for 2024-12-11 16:13:27 EET
    [clones_history.csv, visitors_history.csv]
2024-12-11 Update clone and visitor statistics for 2024-12-11 17:13:20 EET
    [clones_history.csv, visitors_history.csv]
2024-12-11 Update clone and visitor statistics for 2024-12-11 17:14:45 EET
    [clones_history.csv, visitors_history.csv]
2024-12-11 Update clone and visitor statistics for 2024-12-11 18:17:49 EET
    [clones_history.csv]
2024-12-11 update datashhet link for TDK capacitors
2024-12-11 Update clone and visitor statistics for 2024-12-11 20:17:21 EET
    [clones_history.csv]
2024-12-11 Update clone and visitor statistics for 2024-12-11 20:19:19 EET
    [clones_history.csv, visitors_history.csv]
2024-12-11 Update clone and visitor statistics for 2024-12-11 21:11:13 EET
    [clones_history.csv, visitors_history.csv]
2024-12-11 Update clone and visitor statistics for 2024-12-11 22:15:37 EET
    [clones_history.csv]
2024-12-11 Update clone and visitor statistics for 2024-12-11 23:11:24 EET
    [clones_history.csv]
2024-12-11 Update clone and visitor statistics for 2024-12-11 23:12:49 EET
    [clones_history.csv]
2024-12-11 Update clone and visitor statistics for 2024-12-12 00:13:35 EET
    [clones_history.csv]
2024-12-11 Update clone and visitor statistics for 2024-12-12 01:11:55 EET
    [clones_history.csv]
2024-12-11 Update clone and visitor statistics for 2024-12-12 01:13:22 EET
    [clones_history.csv]
2024-12-12 Update clone and visitor statistics for 2024-12-12 02:59:45 EET
    [clones_history.csv]
2024-12-12 Update clone and visitor statistics for 2024-12-12 03:06:34 EET
    [clones_history.csv]
2024-12-12 Update clone and visitor statistics for 2024-12-12 04:58:40 EET
    [clones_history.csv]
2024-12-12 Update clone and visitor statistics for 2024-12-12 07:13:52 EET
    [clones_history.csv]
2024-12-12 Update clone and visitor statistics for 2024-12-12 08:18:09 EET
    [clones_history.csv]
2024-12-12 Update clone and visitor statistics for 2024-12-12 09:13:45 EET
    [clones_history.csv, visitors_history.csv]
2024-12-12 Update clone and visitor statistics for 2024-12-12 10:16:45 EET
    [visitors_history.csv]
2024-12-12 Update clone and visitor statistics for 2024-12-12 10:18:27 EET
    [clones_history.csv, visitors_history.csv]
2024-12-12 Update clone and visitor statistics for 2024-12-12 11:13:26 EET
    [visitors_history.csv]
2024-12-12 Update clone and visitor statistics for 2024-12-12 11:15:00 EET
    [visitors_history.csv]
2024-12-12 Update clone and visitor statistics for 2024-12-12 12:15:08 EET
    [clones_history.csv, visitors_history.csv]
2024-12-12 Update clone and visitor statistics for 2024-12-12 14:28:02 EET
    [clones_history.csv, visitors_history.csv]
2024-12-12 Update clone and visitor statistics for 2024-12-12 15:23:12 EET
    [clones_history.csv]
2024-12-12 Update clone and visitor statistics for 2024-12-12 15:24:32 EET
    [clones_history.csv, visitors_history.csv]
2024-12-12 Update clone and visitor statistics for 2024-12-12 16:13:34 EET
    [clones_history.csv]
2024-12-12 Update clone and visitor statistics for 2024-12-12 17:13:18 EET
    [clones_history.csv]
2024-12-12 Update clone and visitor statistics for 2024-12-12 17:14:40 EET
    [clones_history.csv]
2024-12-12 Update clone and visitor statistics for 2024-12-12 18:17:46 EET
    [clones_history.csv, visitors_history.csv]
2024-12-12 Update clone and visitor statistics for 2024-12-12 19:12:26 EET
    [clones_history.csv]
2024-12-12 Update clone and visitor statistics for 2024-12-12 20:19:17 EET
    [visitors_history.csv]
2024-12-12 Update clone and visitor statistics for 2024-12-12 21:11:20 EET
    [clones_history.csv]
2024-12-12 Update clone and visitor statistics for 2024-12-12 22:14:03 EET
    [clones_history.csv]
2024-12-12 Update clone and visitor statistics for 2024-12-12 23:11:47 EET
    [clones_history.csv]
2024-12-12 Update clone and visitor statistics for 2024-12-13 00:13:22 EET
    [clones_history.csv, visitors_history.csv]
2024-12-12 Update clone and visitor statistics for 2024-12-13 01:12:27 EET
    [clones_history.csv]
2024-12-12 Update clone and visitor statistics for 2024-12-13 01:13:35 EET
    [clones_history.csv]
2024-12-13 Update clone and visitor statistics for 2024-12-13 03:07:53 EET
    [clones_history.csv]
2024-12-13 Update clone and visitor statistics for 2024-12-13 07:13:45 EET
    [clones_history.csv]
2024-12-13 Update clone and visitor statistics for 2024-12-13 08:20:03 EET
    [clones_history.csv]
2024-12-13 Update clone and visitor statistics for 2024-12-13 09:13:35 EET
    [clones_history.csv, visitors_history.csv]
2024-12-13 Update clone and visitor statistics for 2024-12-13 10:16:37 EET
    [clones_history.csv]
2024-12-13 Update clone and visitor statistics for 2024-12-13 10:18:26 EET
    [clones_history.csv]
2024-12-13 Update clone and visitor statistics for 2024-12-13 11:14:38 EET
    [clones_history.csv]
2024-12-13 Update clone and visitor statistics for 2024-12-13 12:14:55 EET
    [clones_history.csv, visitors_history.csv]
2024-12-13 Update clone and visitor statistics for 2024-12-13 13:10:28 EET
    [clones_history.csv]
2024-12-13 Update clone and visitor statistics for 2024-12-13 14:27:02 EET
    [clones_history.csv]
2024-12-13 Update clone and visitor statistics for 2024-12-13 15:23:32 EET
    [clones_history.csv, visitors_history.csv]
2024-12-13 Update clone and visitor statistics for 2024-12-13 16:12:06 EET
    [clones_history.csv]
2024-12-13 Update clone and visitor statistics for 2024-12-13 16:13:11 EET
    [visitors_history.csv]
2024-12-13 Update clone and visitor statistics for 2024-12-13 17:14:12 EET
    [clones_history.csv, visitors_history.csv]
2024-12-13 Update clone and visitor statistics for 2024-12-13 18:16:48 EET
    [clones_history.csv, visitors_history.csv]
2024-12-13 Update clone and visitor statistics for 2024-12-13 19:12:39 EET
    [clones_history.csv, visitors_history.csv]
2024-12-13 add bar charts for resistors and capacitors
2024-12-13 Update clone and visitor statistics for 2024-12-13 20:16:49 EET
    [clones_history.csv]
2024-12-13 Update clone and visitor statistics for 2024-12-13 20:18:50 EET
    [clones_history.csv, visitors_history.csv]
2024-12-13 Update clone and visitor statistics for 2024-12-13 21:11:06 EET
    [clones_history.csv, visitors_history.csv]
2024-12-13 Update clone and visitor statistics for 2024-12-13 22:15:14 EET
    [clones_history.csv]
2024-12-13 Update clone and visitor statistics for 2024-12-14 00:12:54 EET
    [clones_history.csv]
2024-12-13 Update clone and visitor statistics for 2024-12-14 01:13:14 EET
    [clones_history.csv]
2024-12-14 Update clone and visitor statistics for 2024-12-14 03:04:42 EET
    [clones_history.csv]
2024-12-14 Update clone and visitor statistics for 2024-12-14 04:54:00 EET
    [clones_history.csv]
2024-12-14 Update clone and visitor statistics for 2024-12-14 07:12:46 EET
    [clones_history.csv]
2024-12-14 Update clone and visitor statistics for 2024-12-14 09:12:11 EET
    [clones_history.csv]
2024-12-14 Update clone and visitor statistics for 2024-12-14 10:14:33 EET
    [clones_history.csv]
2024-12-14 Update clone and visitor statistics for 2024-12-14 10:16:17 EET
    [clones_history.csv, visitors_history.csv]
2024-12-14 Update clone and visitor statistics for 2024-12-14 11:13:04 EET
    [clones_history.csv, visitors_history.csv]
2024-12-14 Update clone and visitor statistics for 2024-12-14 12:13:06 EET
    [clones_history.csv, visitors_history.csv]
2024-12-14 Update clone and visitor statistics for 2024-12-14 13:10:33 EET
    [clones_history.csv]
2024-12-14 Update clone and visitor statistics for 2024-12-14 14:24:25 EET
    [clones_history.csv]
2024-12-14 Update clone and visitor statistics for 2024-12-14 15:19:56 EET
    [clones_history.csv]
2024-12-14 Update clone and visitor statistics for 2024-12-14 17:10:50 EET
    [clones_history.csv, visitors_history.csv]
2024-12-14 Update clone and visitor statistics for 2024-12-14 17:12:47 EET
    [clones_history.csv, visitors_history.csv]
2024-12-14 Update clone and visitor statistics for 2024-12-14 18:14:56 EET
    [clones_history.csv, visitors_history.csv]
2024-12-14 Update clone and visitor statistics for 2024-12-14 19:09:58 EET
    [clones_history.csv]
2024-12-14 Update clone and visitor statistics for 2024-12-14 19:10:49 EET
    [clones_history.csv, visitors_history.csv]
2024-12-14 Update clone and visitor statistics for 2024-12-14 20:17:05 EET
    [clones_history.csv, visitors_history.csv]
2024-12-14 Update clone and visitor statistics for 2024-12-14 21:09:56 EET
    [clones_history.csv]
2024-12-14 Update clone and visitor statistics for 2024-12-14 22:13:55 EET
    [clones_history.csv]
2024-12-14 Update clone and visitor statistics for 2024-12-15 00:12:22 EET
    [clones_history.csv, visitors_history.csv]
2024-12-14 Update clone and visitor statistics for 2024-12-15 01:12:25 EET
    [clones_history.csv]
2024-12-15 Update clone and visitor statistics for 2024-12-15 03:04:25 EET
    [clones_history.csv]
2024-12-15 Update clone and visitor statistics for 2024-12-15 03:11:55 EET
    [clones_history.csv]
2024-12-15 Update clone and visitor statistics for 2024-12-15 06:16:13 EET
    [clones_history.csv]
2024-12-15 Update clone and visitor statistics for 2024-12-15 07:11:46 EET
    [clones_history.csv]
2024-12-15 Update clone and visitor statistics for 2024-12-15 07:13:00 EET
    [clones_history.csv, visitors_history.csv]
2024-12-15 Update clone and visitor statistics for 2024-12-15 08:18:20 EET
    [clones_history.csv]
2024-12-15 Update clone and visitor statistics for 2024-12-15 09:12:27 EET
    [clones_history.csv]
2024-12-15 Update clone and visitor statistics for 2024-12-15 10:16:36 EET
    [clones_history.csv]
2024-12-15 Update clone and visitor statistics for 2024-12-15 11:11:45 EET
    [clones_history.csv]
2024-12-15 Update clone and visitor statistics for 2024-12-15 11:13:06 EET
    [clones_history.csv, visitors_history.csv]
2024-12-15 Update clone and visitor statistics for 2024-12-15 12:13:38 EET
    [clones_history.csv, visitors_history.csv]
2024-12-15 Update clone and visitor statistics for 2024-12-15 14:24:50 EET
    [clones_history.csv, visitors_history.csv]
2024-12-15 Update clone and visitor statistics for 2024-12-15 15:18:59 EET
    [clones_history.csv]
2024-12-15 Update clone and visitor statistics for 2024-12-15 15:20:11 EET
    [clones_history.csv]
2024-12-15 regenerate inductor files
    [UNITED_INDUCTORS_DATA_BASE.csv]
2024-12-15 Update clone and visitor statistics for 2024-12-15 16:09:58 EET
    [clones_history.csv]
2024-12-15 Update clone and visitor statistics for 2024-12-15 16:11:22 EET
    [clones_history.csv]
2024-12-15 Update clone and visitor statistics for 2024-12-15 17:11:10 EET
    [clones_history.csv]
2024-12-15 Update clone and visitor statistics for 2024-12-15 18:14:53 EET
    [clones_history.csv, visitors_history.csv]
2024-12-15 Update clone and visitor statistics for 2024-12-15 19:11:12 EET
    [clones_history.csv, visitors_history.csv]
2024-12-15 Update clone and visitor statistics for 2024-12-15 20:15:09 EET
    [clones_history.csv]
2024-12-15 Update clone and visitor statistics for 2024-12-15 21:09:59 EET
    [clones_history.csv, visitors_history.csv]
2024-12-15 Update clone and visitor statistics for 2024-12-15 22:12:52 EET
    [clones_history.csv]
2024-12-15 Update clone and visitor statistics for 2024-12-15 23:10:37 EET
    [clones_history.csv]
2024-12-15 Update clone and visitor statistics for 2024-12-16 00:12:27 EET
    [clones_history.csv]
2024-12-15 Update clone and visitor statistics for 2024-12-16 01:12:45 EET
    [clones_history.csv, visitors_history.csv]
2024-12-16 Update clone and visitor statistics for 2024-12-16 03:02:04 EET
    [clones_history.csv]
2024-12-16 Update clone and visitor statistics for 2024-12-16 03:09:27 EET
    [clones_history.csv]
2024-12-16 Update clone and visitor statistics for 2024-12-16 05:02:26 EET
    [clones_history.csv]
2024-12-16 Update clone and visitor statistics for 2024-12-16 06:17:04 EET
    [clones_history.csv]
2024-12-16 Update clone and visitor statistics for 2024-12-16 07:13:18 EET
    [clones_history.csv]
2024-12-16 Update clone and visitor statistics for 2024-12-16 07:14:32 EET
    [clones_history.csv]
2024-12-16 Update clone and visitor statistics for 2024-12-16 09:14:21 EET
    [clones_history.csv, visitors_history.csv]
2024-12-16 Update clone and visitor statistics for 2024-12-16 10:18:05 EET
    [clones_history.csv]
2024-12-16 Update clone and visitor statistics for 2024-12-16 10:19:46 EET
    [clones_history.csv, visitors_history.csv]
2024-12-16 Update clone and visitor statistics for 2024-12-16 12:15:47 EET
    [clones_history.csv]
2024-12-16 Update clone and visitor statistics for 2024-12-16 13:11:01 EET
    [clones_history.csv]
2024-12-16 Update clone and visitor statistics for 2024-12-16 13:12:05 EET
    [clones_history.csv, visitors_history.csv]
2024-12-16 Update clone and visitor statistics for 2024-12-16 14:25:01 EET
    [clones_history.csv]
2024-12-16 Update clone and visitor statistics for 2024-12-16 14:28:36 EET
    [visitors_history.csv]
2024-12-16 Update clone and visitor statistics for 2024-12-16 15:23:31 EET
    [clones_history.csv]
2024-12-16 Update clone and visitor statistics for 2024-12-16 15:24:43 EET
    [clones_history.csv, visitors_history.csv]
2024-12-16 Update clone and visitor statistics for 2024-12-16 16:13:37 EET
    [clones_history.csv]
2024-12-16 Update clone and visitor statistics for 2024-12-16 18:17:39 EET
    [clones_history.csv, visitors_history.csv]
2024-12-16 Update clone and visitor statistics for 2024-12-16 20:17:03 EET
    [clones_history.csv]
2024-12-16 Update clone and visitor statistics for 2024-12-16 20:19:13 EET
    [clones_history.csv, visitors_history.csv]
2024-12-16 Update clone and visitor statistics for 2024-12-16 21:11:17 EET
    [clones_history.csv, visitors_history.csv]
2024-12-16 Update clone and visitor statistics for 2024-12-16 22:13:52 EET
    [clones_history.csv]
2024-12-16 Update clone and visitor statistics for 2024-12-16 22:15:24 EET
    [clones_history.csv]
2024-12-16 Update clone and visitor statistics for 2024-12-16 23:11:50 EET
    [clones_history.csv]
2024-12-16 Update clone and visitor statistics for 2024-12-17 00:12:16 EET
    [clones_history.csv]
2024-12-16 Update clone and visitor statistics for 2024-12-17 01:13:26 EET
    [clones_history.csv]
2024-12-17 Update clone and visitor statistics for 2024-12-17 03:00:09 EET
    [clones_history.csv]
2024-12-17 Update clone and visitor statistics for 2024-12-17 03:06:54 EET
    [clones_history.csv]
2024-12-17 Update clone and visitor statistics for 2024-12-17 07:13:46 EET
    [clones_history.csv]
2024-12-17 Update clone and visitor statistics for 2024-12-17 08:17:43 EET
    [clones_history.csv]
2024-12-17 Update clone and visitor statistics for 2024-12-17 08:20:01 EET
    [clones_history.csv, visitors_history.csv]
2024-12-17 Update clone and visitor statistics for 2024-12-17 09:13:48 EET
    [clones_history.csv, visitors_history.csv]
2024-12-17 Update clone and visitor statistics for 2024-12-17 10:19:02 EET
    [clones_history.csv, visitors_history.csv]
2024-12-17 Update clone and visitor statistics for 2024-12-17 11:13:39 EET
    [clones_history.csv]
2024-12-17 Update clone and visitor statistics for 2024-12-17 11:15:16 EET
    [clones_history.csv]
2024-12-17 Update clone and visitor statistics for 2024-12-17 12:15:09 EET
    [clones_history.csv]
2024-12-17 Update clone and visitor statistics for 2024-12-17 13:11:58 EET
    [visitors_history.csv]
2024-12-17 Update clone and visitor statistics for 2024-12-17 14:24:21 EET
    [clones_history.csv]
2024-12-17 Update clone and visitor statistics for 2024-12-17 14:27:44 EET
    [visitors_history.csv]
2024-12-17 Update clone and visitor statistics for 2024-12-17 15:23:38 EET
    [clones_history.csv]
2024-12-17 Update clone and visitor statistics for 2024-12-17 15:24:36 EET
    [clones_history.csv, visitors_history.csv]
2024-12-17 Update clone and visitor statistics for 2024-12-17 16:13:20 EET
    [clones_history.csv, visitors_history.csv]
2024-12-17 Update clone and visitor statistics for 2024-12-17 17:13:13 EET
    [clones_history.csv]
2024-12-17 Update clone and visitor statistics for 2024-12-17 17:14:42 EET
    [clones_history.csv]
2024-12-17 Update clone and visitor statistics for 2024-12-17 18:17:38 EET
    [clones_history.csv, visitors_history.csv]
2024-12-17 Update clone and visitor statistics for 2024-12-17 19:12:34 EET
    [clones_history.csv, visitors_history.csv]
2024-12-17 Update clone and visitor statistics for 2024-12-17 20:17:33 EET
    [clones_history.csv]
2024-12-17 Update clone and visitor statistics for 2024-12-17 20:19:26 EET
    [clones_history.csv, visitors_history.csv]
2024-12-17 Update clone and visitor statistics for 2024-12-17 21:11:16 EET
    [clones_history.csv, visitors_history.csv]
2024-12-17 Update clone and visitor statistics for 2024-12-17 22:14:51 EET
    [clones_history.csv, visitors_history.csv]
2024-12-17 Update clone and visitor statistics for 2024-12-17 23:09:38 EET
    [clones_history.csv]
2024-12-17 Update clone and visitor statistics for 2024-12-17 23:10:41 EET
    [clones_history.csv]
2024-12-17 Update clone and visitor statistics for 2024-12-18 00:12:51 EET
    [clones_history.csv]
2024-12-17 Update clone and visitor statistics for 2024-12-18 01:12:35 EET
    [clones_history.csv]
2024-12-18 Update clone and visitor statistics for 2024-12-18 03:04:06 EET
    [clones_history.csv, visitors_history.csv]
2024-12-18 Update clone and visitor statistics for 2024-12-18 04:53:49 EET
    [clones_history.csv]
2024-12-18 Update clone and visitor statistics for 2024-12-18 07:13:26 EET
    [clones_history.csv]
2024-12-18 Update clone and visitor statistics for 2024-12-18 08:17:12 EET
    [clones_history.csv]
2024-12-18 Update clone and visitor statistics for 2024-12-18 08:19:01 EET
    [clones_history.csv]
2024-12-18 Update clone and visitor statistics for 2024-12-18 09:13:18 EET
    [clones_history.csv, visitors_history.csv]
2024-12-18 Update clone and visitor statistics for 2024-12-18 10:16:12 EET
    [clones_history.csv]
2024-12-18 Update clone and visitor statistics for 2024-12-18 10:18:32 EET
    [clones_history.csv, visitors_history.csv]
2024-12-18 Update clone and visitor statistics for 2024-12-18 11:14:44 EET
    [clones_history.csv, visitors_history.csv]
2024-12-18 Update clone and visitor statistics for 2024-12-18 12:14:27 EET
    [clones_history.csv, visitors_history.csv]
2024-12-18 Update clone and visitor statistics for 2024-12-18 13:10:18 EET
    [clones_history.csv]
2024-12-18 Update clone and visitor statistics for 2024-12-18 13:11:14 EET
    [clones_history.csv, visitors_history.csv]
2024-12-18 Update clone and visitor statistics for 2024-12-18 14:23:09 EET
    [clones_history.csv]
2024-12-18 Update clone and visitor statistics for 2024-12-18 14:27:00 EET
    [clones_history.csv, visitors_history.csv]
2024-12-18 Update clone and visitor statistics for 2024-12-18 15:22:23 EET
    [clones_history.csv]
2024-12-18 Update clone and visitor statistics for 2024-12-18 16:11:40 EET
    [clones_history.csv]
2024-12-18 Update clone and visitor statistics for 2024-12-18 16:12:59 EET
    [clones_history.csv]
2024-12-18 Update clone and visitor statistics for 2024-12-18 17:12:39 EET
    [clones_history.csv]
2024-12-18 Update clone and visitor statistics for 2024-12-18 17:14:04 EET
    [clones_history.csv]
2024-12-18 Update clone and visitor statistics for 2024-12-18 18:17:02 EET
    [clones_history.csv, visitors_history.csv]
2024-12-18 Update clone and visitor statistics for 2024-12-18 20:18:55 EET
    [clones_history.csv, visitors_history.csv]
2024-12-18 Update clone and visitor statistics for 2024-12-18 21:10:58 EET
    [clones_history.csv]
2024-12-18 Update clone and visitor statistics for 2024-12-18 22:15:04 EET
    [clones_history.csv, visitors_history.csv]
2024-12-18 Update clone and visitor statistics for 2024-12-18 23:10:27 EET
    [clones_history.csv]
2024-12-18 Update clone and visitor statistics for 2024-12-18 23:11:35 EET
    [clones_history.csv]
2024-12-18 Update clone and visitor statistics for 2024-12-19 00:12:51 EET
    [clones_history.csv]
2024-12-18 Update clone and visitor statistics for 2024-12-19 01:11:38 EET
    [clones_history.csv]
2024-12-18 Update clone and visitor statistics for 2024-12-19 01:12:57 EET
    [clones_history.csv, visitors_history.csv]
2024-12-19 Update clone and visitor statistics for 2024-12-19 03:04:52 EET
    [clones_history.csv]
2024-12-19 Update clone and visitor statistics for 2024-12-19 04:22:53 EET
    [clones_history.csv]
2024-12-19 Update clone and visitor statistics for 2024-12-19 04:53:55 EET
    [clones_history.csv]
2024-12-19 Update clone and visitor statistics for 2024-12-19 07:13:36 EET
    [clones_history.csv]
2024-12-19 Update clone and visitor statistics for 2024-12-19 08:17:35 EET
    [clones_history.csv]
2024-12-19 Update clone and visitor statistics for 2024-12-19 08:19:33 EET
    [clones_history.csv, visitors_history.csv]
2024-12-19 Update clone and visitor statistics for 2024-12-19 09:13:31 EET
    [clones_history.csv, visitors_history.csv]
2024-12-19 Update clone and visitor statistics for 2024-12-19 10:16:11 EET
    [clones_history.csv]
2024-12-19 Update clone and visitor statistics for 2024-12-19 10:18:07 EET
    [clones_history.csv, visitors_history.csv]
2024-12-19 Update clone and visitor statistics for 2024-12-19 11:14:33 EET
    [clones_history.csv, visitors_history.csv]
2024-12-19 Update clone and visitor statistics for 2024-12-19 12:14:38 EET
    [clones_history.csv, visitors_history.csv]
2024-12-19 Update clone and visitor statistics for 2024-12-19 13:11:51 EET
    [visitors_history.csv]
2024-12-19 add script to check Yageo URLs for resistors and analyze webpage content
2024-12-19 Update clone and visitor statistics for 2024-12-19 14:23:16 EET
    [clones_history.csv]
2024-12-19 Update clone and visitor statistics for 2024-12-19 14:26:47 EET
    [clones_history.csv]
2024-12-19 update excluded_values in YAGEO_SYMBOLS_SPECS for comprehensive resistance range
2024-12-19 Update clone and visitor statistics for 2024-12-19 15:21:25 EET
    [clones_history.csv]
2024-12-19 Update clone and visitor statistics for 2024-12-19 15:22:27 EET
    [clones_history.csv, visitors_history.csv]
2024-12-19 add excluded_values to YAGEO_SYMBOLS_SPECS for enhanced resistance filtering
2024-12-19 add excluded_values to YAGEO_SYMBOLS_SPECS for improved resistance filtering
2024-12-19 Update clone and visitor statistics for 2024-12-19 16:12:59 EET
    [clones_history.csv, visitors_history.csv]
2024-12-19 update check_url invocation with new part number for Yageo resistor
2024-12-19 add excluded values to YAGEO_SYMBOLS_SPECS for enhanced resistance filtering
2024-12-19 Update clone and visitor statistics for 2024-12-19 17:12:54 EET
    [clones_history.csv]
2024-12-19 Update clone and visitor statistics for 2024-12-19 18:14:32 EET
    [clones_history.csv, visitors_history.csv]
2024-12-19 Update clone and visitor statistics for 2024-12-19 19:09:45 EET
    [clones_history.csv]
2024-12-19 Update clone and visitor statistics for 2024-12-19 19:10:44 EET
    [clones_history.csv]
2024-12-19 Update clone and visitor statistics for 2024-12-19 20:15:59 EET
    [clones_history.csv]
2024-12-19 Update clone and visitor statistics for 2024-12-19 21:10:39 EET
    [clones_history.csv]
2024-12-19 Update clone and visitor statistics for 2024-12-19 22:14:26 EET
    [clones_history.csv]
2024-12-19 add excluded values to YAGEO_SYMBOLS_SPECS for improved resistance filtering
2024-12-19 Update clone and visitor statistics for 2024-12-19 23:10:45 EET
    [clones_history.csv]
2024-12-19 Update clone and visitor statistics for 2024-12-19 23:12:06 EET
    [clones_history.csv]
